btb/Telcon-Ambassador/photos/printer mechanism/IMG_4826.jpg

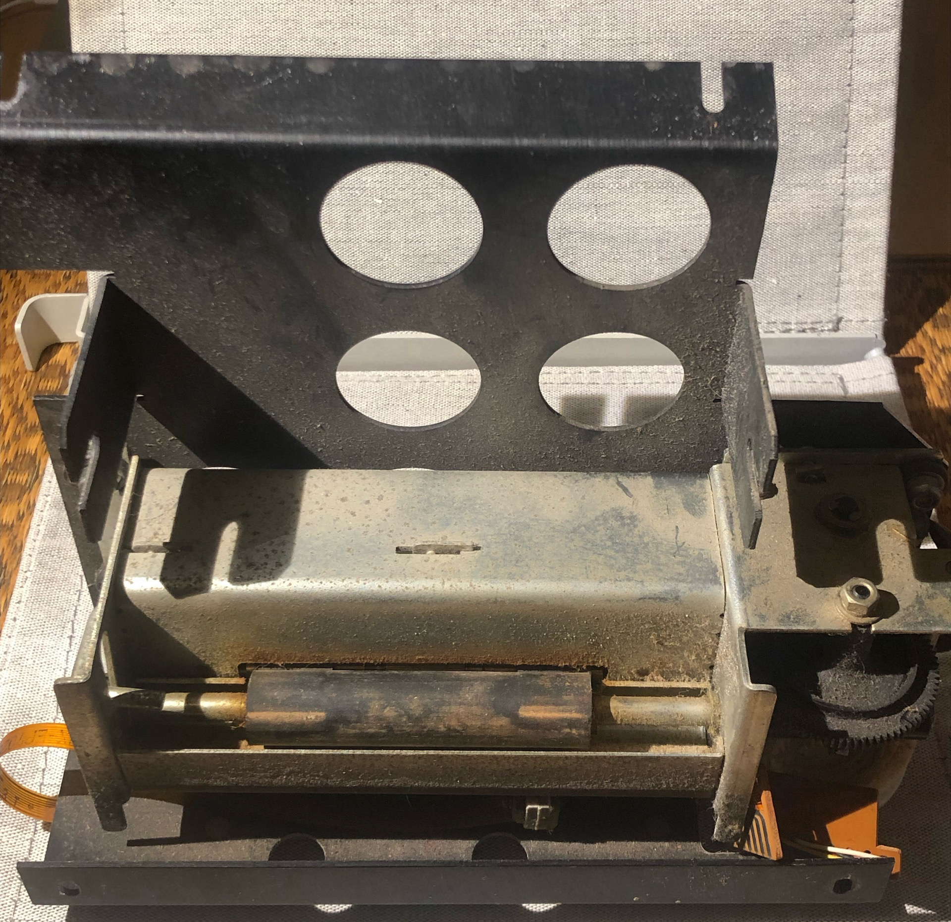
photos/printer mechanism/IMG_4826.jpg
