btb/Telcon-Ambassador/photos/printer mechanism/IMG_4764.jpg

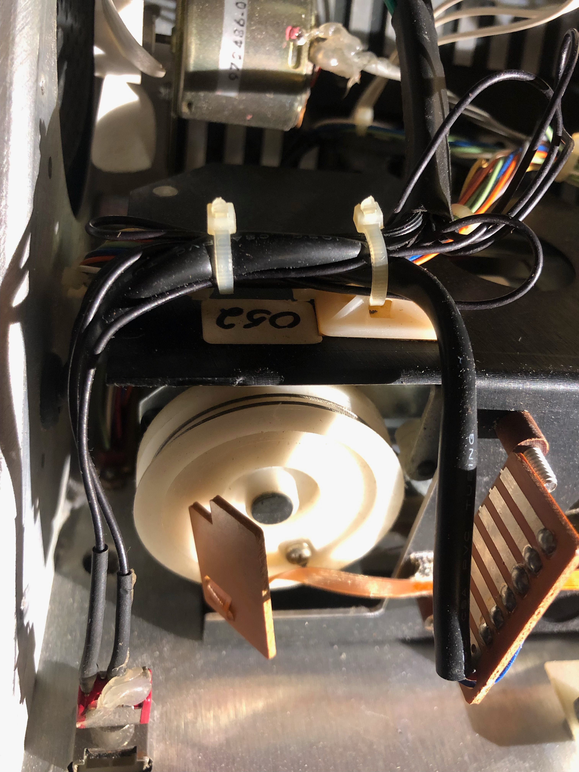
photos/printer mechanism/IMG_4764.jpg
