btb/Telcon-Ambassador/README.md

# Telcon Ambassador Portable Terminals

The Telcon Ambassador was a series of portable terminals by Telcon Industries (who later created the Zorba portable computer).

The info here is primarily derived from my reverse-engineering of a Telcon Ambassador IV which I acquired in very rough shape.
