btb/Telcon-Ambassador/photos/keyboard pcb/bottom_1.jpg

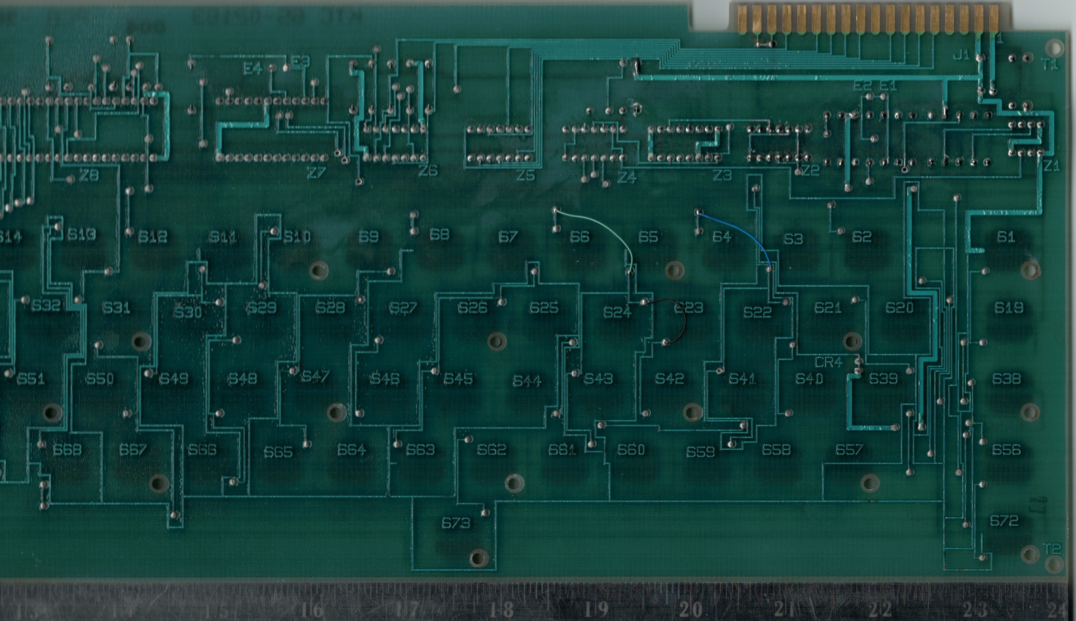
photos/keyboard pcb/bottom_1.jpg
