btb/Telcon-Ambassador/photos/keyboard pcb/bottom_2.jpg

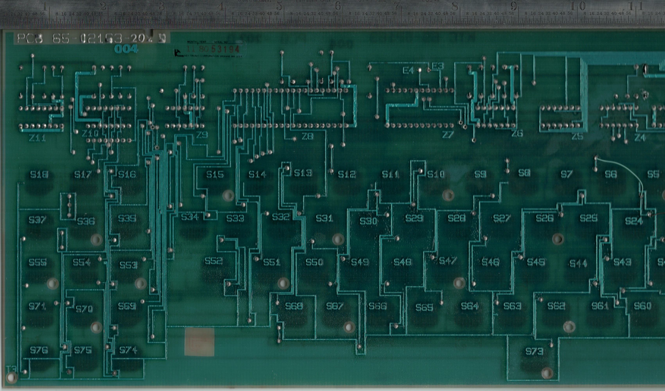
photos/keyboard pcb/bottom_2.jpg
