btb/Telcon-Ambassador/photos/ladouceur/Ladouceur_Telcon_1.jpg

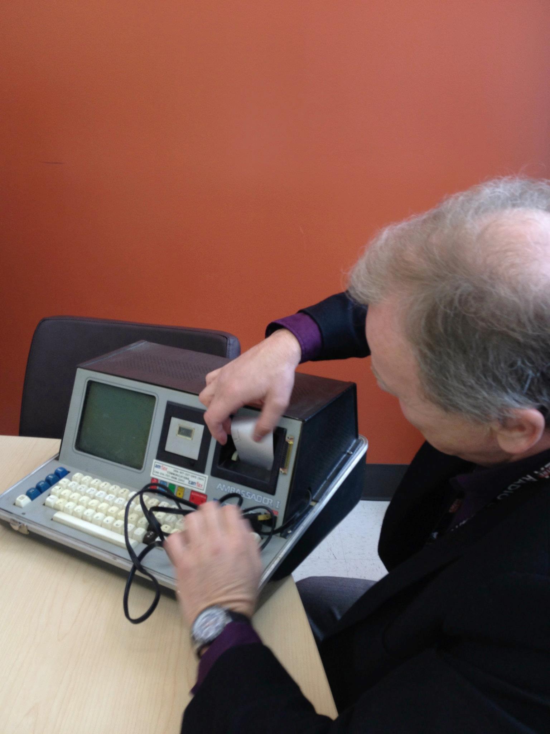
photos/ladouceur/Ladouceur_Telcon_1.jpg
