btb/Telcon-Ambassador/photos/ladouceur/Ladouceur_Telcon_2.jpg

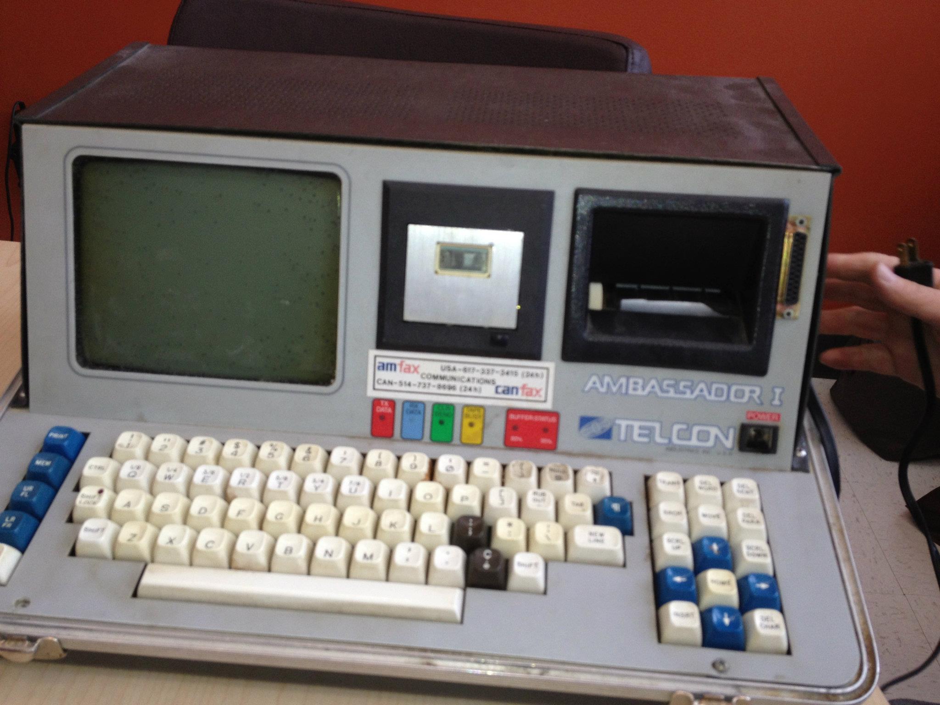
photos/ladouceur/Ladouceur_Telcon_2.jpg
