btb/Telcon-Ambassador/photos/printer mechanism/IMG_4766.jpg

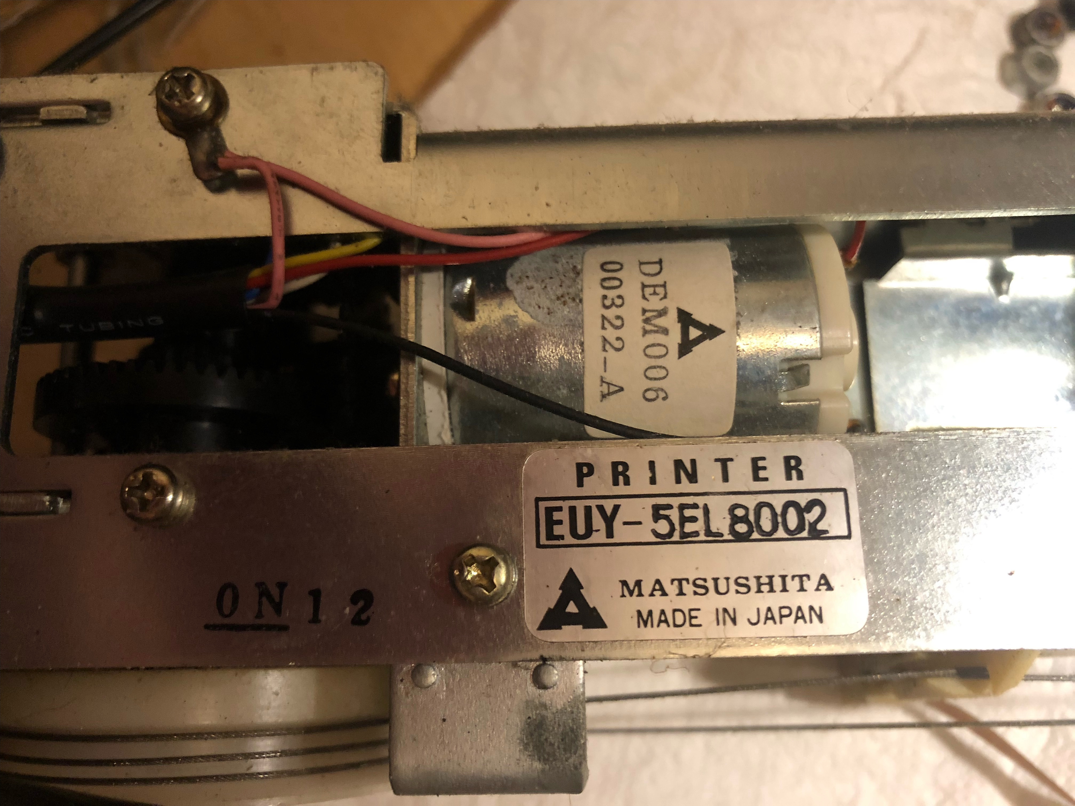
photos/printer mechanism/IMG_4766.jpg
