btb/Telcon-Ambassador/photos/printer pcb/bottom.jpg

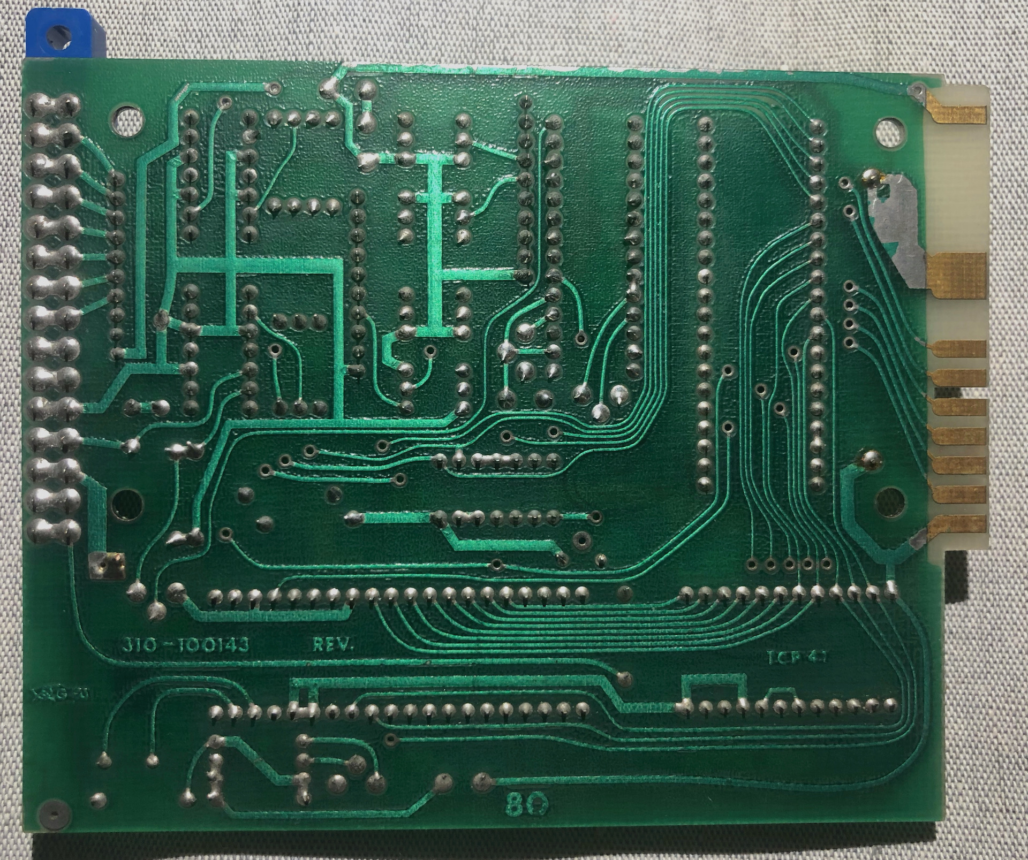
photos/printer pcb/bottom.jpg
