btb/Telcon-Ambassador/photos/printer pcb/top.jpg

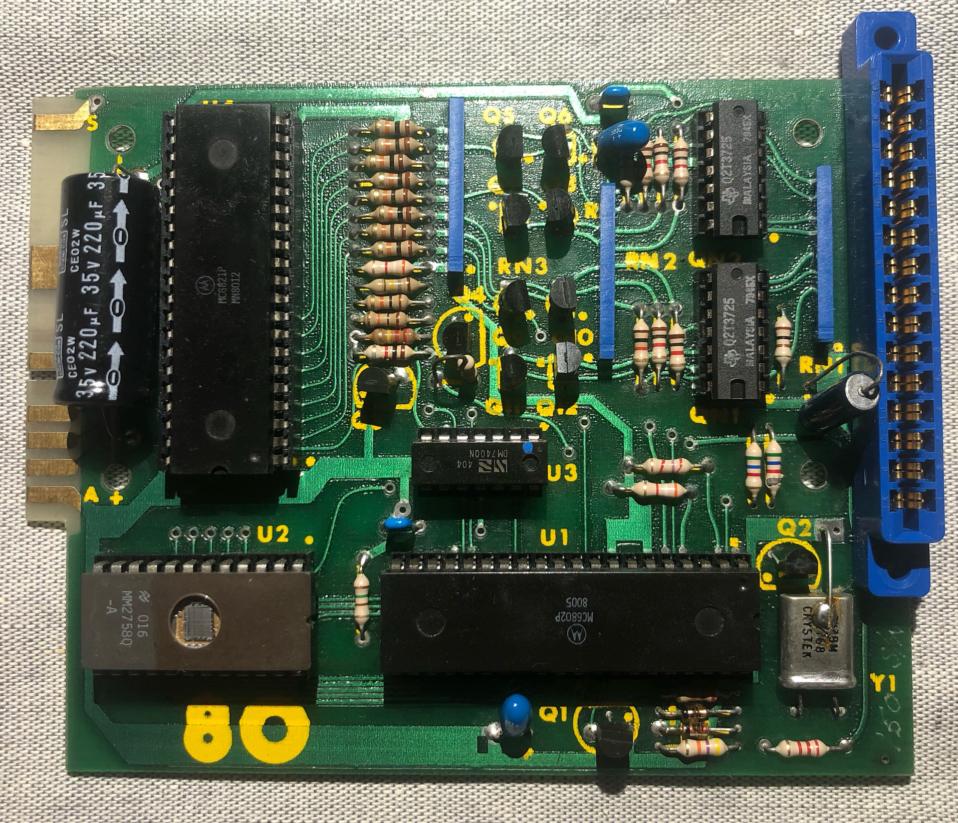
photos/printer pcb/top.jpg
