btb/Telcon-Ambassador/boards/printer/printer.pdf

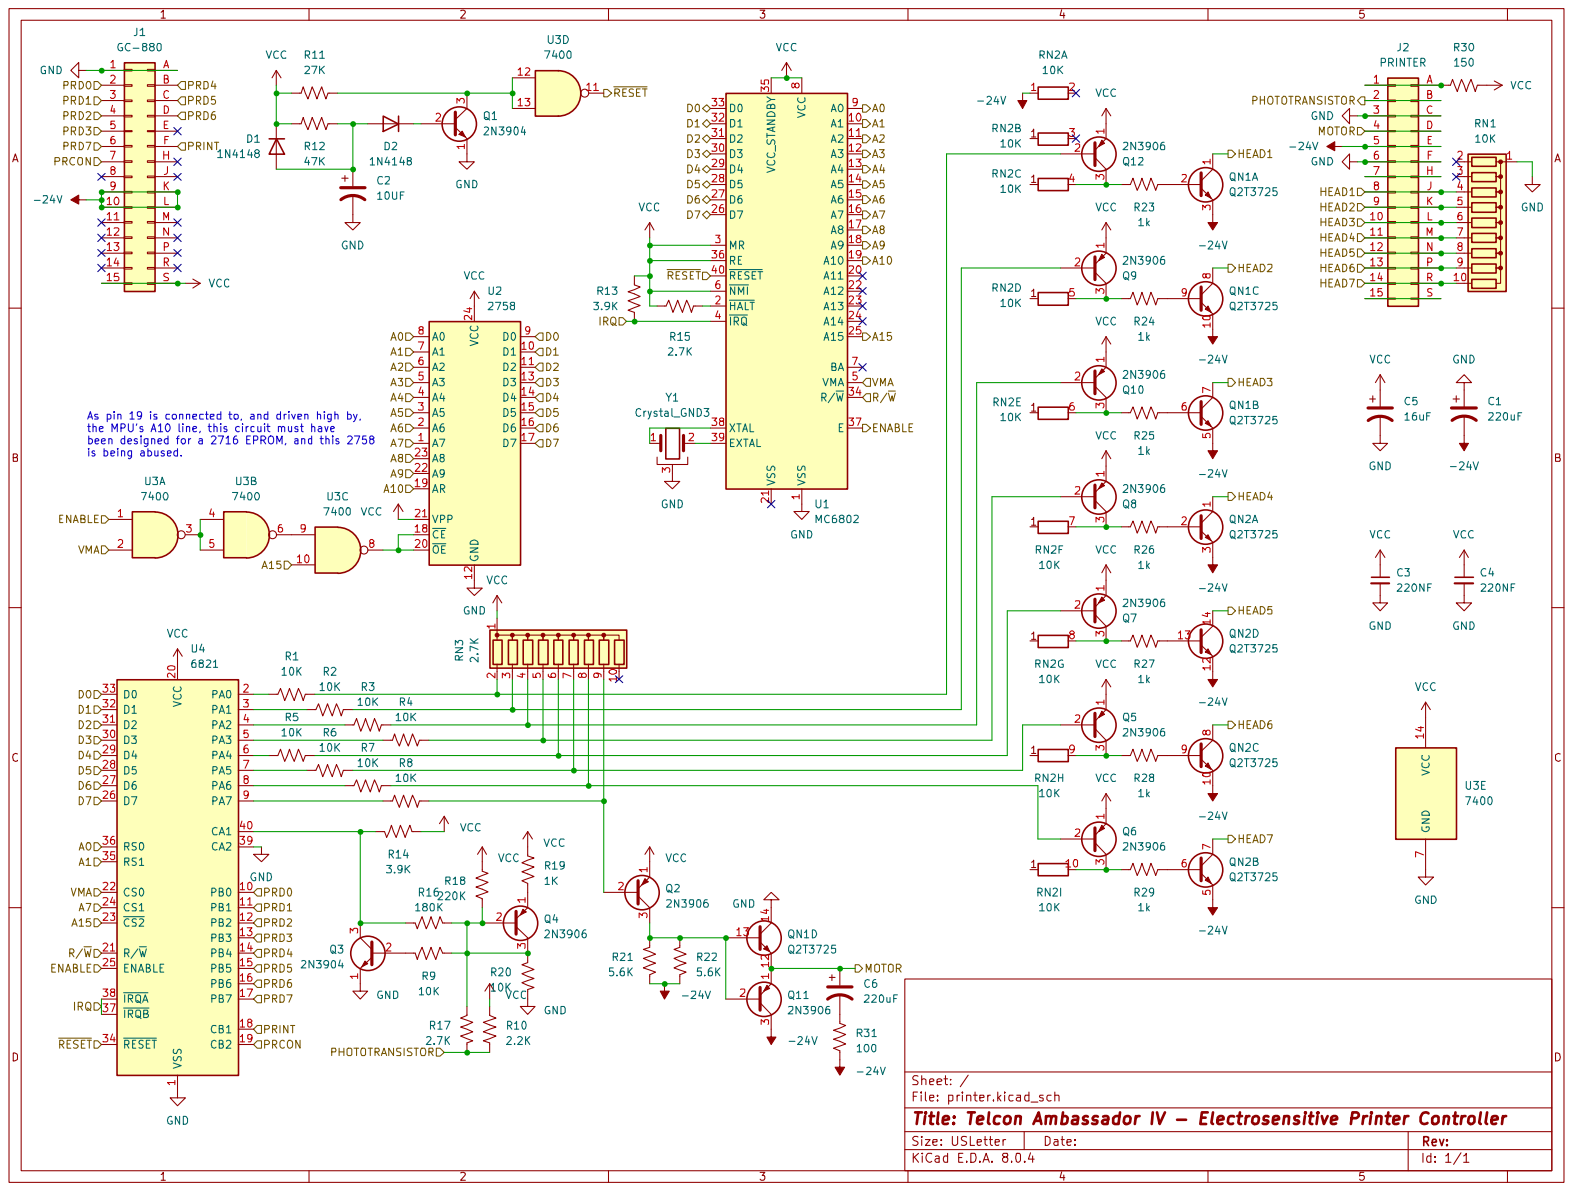
[picture p10: page 1]
