btb/Telcon-Ambassador/boards/mainboard/mainboard.pdf

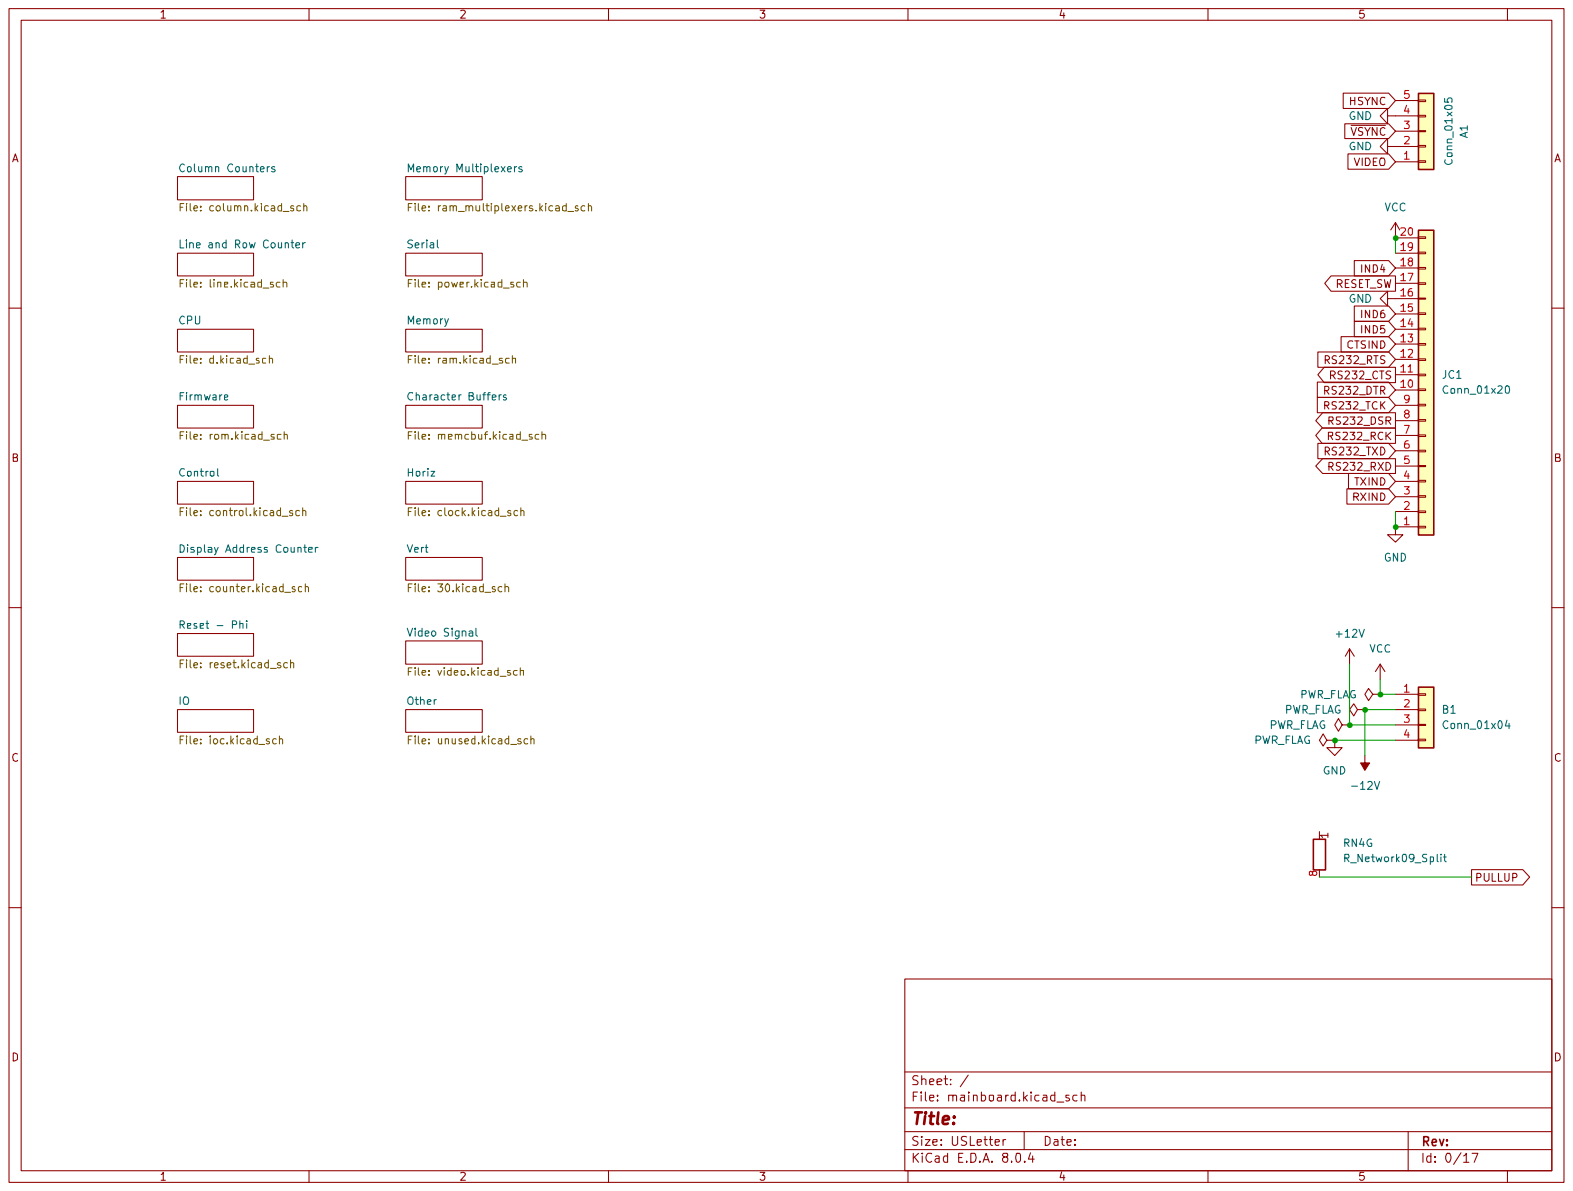
[picture p11: page 1]

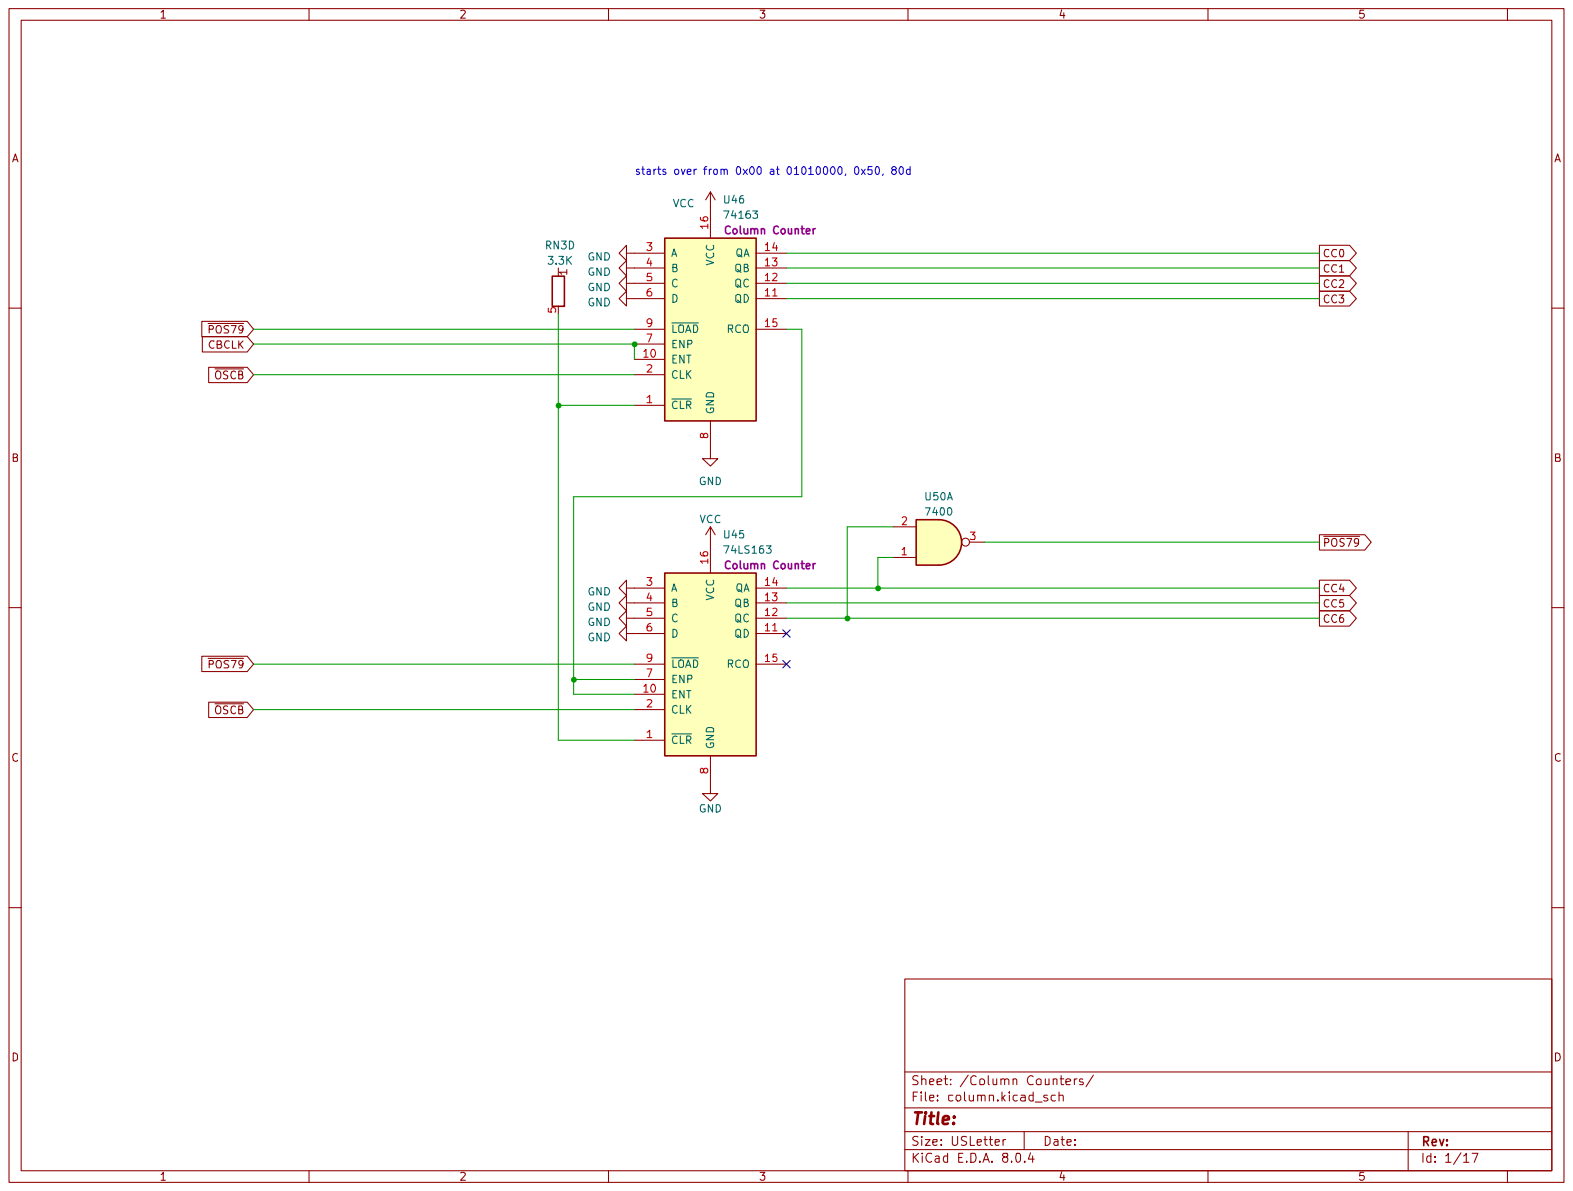
[picture p12: page 2]

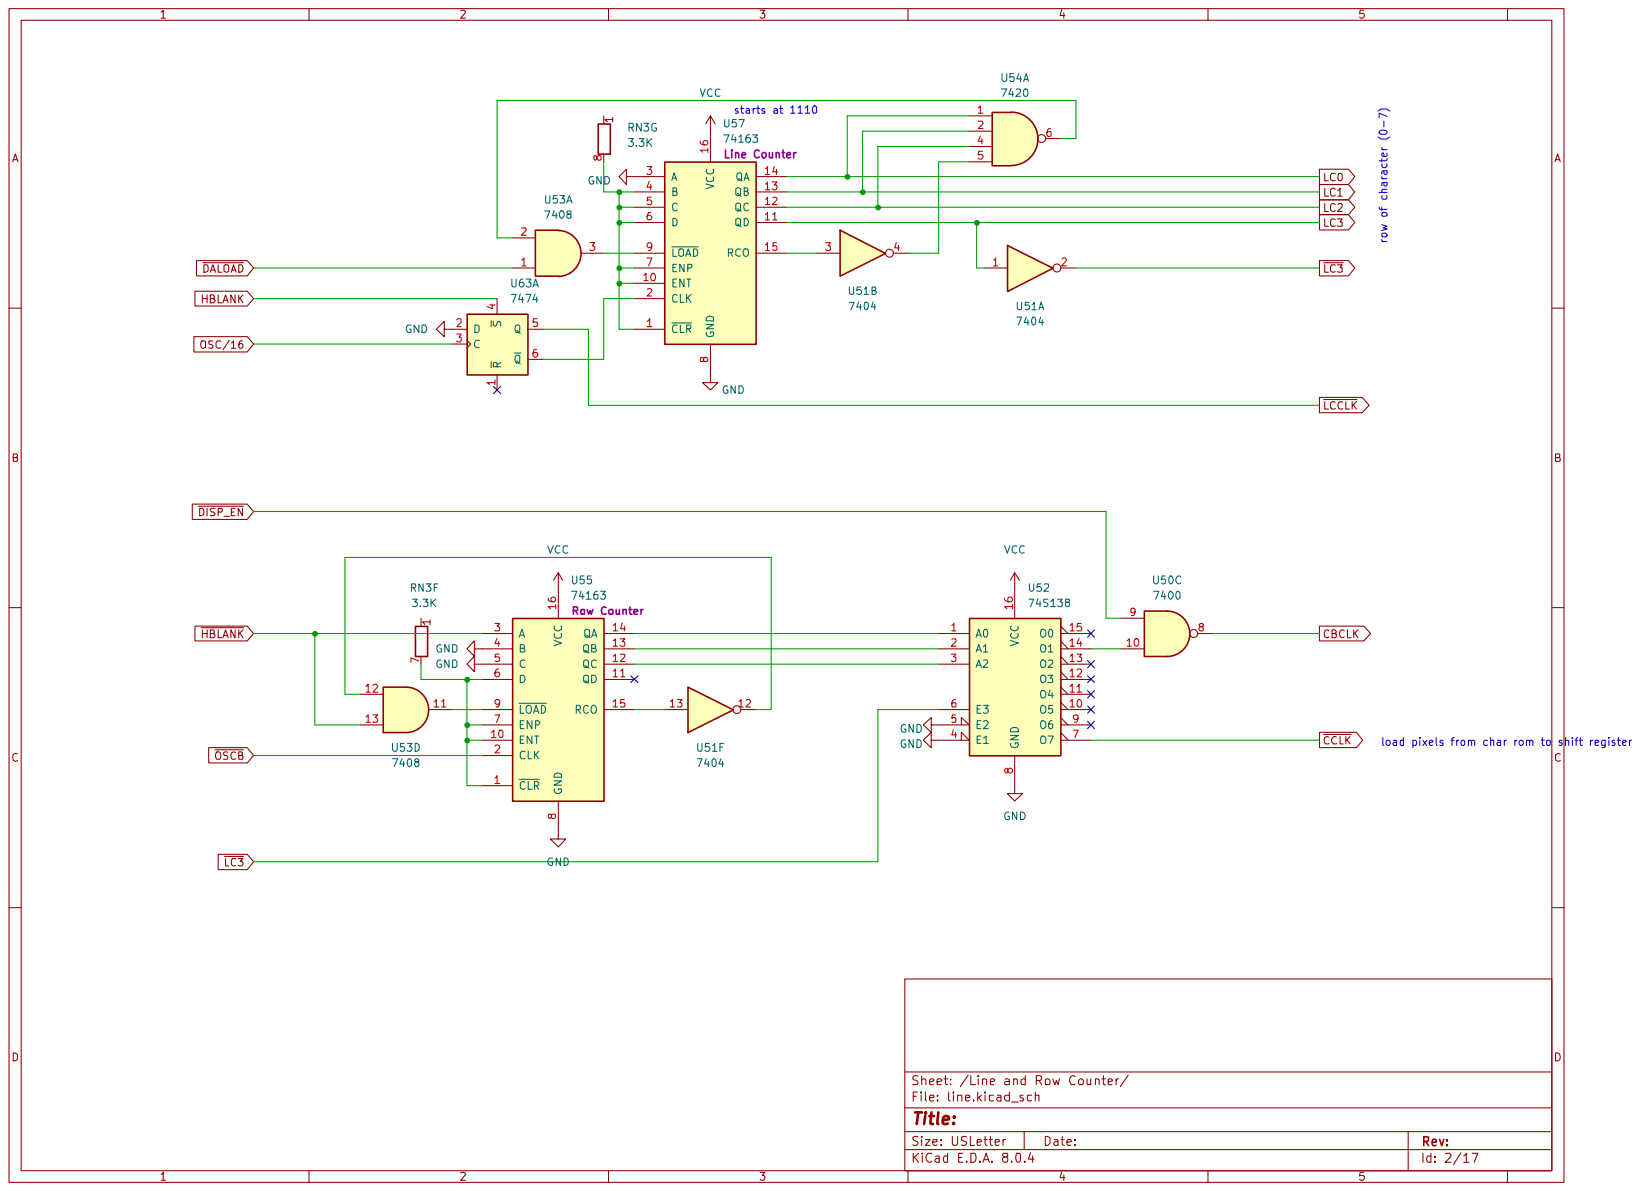
[picture p13: page 3]

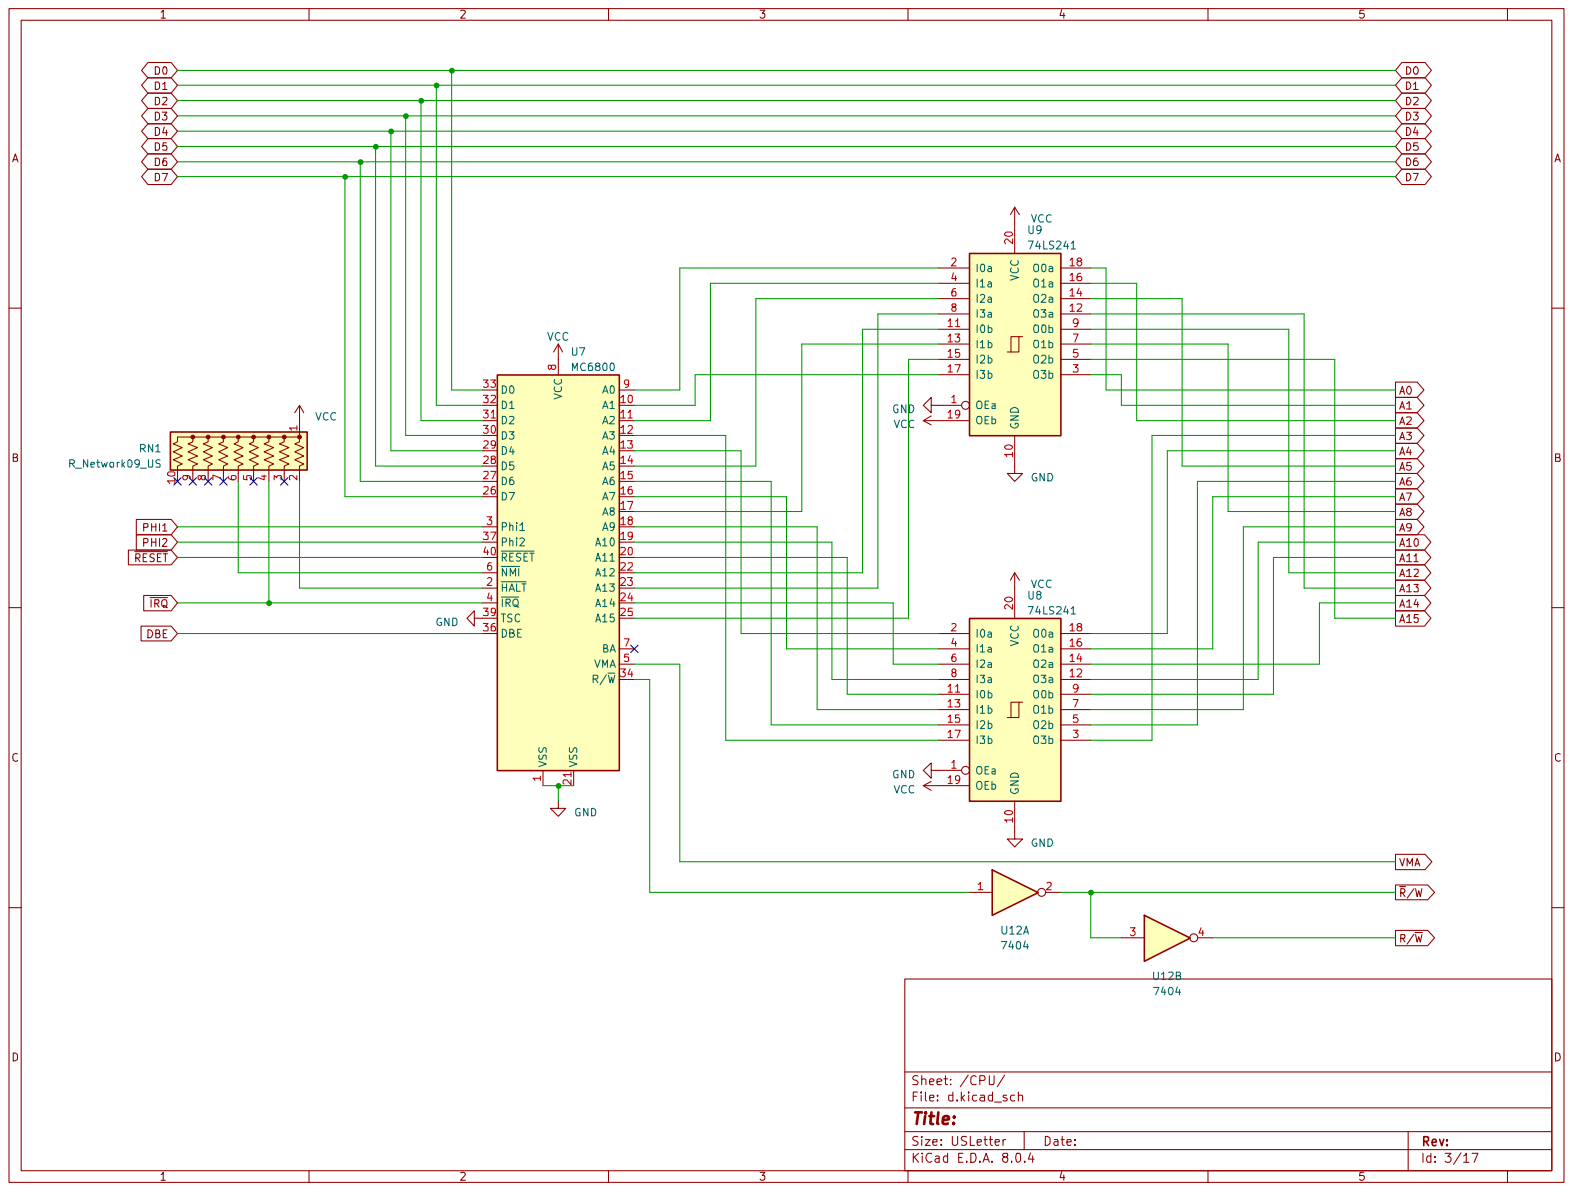
[picture p14: page 4]

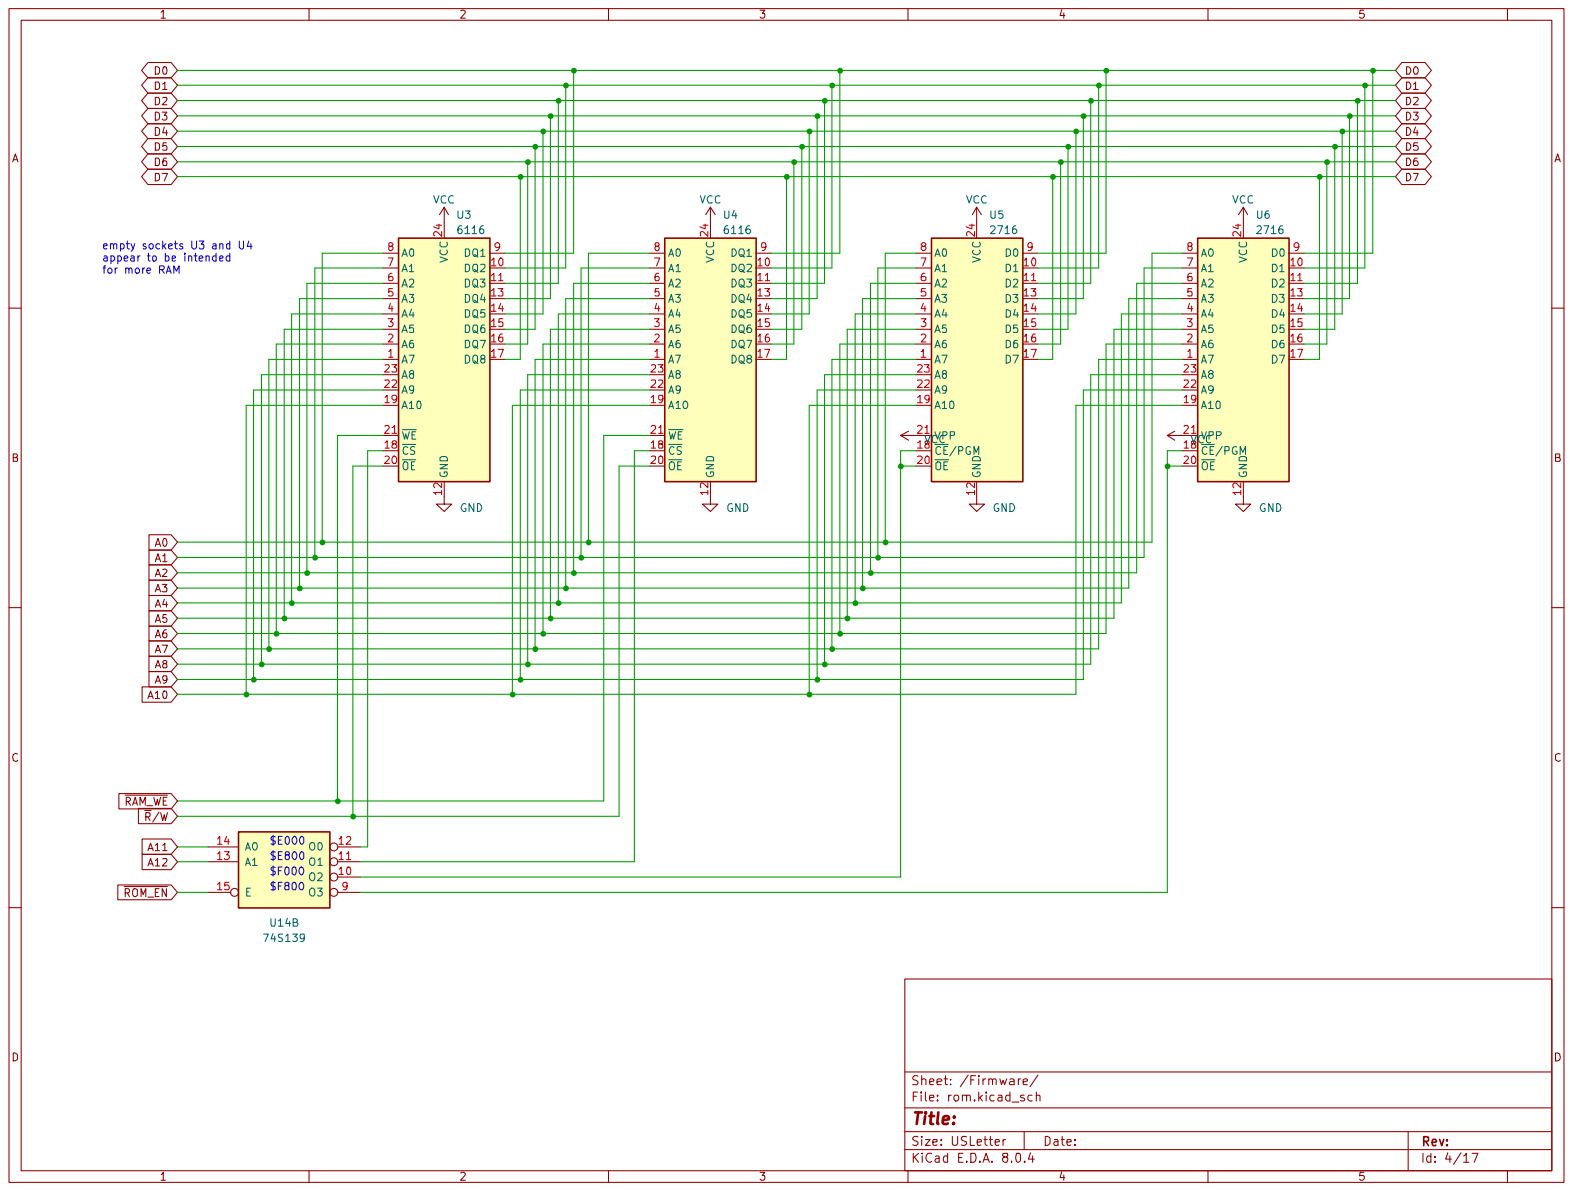
[picture p15: page 5]

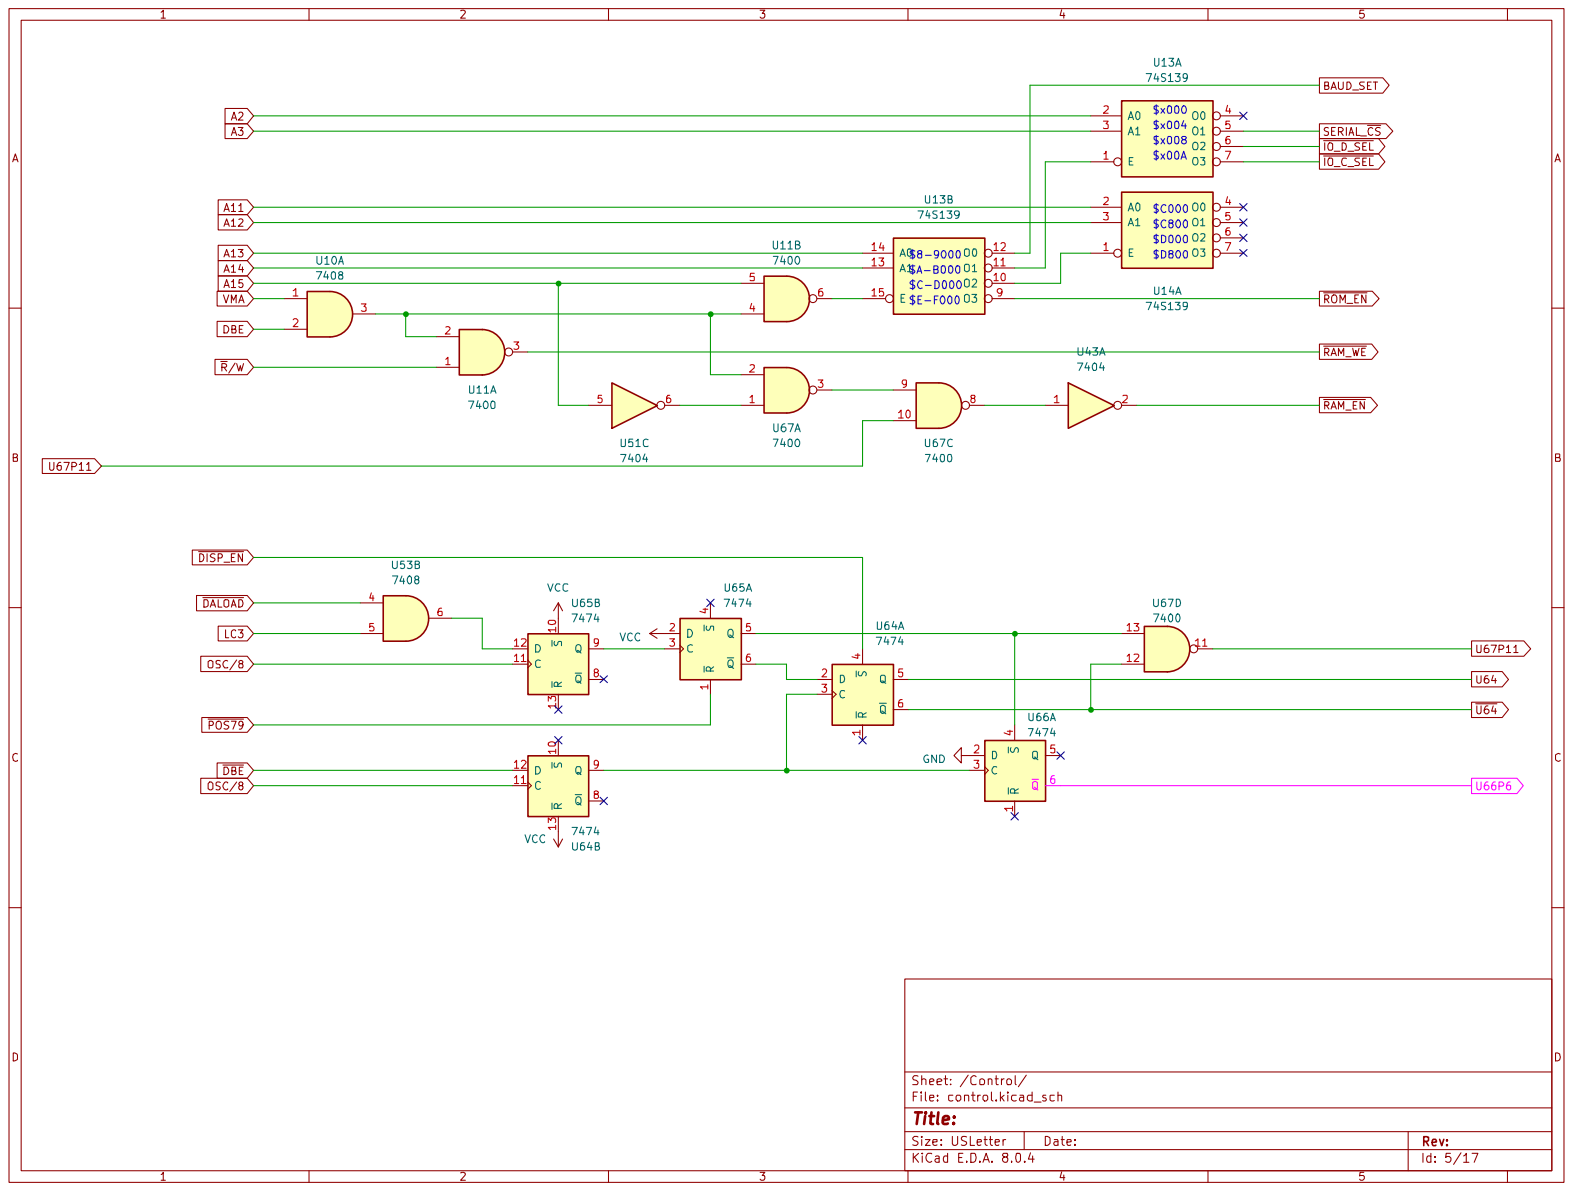
[picture p16: page 6]

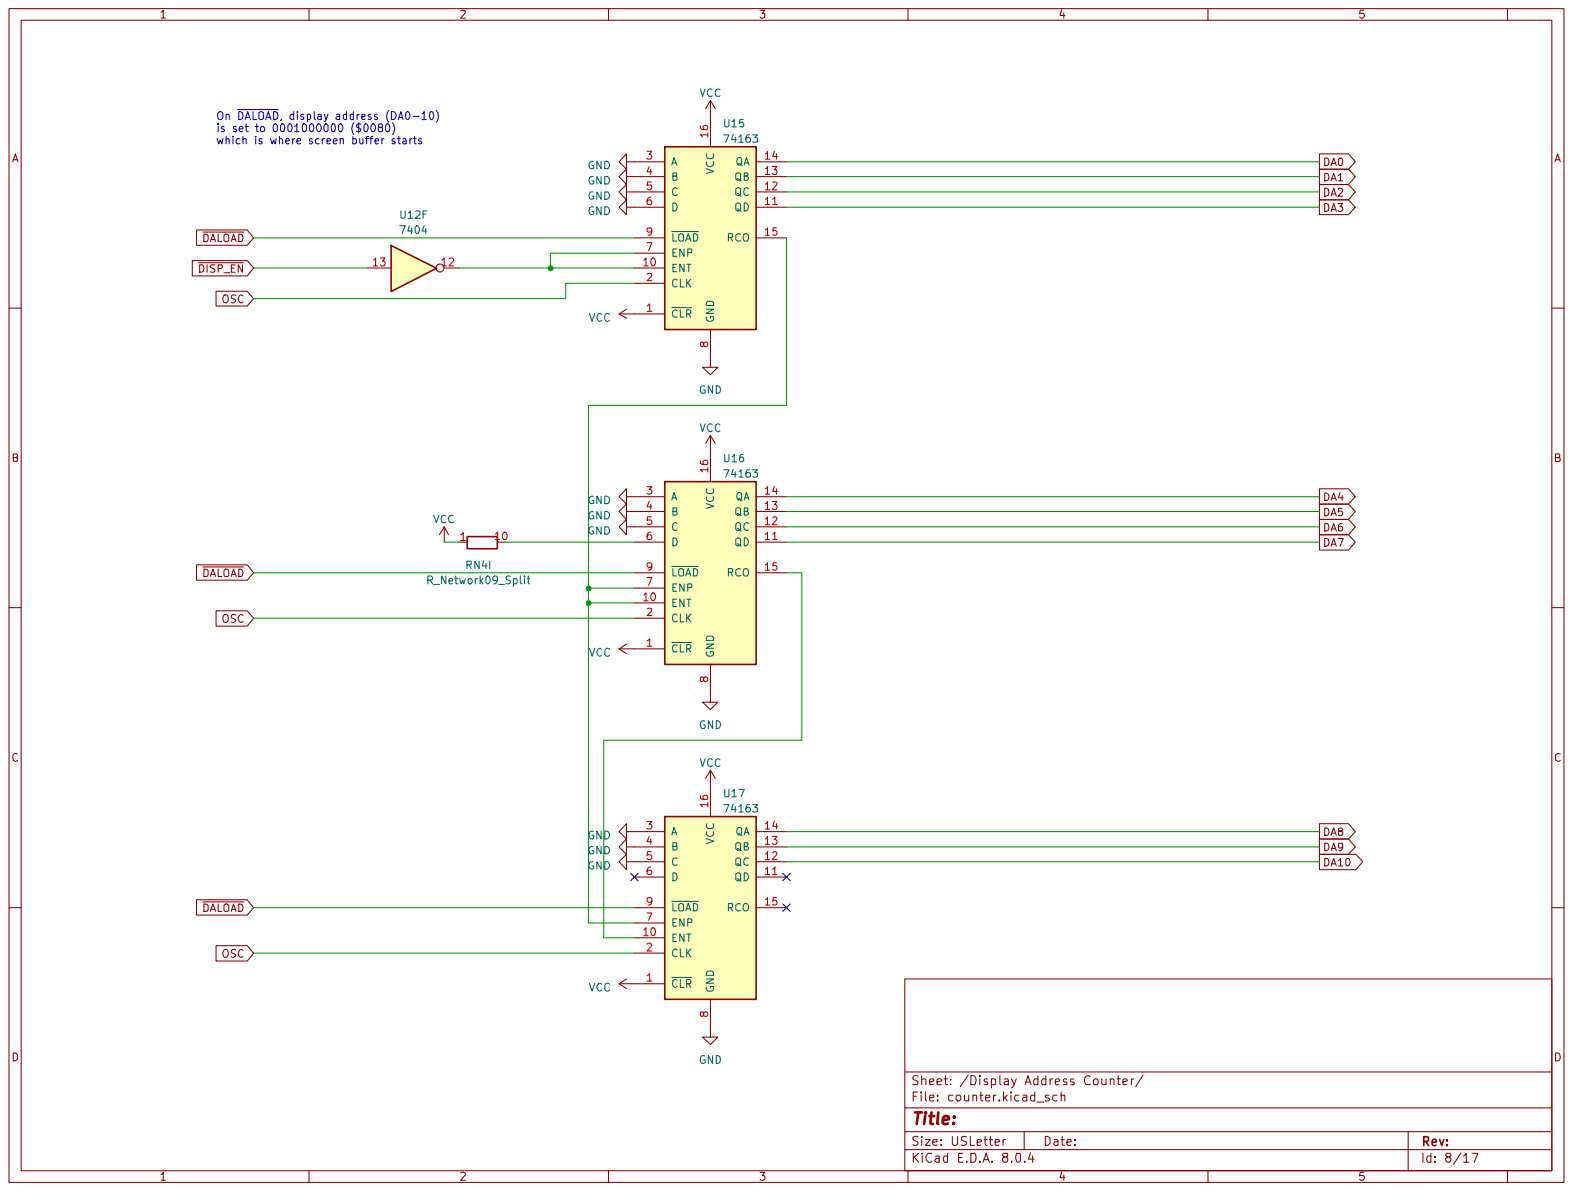
[picture p17: page 7]

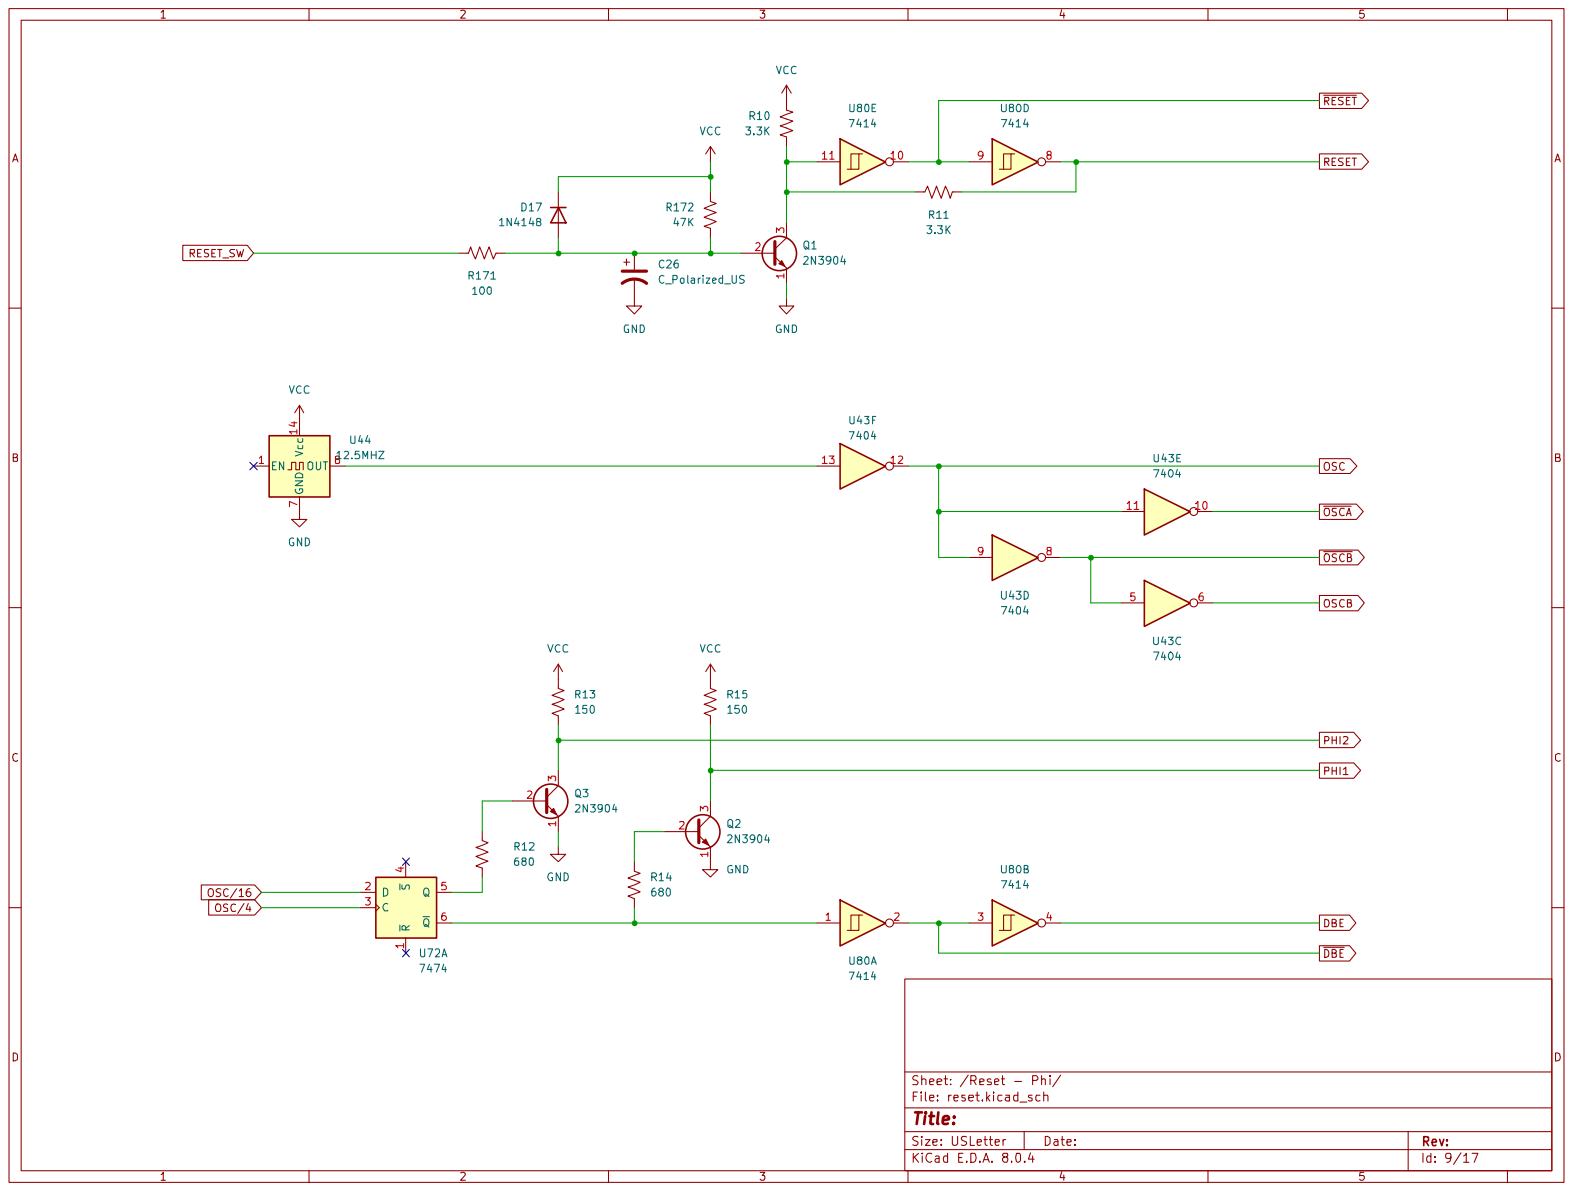
[picture p18: page 8]

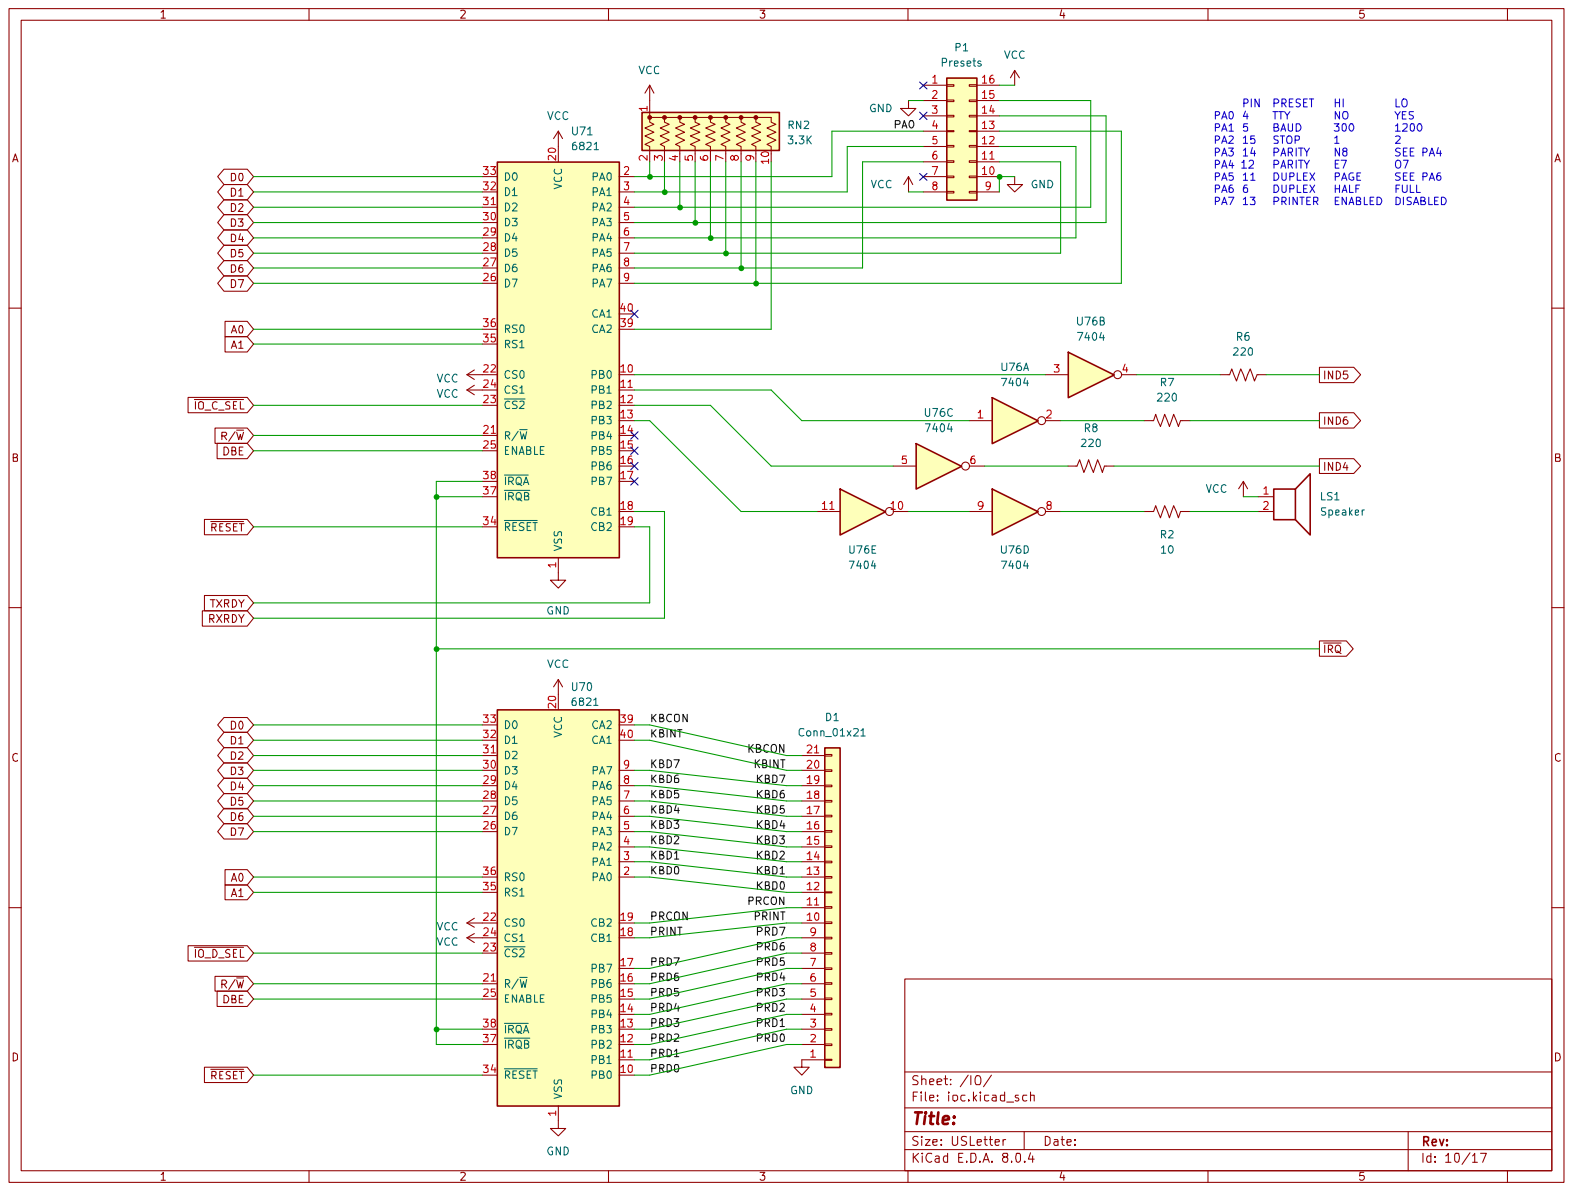
[picture p19: page 9]

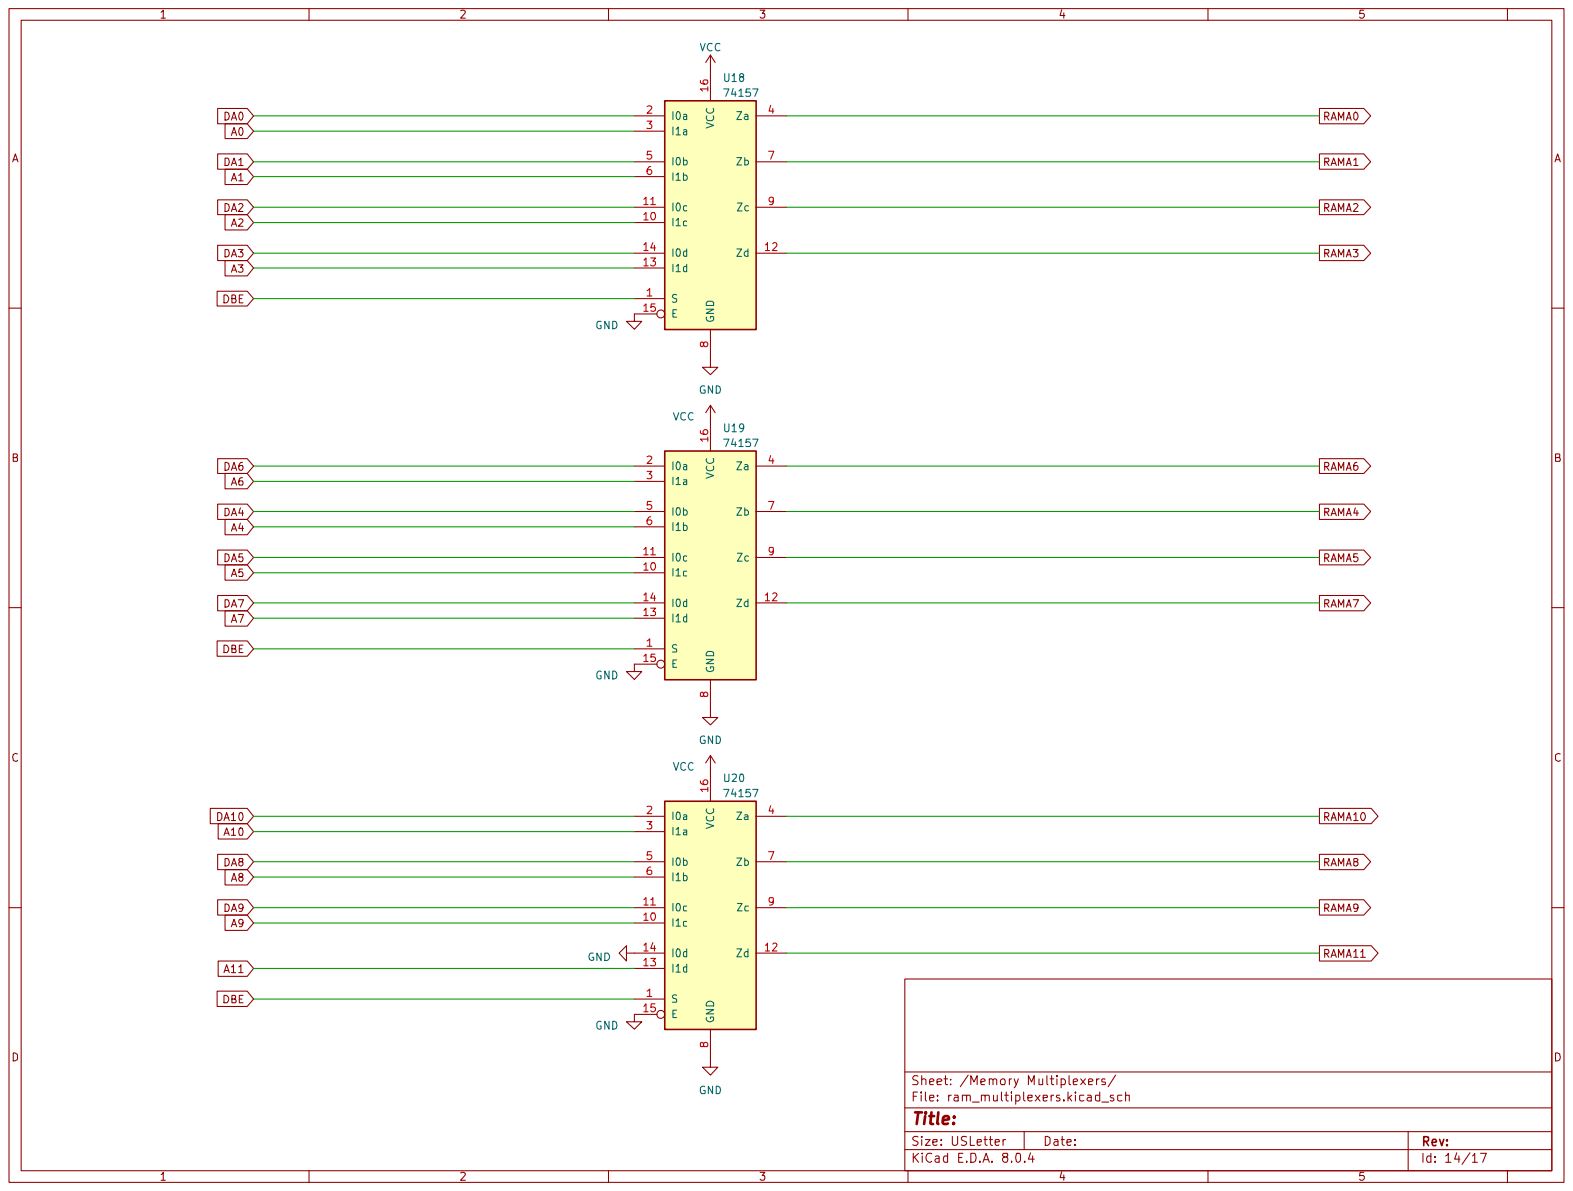
[picture p20: page 10]

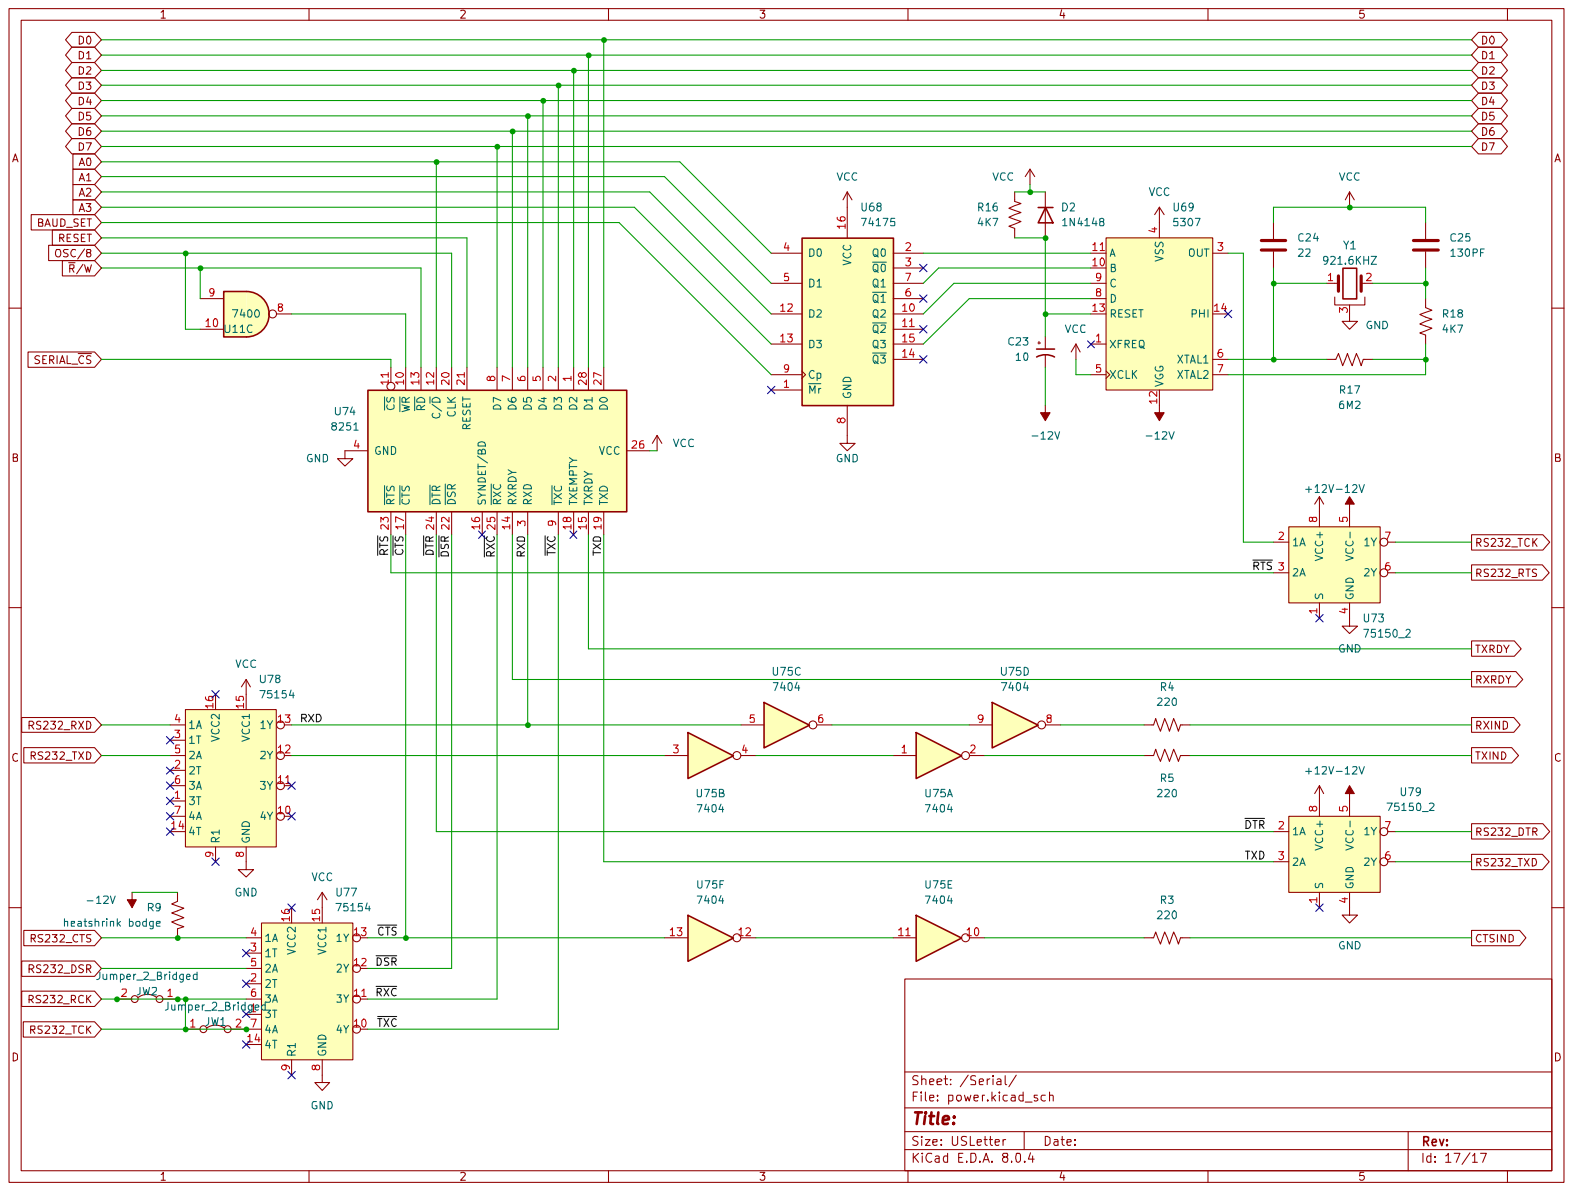
[picture p21: page 11]

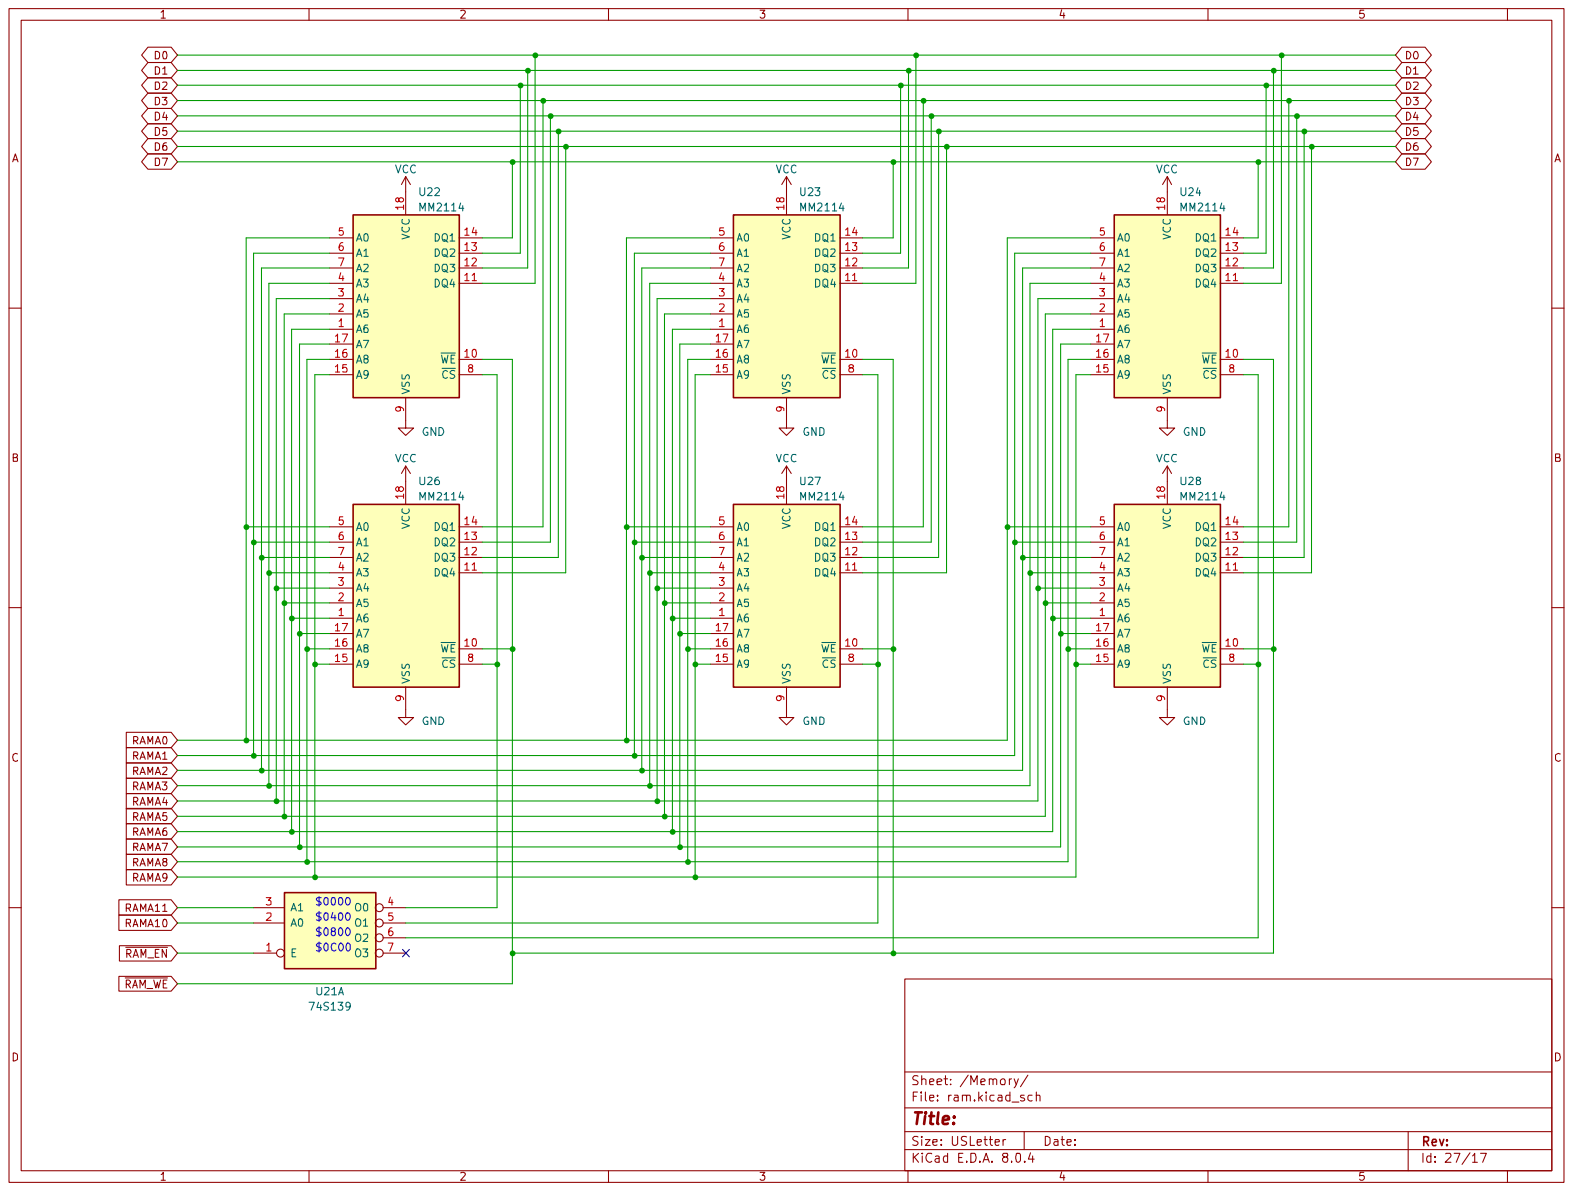
[picture p22: page 12]

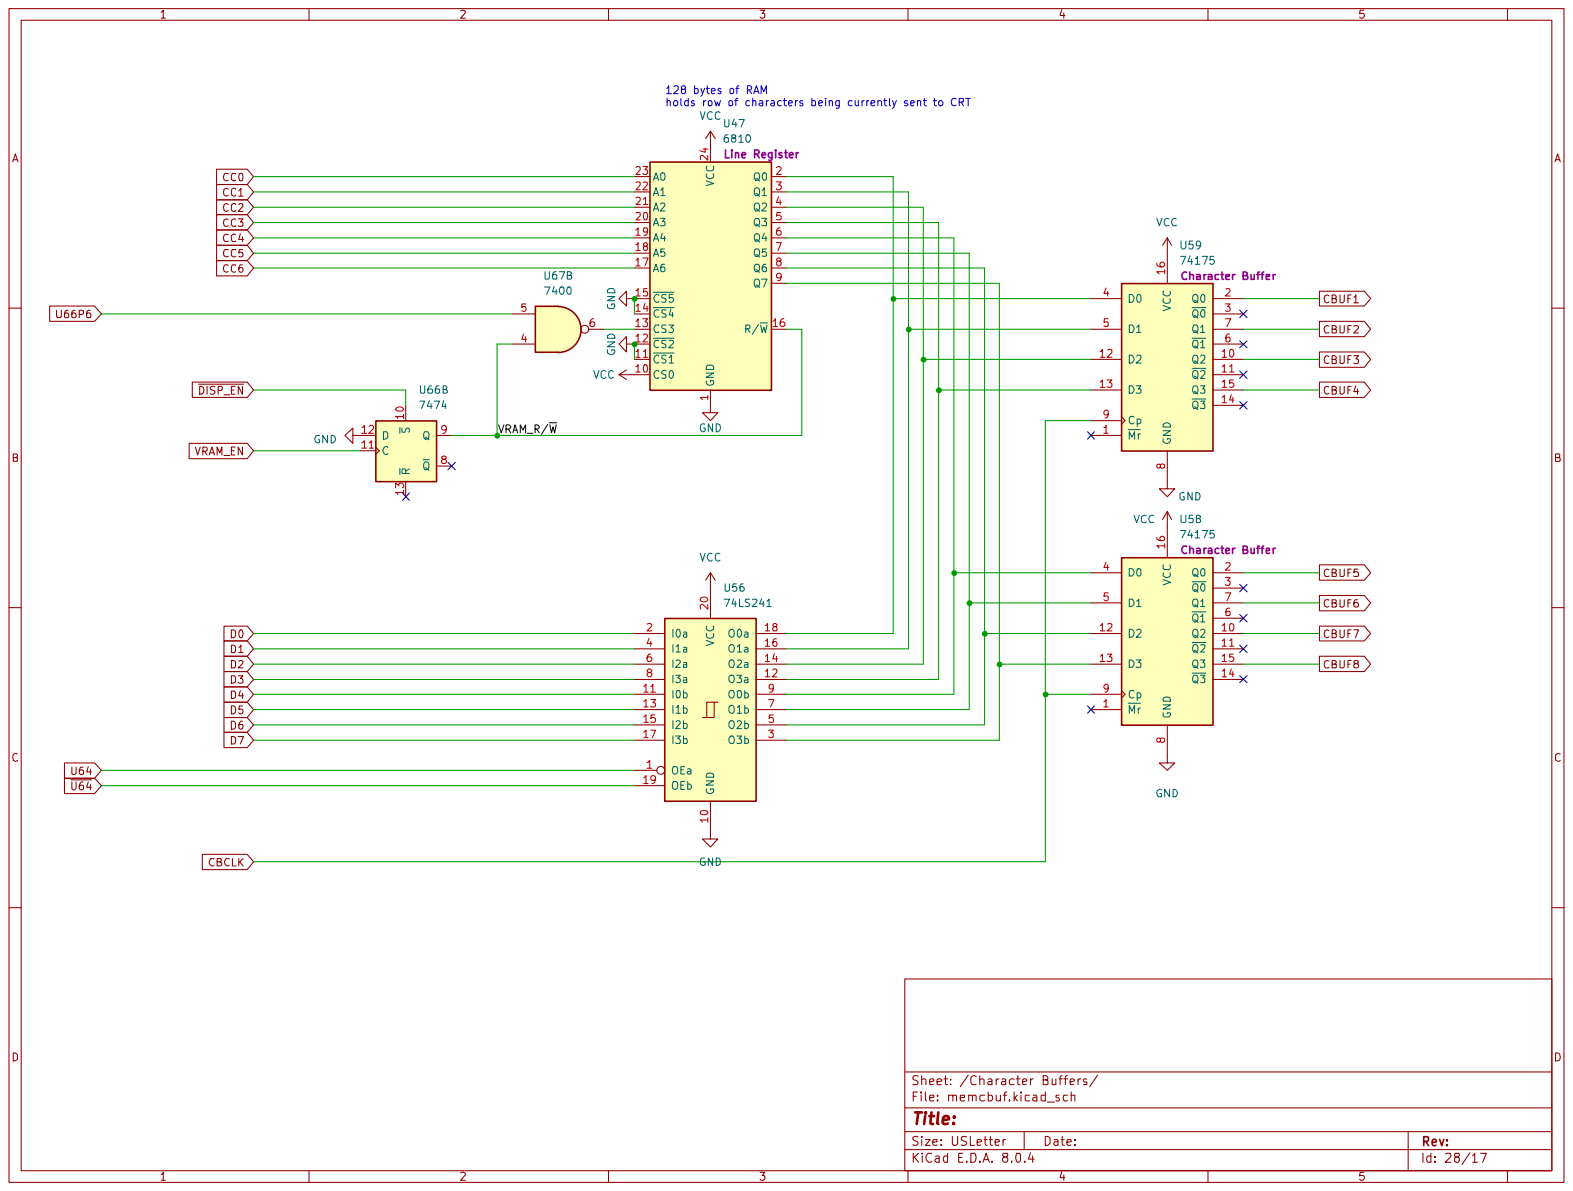
[picture p23: page 13]

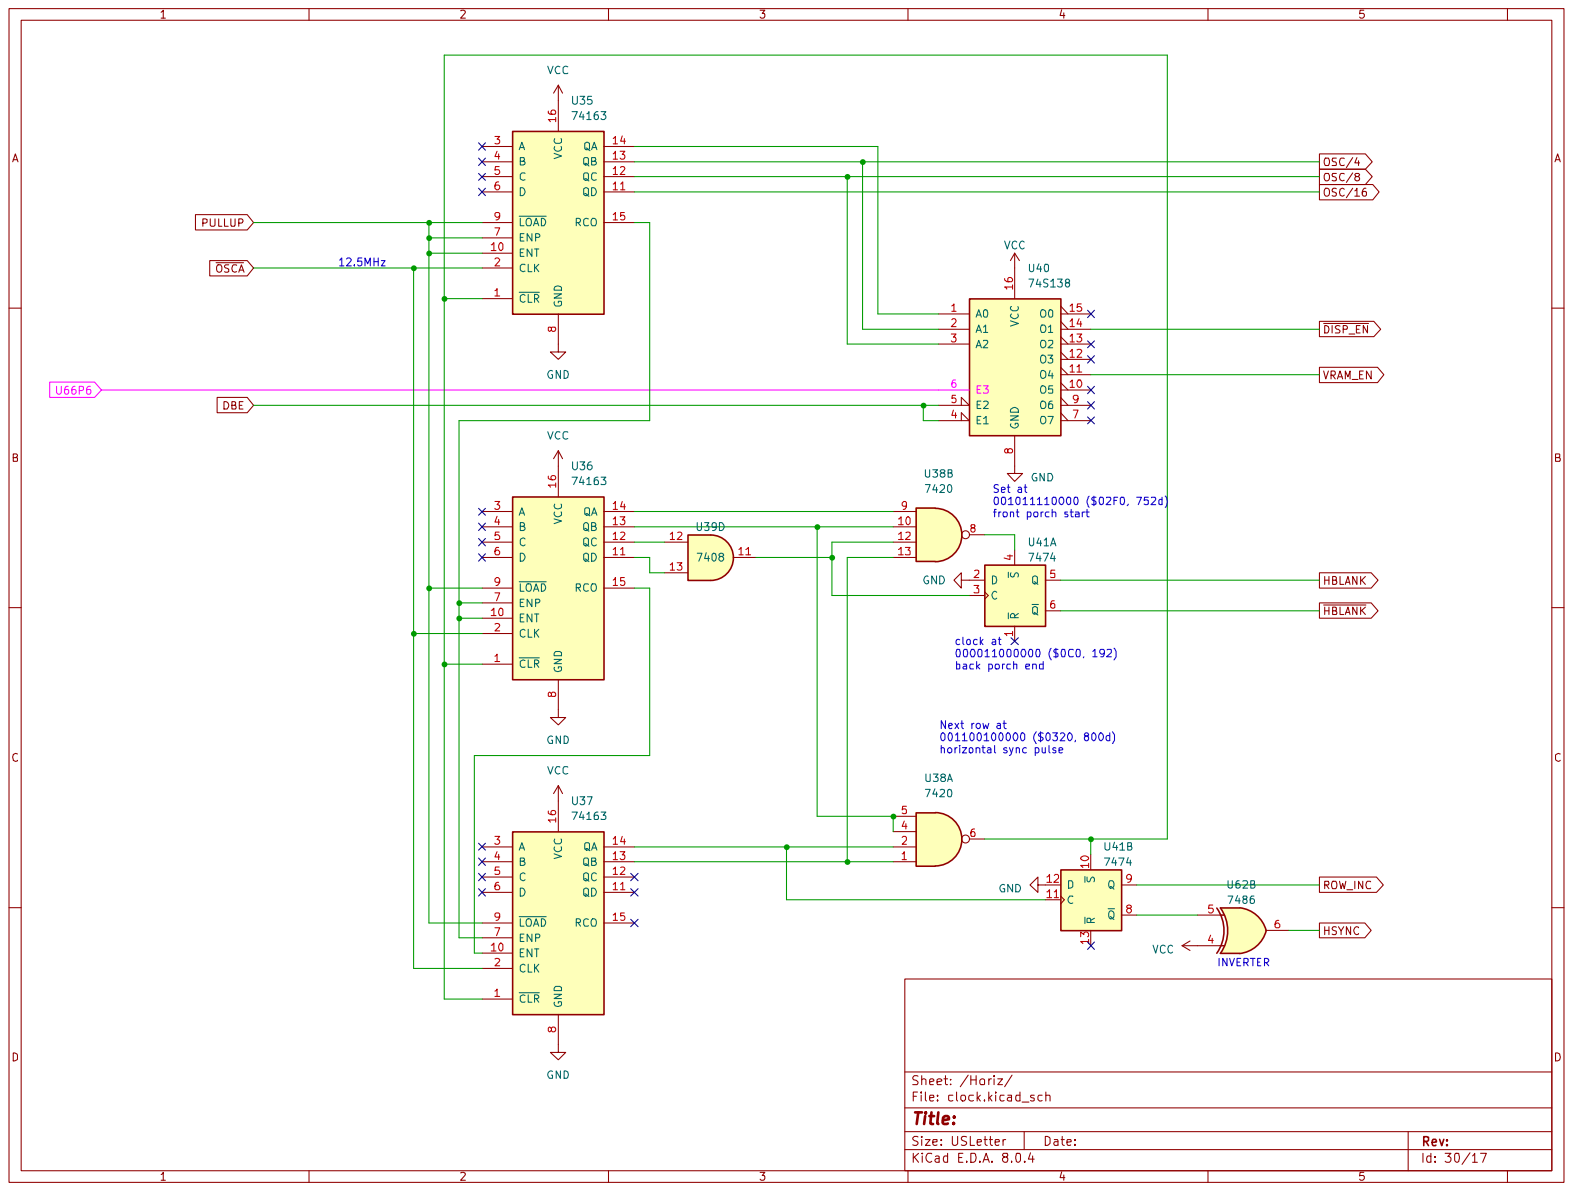
[picture p24: page 14]

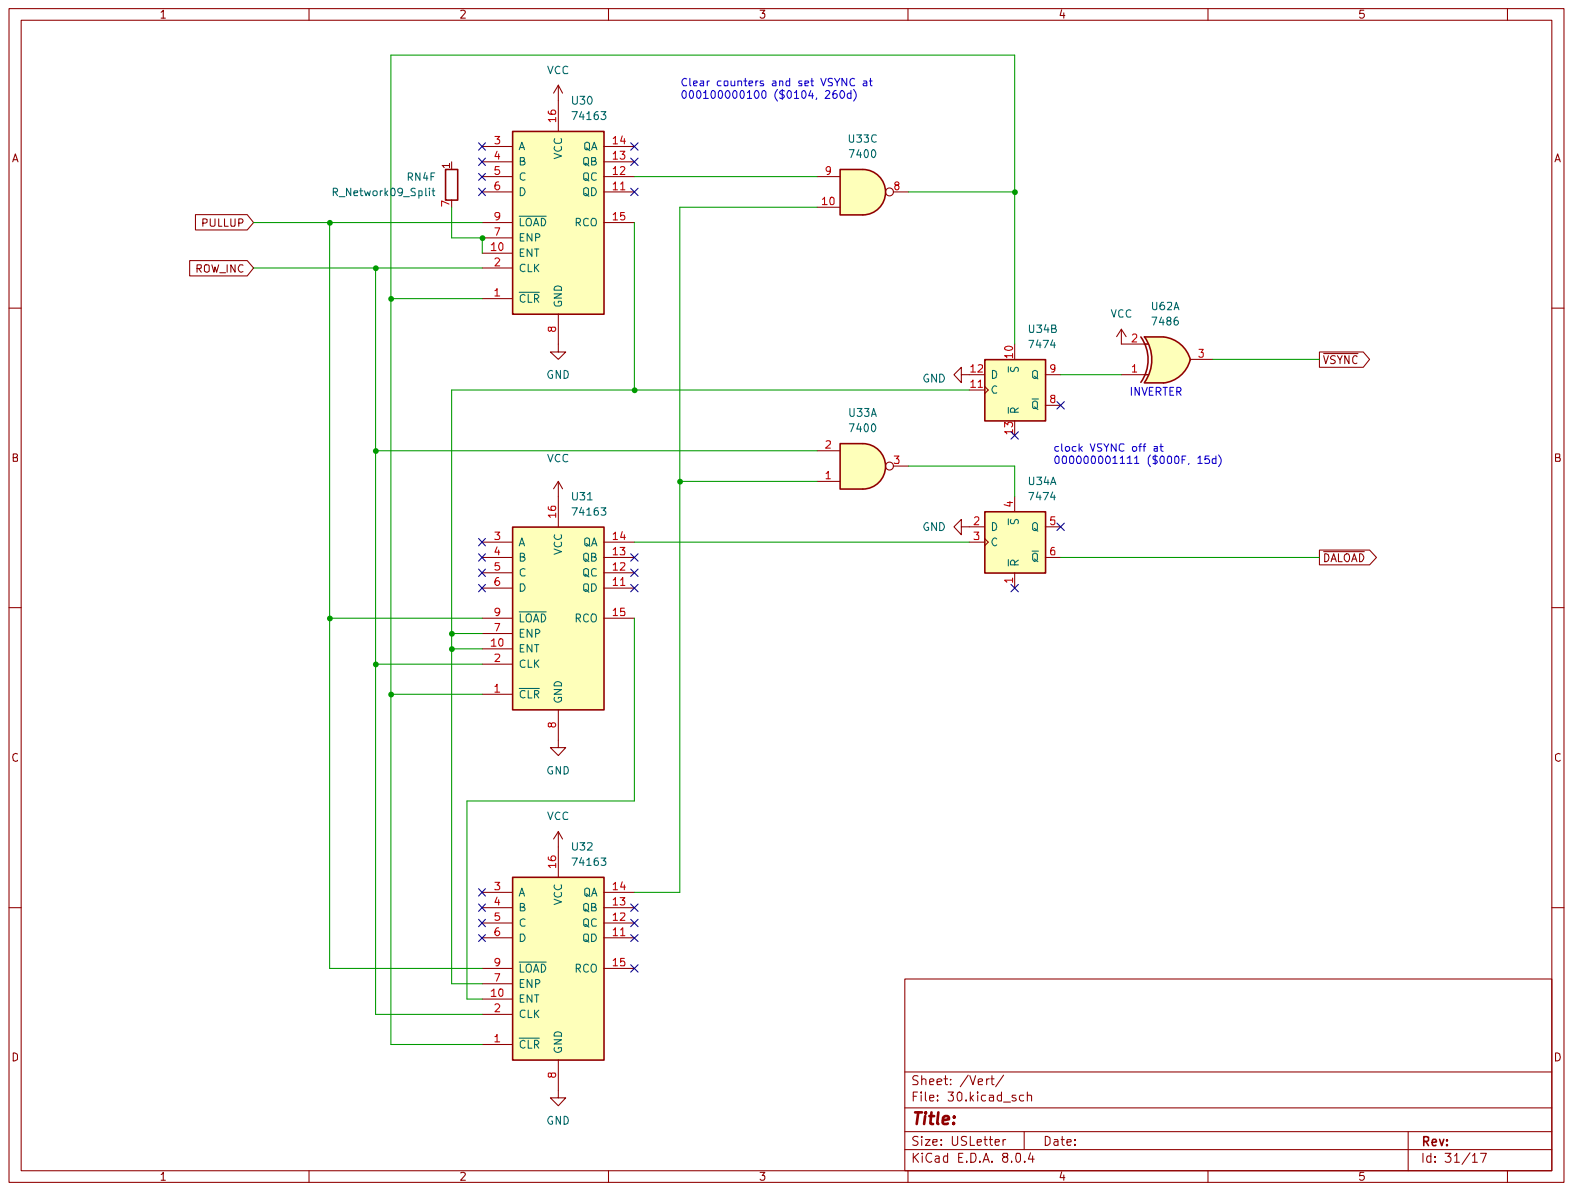
[picture p25: page 15]

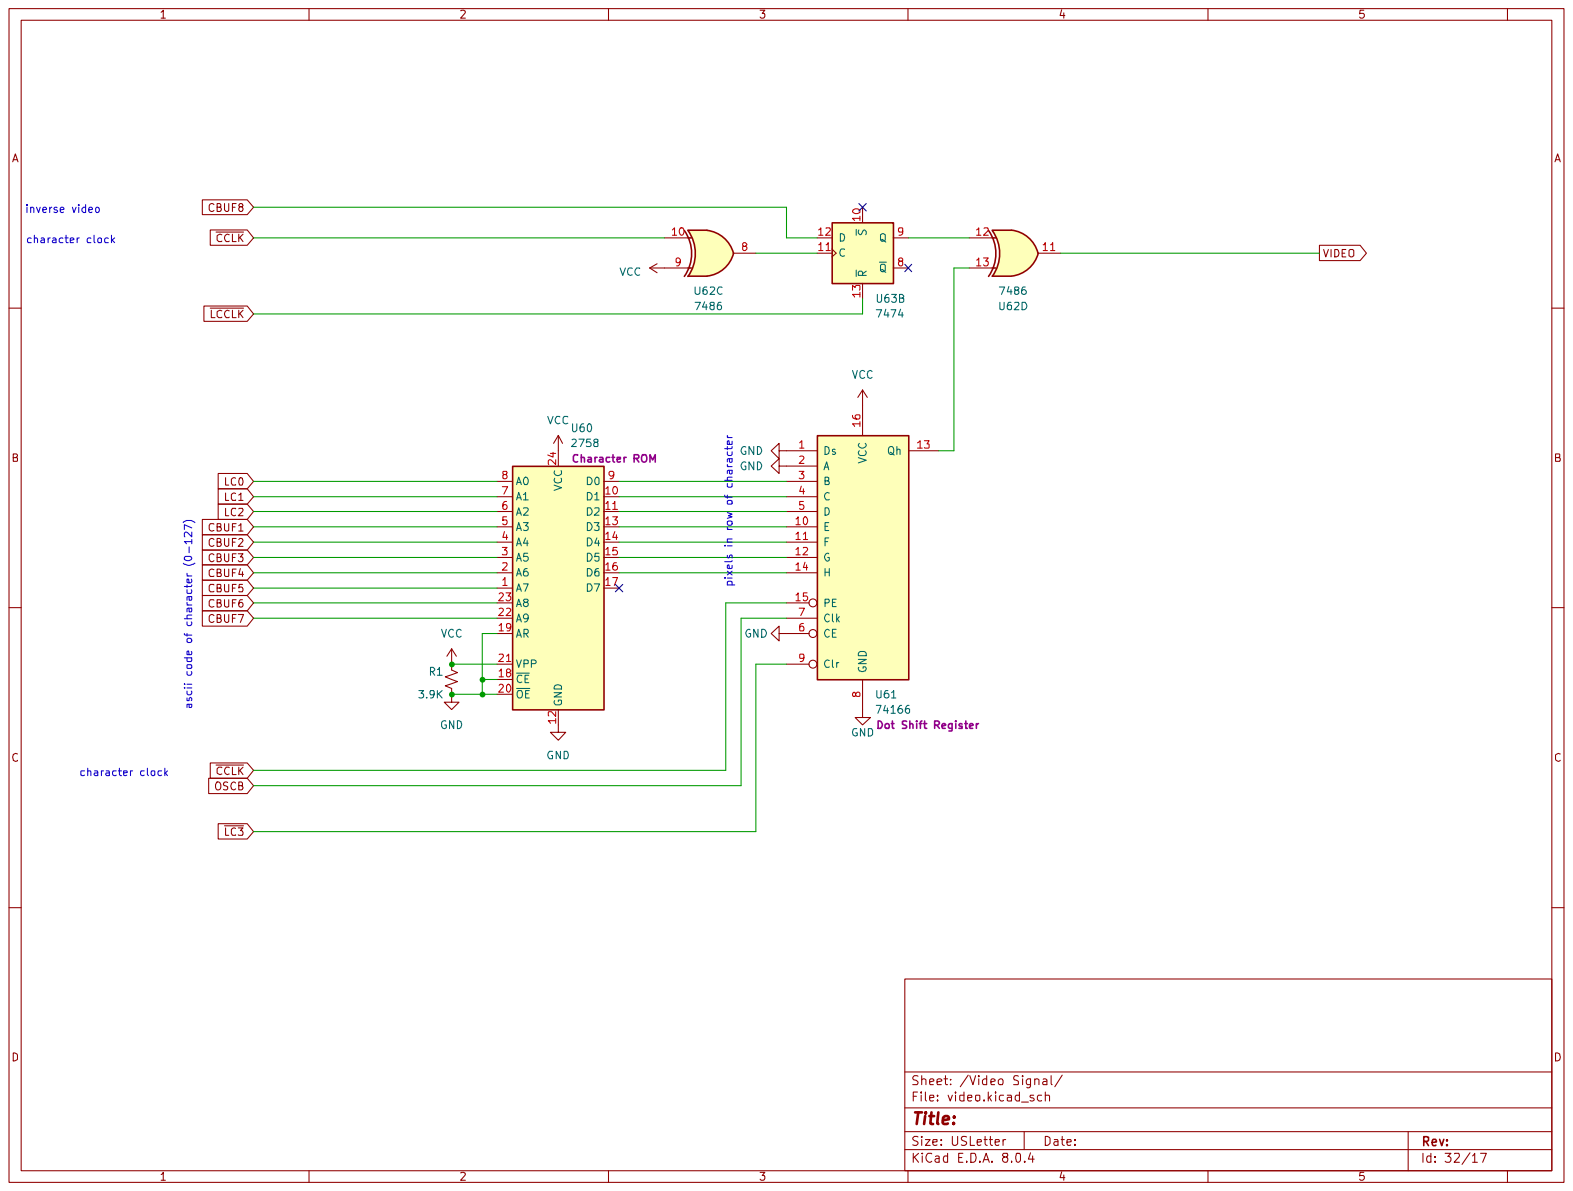
[picture p26: page 16]

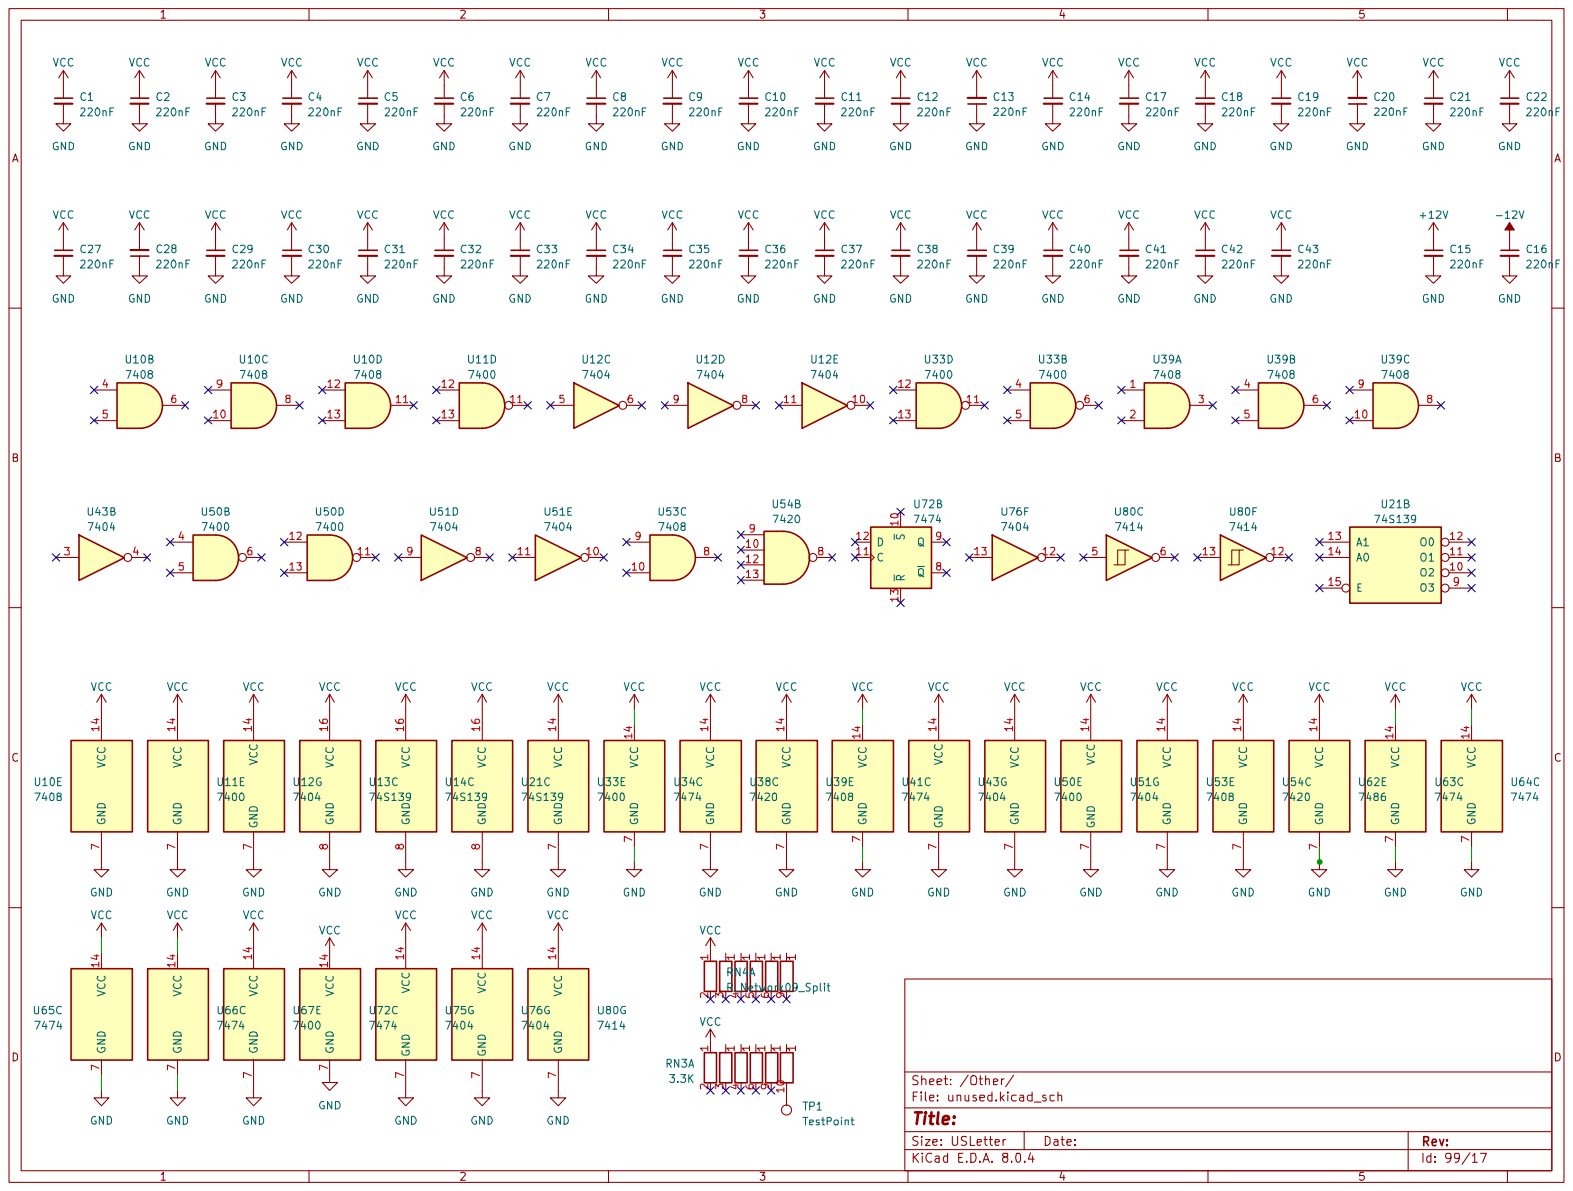
[picture p27: page 17]
