btb/Telcon-Ambassador/boards/keyboard/ktc_65-02163.pdf

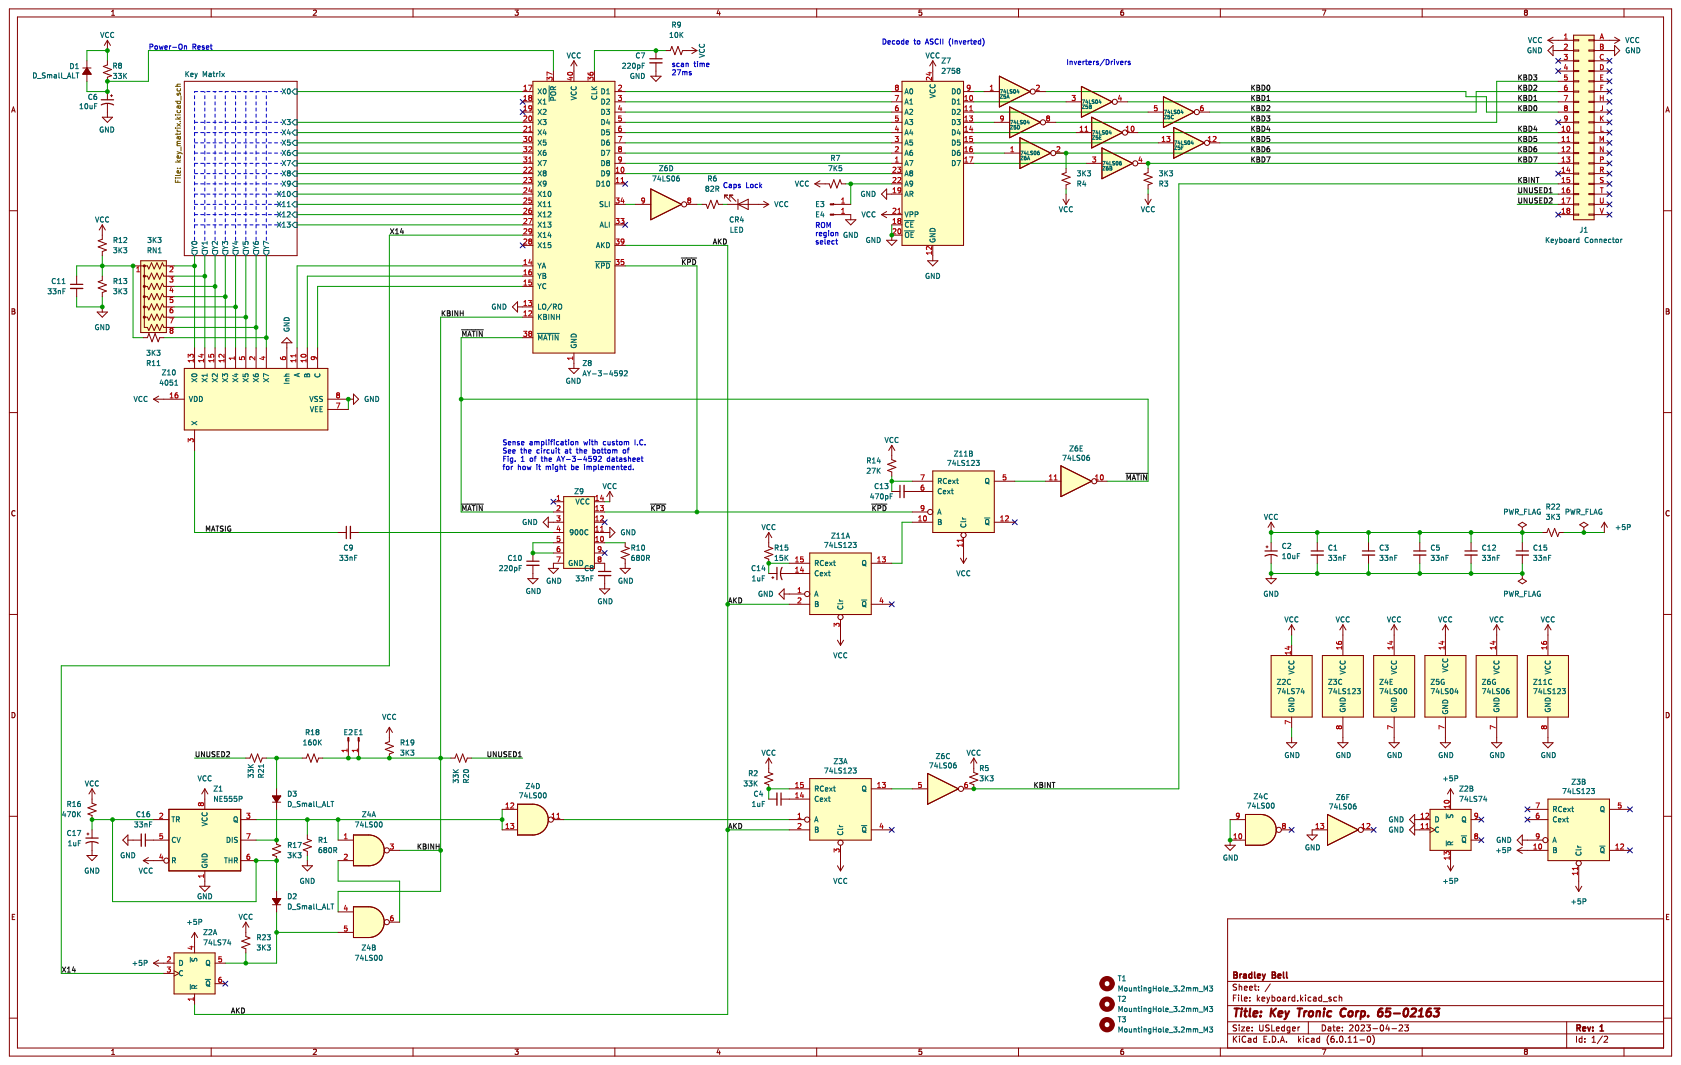
[picture p28: page 1]

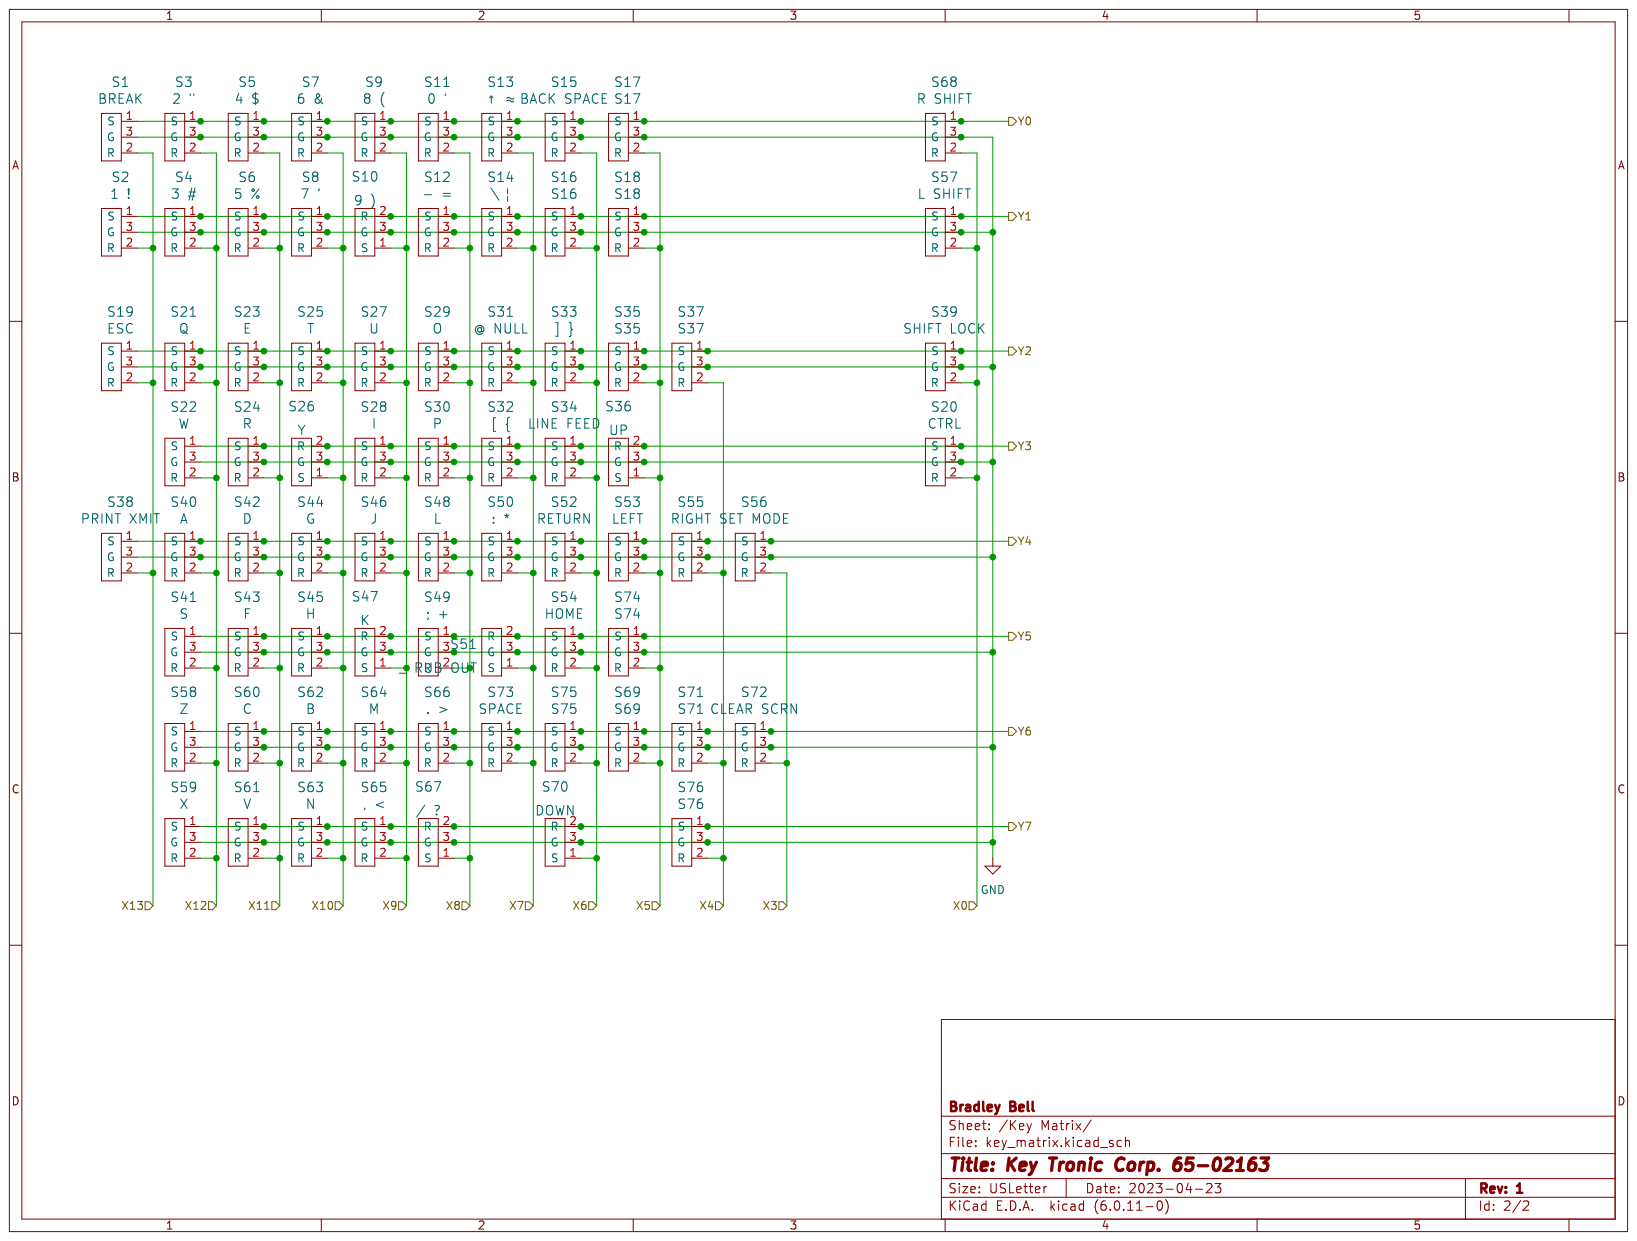
[picture p29: page 2]
