btb/Telcon-Ambassador/boards/keyboard/keyboard.kicad_pcb

## KiCad design boards/keyboard/keyboard.kicad_pcb (2024-08-22)

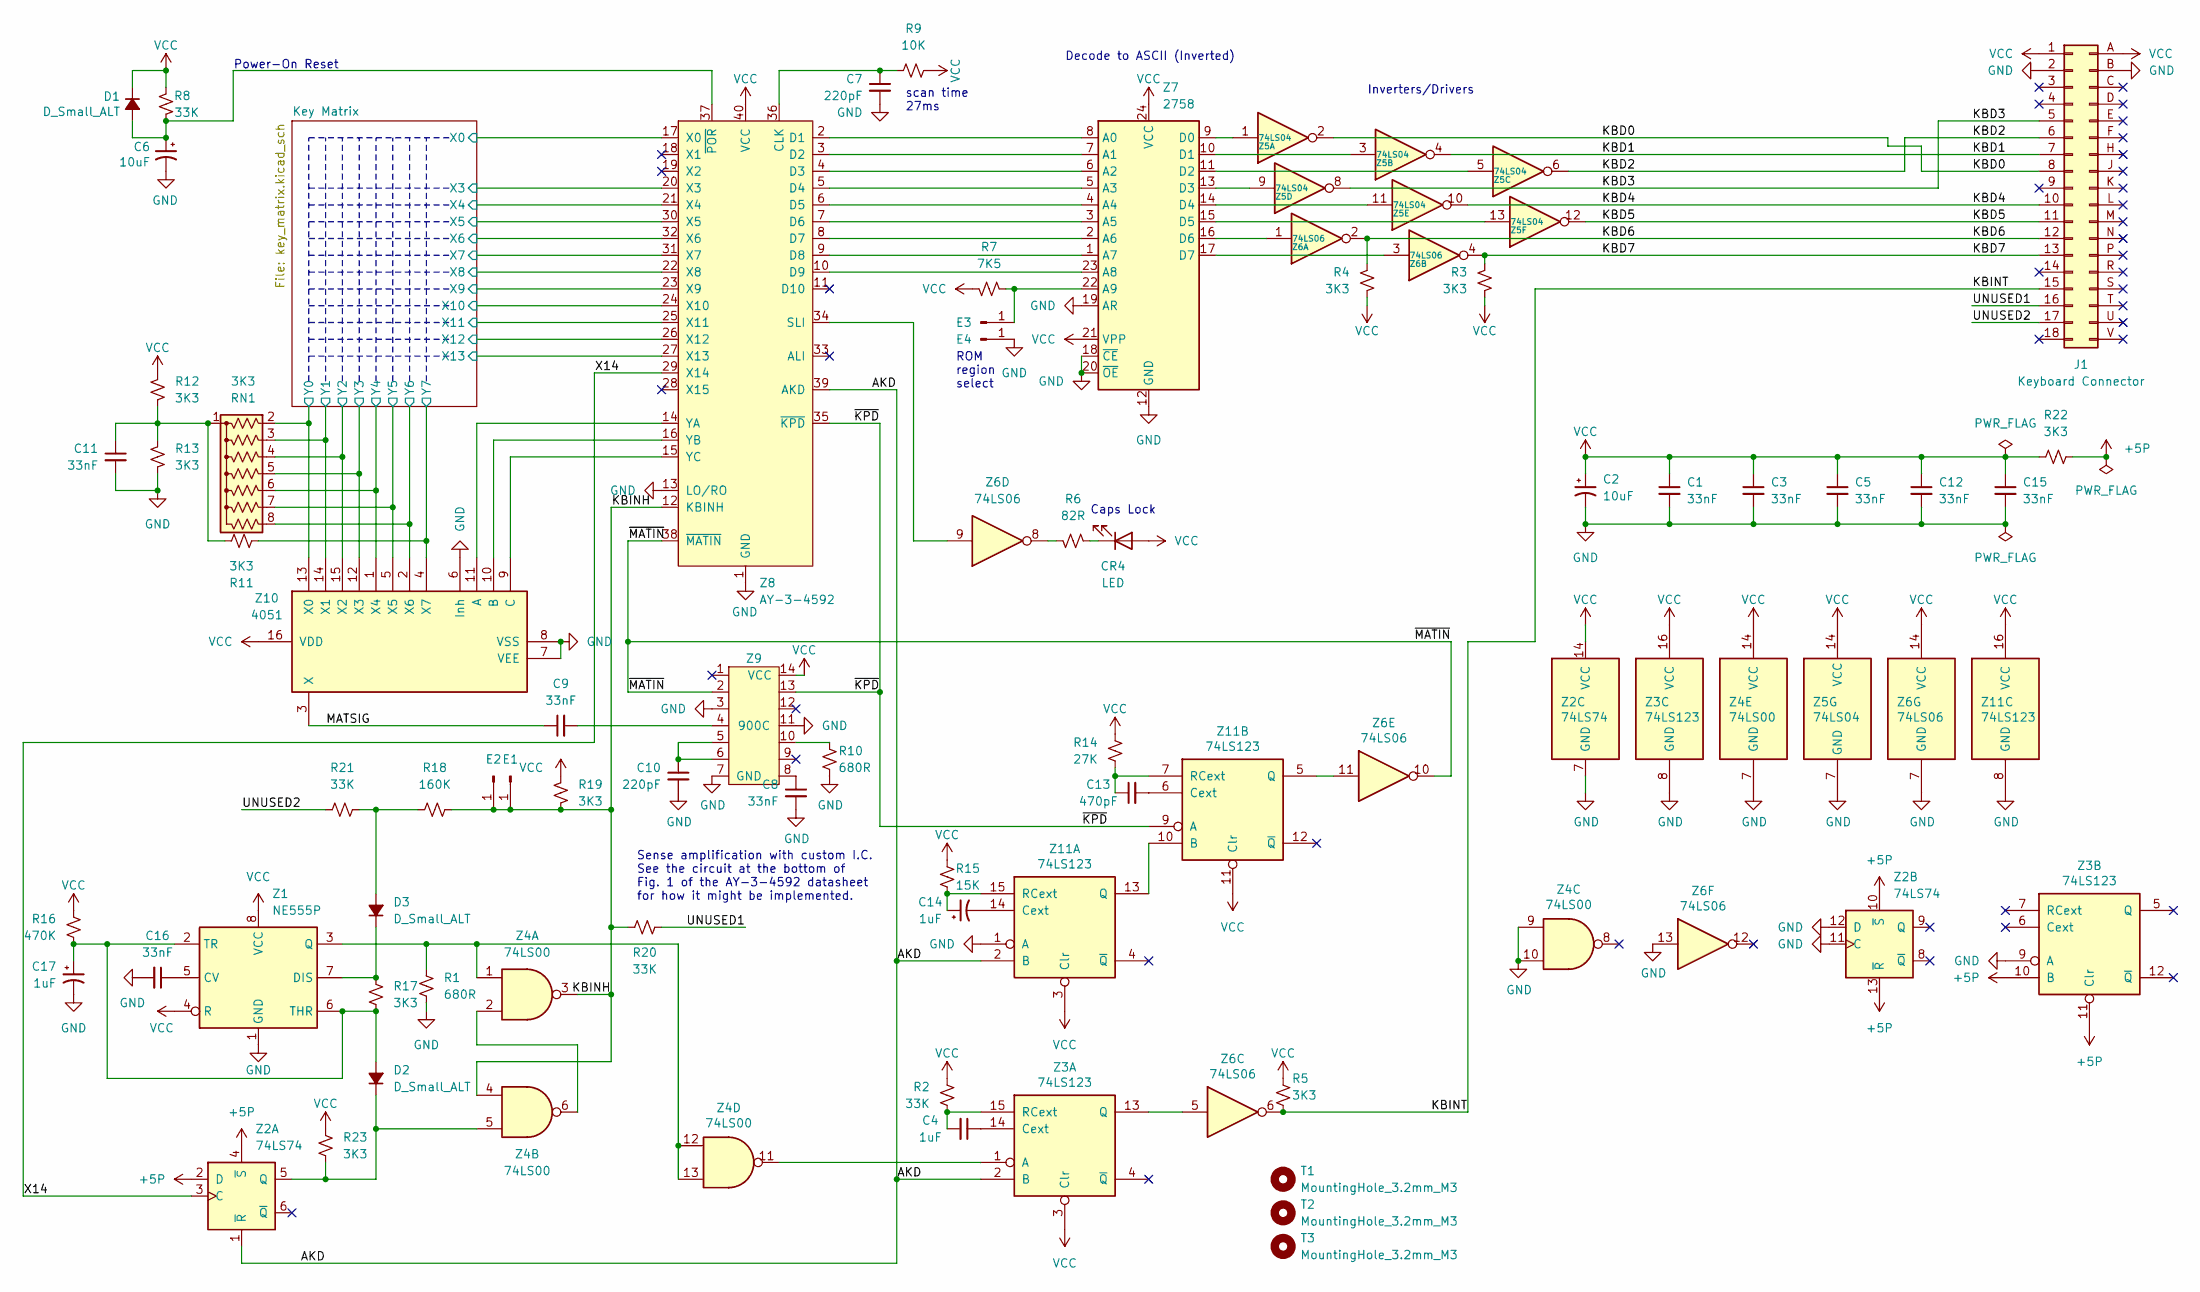
[picture p30: schematic keyboard.kicad_sch, Key Tronic Corp. 65-02163]

Parts:
C1, C3, C5, C8, C9, C11, C12, C15, C16: 33nF; C_Axial_L3.8mm_D2.6mm_P12.7mm_Horizontal
C2: 10uF; CP_Radial_D8.0mm_P3.80mm
C4: 1uF; C_Rect_L7.0mm_W2.5mm_P5.00mm
C6: 10uF; CP_Radial_D8.0mm_P3.50mm
C7, C10: 220pF; C_Disc_D6.0mm_W2.5mm_P6.35mm
C13: 470pF; C_Axial_L3.8mm_D2.6mm_P12.7mm_Horizontal
C14: 1uF; CP_Axial_L11.0mm_D5.0mm_P18.00mm_Horizontal
C17: 1uF; CP_Axial_L9.0mm_D3.5mm_P12.7mm_Horizontal
CR4: LED; LED_D5.0mm
D1, D2, D3: D_Small_ALT; D_T-1_P12.70mm_Horizontal
E1, E2: Conn_01x01_Male; PinHeader_1x01_P2.54mm_Vertical
E3: A9; PinHeader_1x01_P2.54mm_Vertical
E4: GND; PinHeader_1x01_P2.54mm_Vertical
J1: Keyboard Connector; CARDEDGE_2x18_P3.96mm
R1, R10: 680R; R_Axial_DIN0309_L9.0mm_D3.2mm_P12.70mm_Horizontal
R2, R8, R20, R21: 33K; R_Axial_DIN0309_L9.0mm_D3.2mm_P12.70mm_Horizontal
R3, R4, R5, R11, R12, R13, R17, R19, R22, R23: 3K3; R_Axial_DIN0309_L9.0mm_D3.2mm_P12.70mm_Horizontal
R6: 82R; R_Axial_DIN0309_L9.0mm_D3.2mm_P12.70mm_Horizontal
R7: 7K5; R_Axial_DIN0309_L9.0mm_D3.2mm_P12.70mm_Horizontal
R9: 10K; R_Axial_DIN0309_L9.0mm_D3.2mm_P12.70mm_Horizontal
R14: 27K; R_Axial_DIN0309_L9.0mm_D3.2mm_P12.70mm_Horizontal
R15: 15K; R_Axial_DIN0309_L9.0mm_D3.2mm_P12.70mm_Horizontal
R16: 470K; R_Axial_DIN0309_L9.0mm_D3.2mm_P12.70mm_Horizontal
R18: 160K; R_Axial_DIN0309_L9.0mm_D3.2mm_P12.70mm_Horizontal
RN1: 3K3; R_Array_SIP8
T1, T2, T3: MountingHole_3.2mm_M3
Z1: NE555P; DIP-8_W7.62mm
Z2: 74LS74; DIP-14_W7.62mm
Z3, Z11: 74LS123; DIP-16_W7.62mm
Z4: 74LS00; DIP-14_W7.62mm
Z5: 74LS04; DIP-14_W7.62mm
Z6: 74LS06; DIP-14_W7.62mm
Z7: 2758; DIP-24_W15.24mm
Z8: AY-3-4592; DIP-40_W15.24mm_Socket
Z9: 900C; DIP-14_W7.62mm
Z10: 4051; DIP-16_W7.62mm

Connections:
+5P: R22.2, Z2.2 (D), Z2.4 (~S), Z2.10 (~S), Z2.13 (~R), Z3.10 (B), Z3.11 (Clr)
/AKD: Z2.1 (~R), Z3.2 (B), Z8.39 (AKD), Z11.2 (B)
/KBD0: J1.8, Z5.2
/KBD1: J1.7, Z5.4
/KBD2: J1.6, Z5.6
/KBD3: J1.5, Z5.8
/KBD4: J1.10, Z5.10
/KBD5: J1.11, Z5.12
/KBD6: J1.12, R4.2, Z6.2
/KBD7: J1.13, R3.2, Z6.4
/KBINH: E1.1, E2.1, R18.2, R19.2, R20.1, Z4.3, Z4.4, Z8.12 (KBINH)
/KBINT: J1.15, R5.2, Z6.6
/Key Matrix/X0: Z8.17 (X0); also elsewhere on the board
/Key Matrix/X3: Z8.20 (X3); also elsewhere on the board
/Key Matrix/X4: Z8.21 (X4); also elsewhere on the board
/Key Matrix/X5: Z8.30 (X5); also elsewhere on the board
/Key Matrix/X6: Z8.32 (X6); also elsewhere on the board
/Key Matrix/X7: Z8.31 (X7); also elsewhere on the board
/Key Matrix/X8: Z8.22 (X8); also elsewhere on the board
/Key Matrix/X9: Z8.23 (X9); also elsewhere on the board
/Key Matrix/X10: Z8.24 (X10); also elsewhere on the board
/Key Matrix/X11: Z8.25 (X11); also elsewhere on the board
/Key Matrix/X12: Z8.26 (X12); also elsewhere on the board
/Key Matrix/X13: Z8.27 (X13); also elsewhere on the board
/Key Matrix/Y0: RN1.2 (R1), Z10.13 (X0); also elsewhere on the board
/Key Matrix/Y1: RN1.3 (R2), Z10.14 (X1); also elsewhere on the board
/Key Matrix/Y2: RN1.4 (R3), Z10.15 (X2); also elsewhere on the board
/Key Matrix/Y3: RN1.5 (R4), Z10.12 (X3); also elsewhere on the board
/Key Matrix/Y4: RN1.6 (R5), Z10.1 (X4); also elsewhere on the board
/Key Matrix/Y5: RN1.7 (R6), Z10.5 (X5); also elsewhere on the board
/Key Matrix/Y6: RN1.8 (R7), Z10.2 (X6); also elsewhere on the board
/Key Matrix/Y7: R11.2, Z10.4 (X7); also elsewhere on the board
/MATSIG: C9.1, Z10.3 (X)
/UNUSED1: J1.16, R20.2
/UNUSED2: J1.17, R21.2
/X14: Z2.3 (C), Z8.29 (X14)
/~KPD: Z8.35 (~KPD), Z9.13, Z11.9 (A)
/~MATIN: Z6.10, Z8.38 (~MATIN), Z9.2
GND: C1.2, C2.2, C3.2, C5.2, C6.2, C7.2, C8.2, C10.2, C11.2, C12.2, C15.2, C16.2, C17.2, E4.1, J1.2, J1.B, R1.2, R10.2, R13.2, Z1.1 (GND), Z2.7 (GND), Z2.11 (C), Z2.12 (D), Z3.8 (GND), Z3.9 (A), Z4.7 (GND), Z4.9, Z4.10, Z5.7 (GND), Z6.7 (GND), Z6.13, Z7.12 (GND), Z7.18 (~CE), Z7.19 (AR), Z7.20 (~OE), Z8.1 (GND), Z8.13 (LO/RO), Z9.3, Z9.7 (GND), Z9.11, Z10.6 (Inh), Z10.7 (VEE), Z10.8 (VSS), Z11.1 (A), Z11.8 (GND); also elsewhere on the board
unnamed: C4.1, Z3.14 (Cext)
unnamed: C4.2, R2.2, Z3.15 (RCext)
unnamed: C6.1, D1.2 (A), R8.2, Z8.37 (~POR)
unnamed: C7.1, R9.2, Z8.36 (CLK)
unnamed: C8.1, Z9.8
unnamed: C9.2, Z9.4
unnamed: C10.1, Z9.5, Z9.6
unnamed: C11.1, R11.1, R12.2, R13.1, RN1.1 (common)
unnamed: C13.1, R14.2, Z11.7 (RCext)
unnamed: C13.2, Z11.6 (Cext)
unnamed: C14.1, R15.2, Z11.15 (RCext)
unnamed: C14.2, Z11.14 (Cext)
unnamed: C16.1, Z1.5 (CV)
unnamed: C17.1, D2.2 (A), R16.2, R17.2, Z1.2 (TR), Z1.6 (THR)
unnamed: CR4.1 (K), R6.1
unnamed: D2.1 (K), R23.2, Z2.5 (Q), Z4.5
unnamed: D3.1 (K), R17.1, Z1.7 (DIS)
unnamed: D3.2 (A), R18.1, R21.1
unnamed: E3.1, R7.2, Z7.22 (A9)
unnamed: R1.1, Z1.3 (Q), Z4.1, Z4.12, Z4.13
unnamed: R6.2, Z6.8
unnamed: R10.1, Z9.10
unnamed: Z3.1 (A), Z4.11
unnamed: Z3.13 (Q), Z6.5
unnamed: Z4.2, Z4.6
unnamed: Z5.1, Z7.9 (D0)
unnamed: Z5.3, Z7.10 (D1)
unnamed: Z5.5, Z7.11 (D2)
unnamed: Z5.9, Z7.13 (D3)
unnamed: Z5.11, Z7.14 (D4)
unnamed: Z5.13, Z7.15 (D5)
unnamed: Z6.1, Z7.16 (D6)
unnamed: Z6.3, Z7.17 (D7)
unnamed: Z6.9, Z8.34 (SLI)
unnamed: Z7.1 (A7), Z8.9 (D8)
unnamed: Z7.2 (A6), Z8.8 (D7)
unnamed: Z7.3 (A5), Z8.7 (D6)
unnamed: Z7.4 (A4), Z8.6 (D5)
unnamed: Z7.5 (A3), Z8.5 (D4)
unnamed: Z7.6 (A2), Z8.4 (D3)
unnamed: Z7.7 (A1), Z8.3 (D2)
unnamed: Z7.8 (A0), Z8.2 (D1)
unnamed: Z7.23 (A8), Z8.10 (D9)
unnamed: Z8.15 (YC), Z10.9 (C)
unnamed: Z8.16 (YB), Z10.10 (B)
unnamed: Z8.14 (YA), Z10.11 (A)
unnamed: Z6.11, Z11.5 (Q)
unnamed: Z11.10 (B), Z11.13 (Q)
VCC: C1.1, C2.1, C3.1, C5.1, C12.1, C15.1, CR4.2 (A), D1.1 (K), J1.1, J1.A, R2.1, R3.1, R4.1, R5.1, R7.1, R8.1, R9.1, R12.1, R14.1, R15.1, R16.1, R19.1, R22.1, R23.1, Z1.4 (R), Z1.8 (VCC), Z2.14 (VCC), Z3.3 (Clr), Z3.16 (VCC), Z4.14 (VCC), Z5.14 (VCC), Z6.14 (VCC), Z7.21 (VPP), Z7.24 (VCC), Z8.40 (VCC), Z9.14 (VCC), Z10.16 (VDD), Z11.3 (Clr), Z11.11 (Clr), Z11.16 (VCC)

Notes on the sheet:
Sense amplification with custom I.C. See the circuit at the bottom of Fig. 1 of the AY-3-4592 datasheet for how it might be implemented.
ROM region select
Caps Lock
Power-On Reset
Inverters/Drivers
Decode to ASCII (Inverted)
scan time 27ms

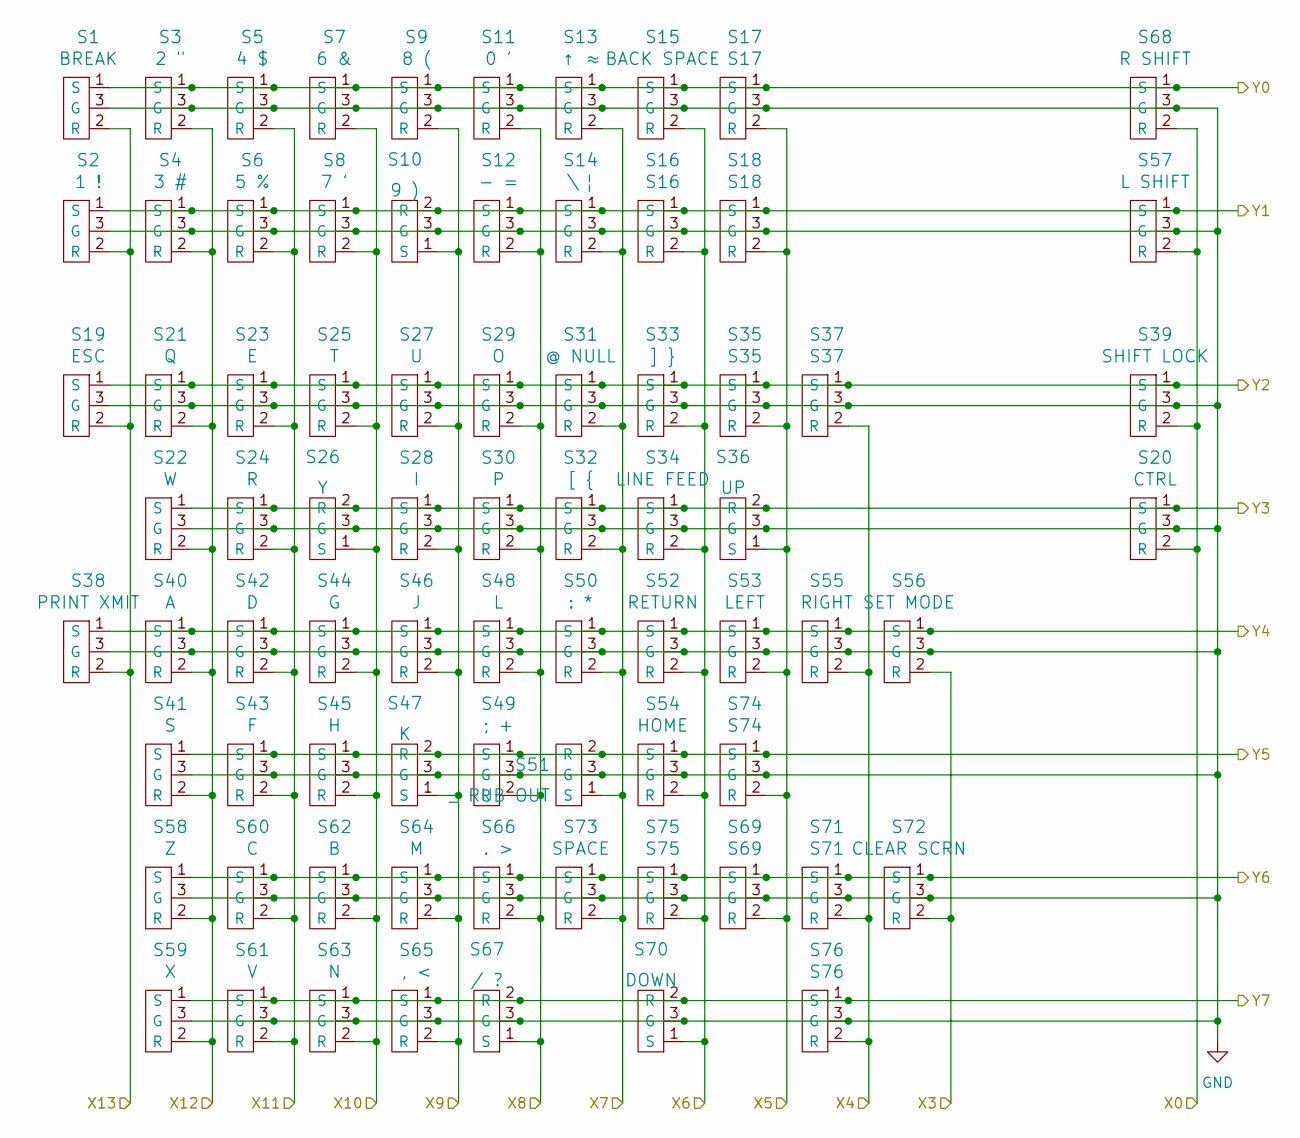
[picture p31: schematic key_matrix.kicad_sch, Key Tronic Corp. 65-02163]

Parts:
S1: BREAK; KTCPadScrew
S2: 1 !; KTCPad
S3: 2 "; KTCPad
S4: 3 #; KTCPad
S5: 4 $; KTCPadScrew
S6: 5 %; KTCPad
S7: 6 &; KTCPad
S8: 7 ’; KTCPad
S9: 8 (; KTCPad
S10: 9 ); KTCPadScrew
S11: 0 '; KTCPad
S12: - =; KTCPad
S13: ↑ ≈; KTCPad
S14: \ ¦; KTCPad
S15: BACK SPACE; KTCPadScrew
S16: S16; KTCPad
S17: S17; KTCPad
S18: S18; KTCPad
S19: ESC; KTCPad
S20: CTRL; KTCPad
S21: Q; KTCPadScrew
S22: W; KTCPad
S23: E; KTCPad
S24: R; KTCPad
S25: T; KTCPad
S26: Y; KTCPadScrew
S27: U; KTCPad
S28: I; KTCPad
S29: O; KTCPad
S30: P; KTCPad
S31: @ NULL; KTCPadScrew
S32: [ {; KTCPad
S33: ] }; KTCPad
S34: LINE FEED; KTCPad
S35: S35; KTCPad
S36: UP; KTCPadScrew
S37: S37; KTCPad
S38: PRINT XMIT; KTCPadScrew
S39: SHIFT LOCK; KTCPad
S40: A; KTCPad
S41: S; KTCPad
S42: D; KTCPadScrew
S43: F; KTCPad
S44: G; KTCPad
S45: H; KTCPad
S46: J; KTCPad
S47: K; KTCPadScrew
S48: L; KTCPad
S49: ; +; KTCPad
S50: : *; KTCPad
S51: _ RUB OUT; KTCPadScrew
S52: RETURN; KTCPad
S53: LEFT; KTCPadScrew
S54: HOME; KTCPad
S55: RIGHT; KTCPadScrew
S56: SET MODE; KTCPad
S57: L SHIFT; KTCPadScrew
S58: Z; KTCPad
S59: X; KTCPad
S60: C; KTCPad
S61: V; KTCPad
S62: B; KTCPadScrew
S63: N; KTCPad
S64: M; KTCPad
S65: , <; KTCPad
S66: . >; KTCPad
S67: / ?; KTCPadScrew
S68: R SHIFT; KTCPad
S69: S69; KTCPad
S70: DOWN; KTCPadScrew
S71: S71; KTCPad
S72: CLEAR SCRN; KTCPadScrew
S73: SPACE; KTCPadScrew
S74: S74; KTCPad
S75: S75; KTCPad
S76: S76; KTCPad

Connections:
/Key Matrix/X0: S20.2 (R), S39.2 (R), S57.2 (R), S68.2 (R); also elsewhere on the board
/Key Matrix/X3: S56.2 (R), S72.2 (R); also elsewhere on the board
/Key Matrix/X4: S37.2 (R), S55.2 (R), S71.2 (R), S76.2 (R); also elsewhere on the board
/Key Matrix/X5: S17.2 (R), S18.2 (R), S35.2 (R), S36.1 (S), S53.2 (R), S69.2 (R), S74.2 (R); also elsewhere on the board
/Key Matrix/X6: S15.2 (R), S16.2 (R), S33.2 (R), S34.2 (R), S52.2 (R), S54.2 (R), S70.1 (S), S75.2 (R); also elsewhere on the board
/Key Matrix/X7: S13.2 (R), S14.2 (R), S31.2 (R), S32.2 (R), S50.2 (R), S51.1 (S), S73.2 (R); also elsewhere on the board
/Key Matrix/X8: S11.2 (R), S12.2 (R), S29.2 (R), S30.2 (R), S48.2 (R), S49.2 (R), S66.2 (R), S67.1 (S); also elsewhere on the board
/Key Matrix/X9: S9.2 (R), S10.1 (S), S27.2 (R), S28.2 (R), S46.2 (R), S47.1 (S), S64.2 (R), S65.2 (R); also elsewhere on the board
/Key Matrix/X10: S7.2 (R), S8.2 (R), S25.2 (R), S26.1 (S), S44.2 (R), S45.2 (R), S62.2 (R), S63.2 (R); also elsewhere on the board
/Key Matrix/X11: S5.2 (R), S6.2 (R), S23.2 (R), S24.2 (R), S42.2 (R), S43.2 (R), S60.2 (R), S61.2 (R); also elsewhere on the board
/Key Matrix/X12: S3.2 (R), S4.2 (R), S21.2 (R), S22.2 (R), S40.2 (R), S41.2 (R), S58.2 (R), S59.2 (R); also elsewhere on the board
/Key Matrix/X13: S1.2 (R), S2.2 (R), S19.2 (R), S38.2 (R); also elsewhere on the board
/Key Matrix/Y0: S1.1 (S), S3.1 (S), S5.1 (S), S7.1 (S), S9.1 (S), S11.1 (S), S13.1 (S), S15.1 (S), S17.1 (S), S68.1 (S); also elsewhere on the board
/Key Matrix/Y1: S2.1 (S), S4.1 (S), S6.1 (S), S8.1 (S), S10.2 (R), S12.1 (S), S14.1 (S), S16.1 (S), S18.1 (S), S57.1 (S); also elsewhere on the board
/Key Matrix/Y2: S19.1 (S), S21.1 (S), S23.1 (S), S25.1 (S), S27.1 (S), S29.1 (S), S31.1 (S), S33.1 (S), S35.1 (S), S37.1 (S), S39.1 (S); also elsewhere on the board
/Key Matrix/Y3: S20.1 (S), S22.1 (S), S24.1 (S), S26.2 (R), S28.1 (S), S30.1 (S), S32.1 (S), S34.1 (S), S36.2 (R); also elsewhere on the board
/Key Matrix/Y4: S38.1 (S), S40.1 (S), S42.1 (S), S44.1 (S), S46.1 (S), S48.1 (S), S50.1 (S), S52.1 (S), S53.1 (S), S55.1 (S), S56.1 (S); also elsewhere on the board
/Key Matrix/Y5: S41.1 (S), S43.1 (S), S45.1 (S), S47.2 (R), S49.1 (S), S51.2 (R), S54.1 (S), S74.1 (S); also elsewhere on the board
/Key Matrix/Y6: S58.1 (S), S60.1 (S), S62.1 (S), S64.1 (S), S66.1 (S), S69.1 (S), S71.1 (S), S72.1 (S), S73.1 (S), S75.1 (S); also elsewhere on the board
/Key Matrix/Y7: S59.1 (S), S61.1 (S), S63.1 (S), S65.1 (S), S67.2 (R), S70.2 (R), S76.1 (S); also elsewhere on the board
GND: S1.3 (G), S2.3 (G), S3.3 (G), S4.3 (G), S5.3 (G), S6.3 (G), S7.3 (G), S8.3 (G), S9.3 (G), S10.3 (G), S11.3 (G), S12.3 (G), S13.3 (G), S14.3 (G), S15.3 (G), S16.3 (G), S17.3 (G), S18.3 (G), S19.3 (G), S20.3 (G), S21.3 (G), S22.3 (G), S23.3 (G), S24.3 (G), S25.3 (G), S26.3 (G), S27.3 (G), S28.3 (G), S29.3 (G), S30.3 (G), S31.3 (G), S32.3 (G), S33.3 (G), S34.3 (G), S35.3 (G), S36.3 (G), S37.3 (G), S38.3 (G), S39.3 (G), S40.3 (G), S41.3 (G), S42.3 (G), S43.3 (G), S44.3 (G), S45.3 (G), S46.3 (G), S47.3 (G), S48.3 (G), S49.3 (G), S50.3 (G), S51.3 (G), S52.3 (G), S53.3 (G), S54.3 (G), S55.3 (G), S56.3 (G), S57.3 (G), S58.3 (G), S59.3 (G), S60.3 (G), S61.3 (G), S62.3 (G), S63.3 (G), S64.3 (G), S65.3 (G), S66.3 (G), S67.3 (G), S68.3 (G), S69.3 (G), S70.3 (G), S71.3 (G), S72.3 (G), S73.3 (G), S74.3 (G), S75.3 (G), S76.3 (G); also elsewhere on the board

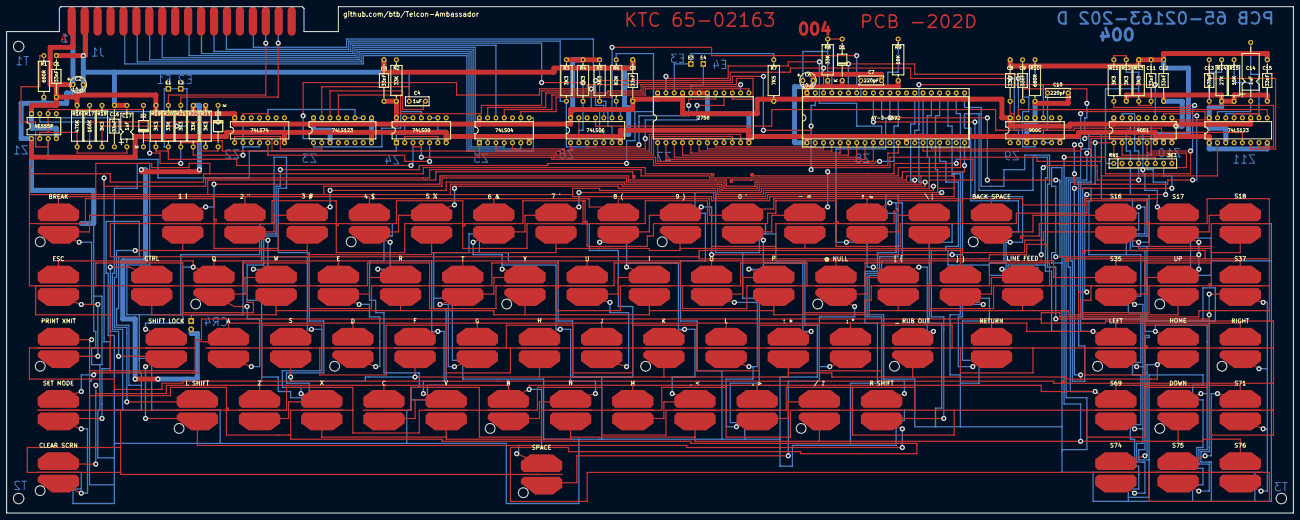
[picture p32: board keyboard.kicad_pcb from above]

Board: 2 copper layers, 394.1 x 155.1 mm, 140 parts (0 on the bottom side), 88 nets.
