btb/Telcon-Ambassador/boards/printer/printer.kicad_pcb

## KiCad design boards/printer/printer.kicad_pcb (2024-08-22)

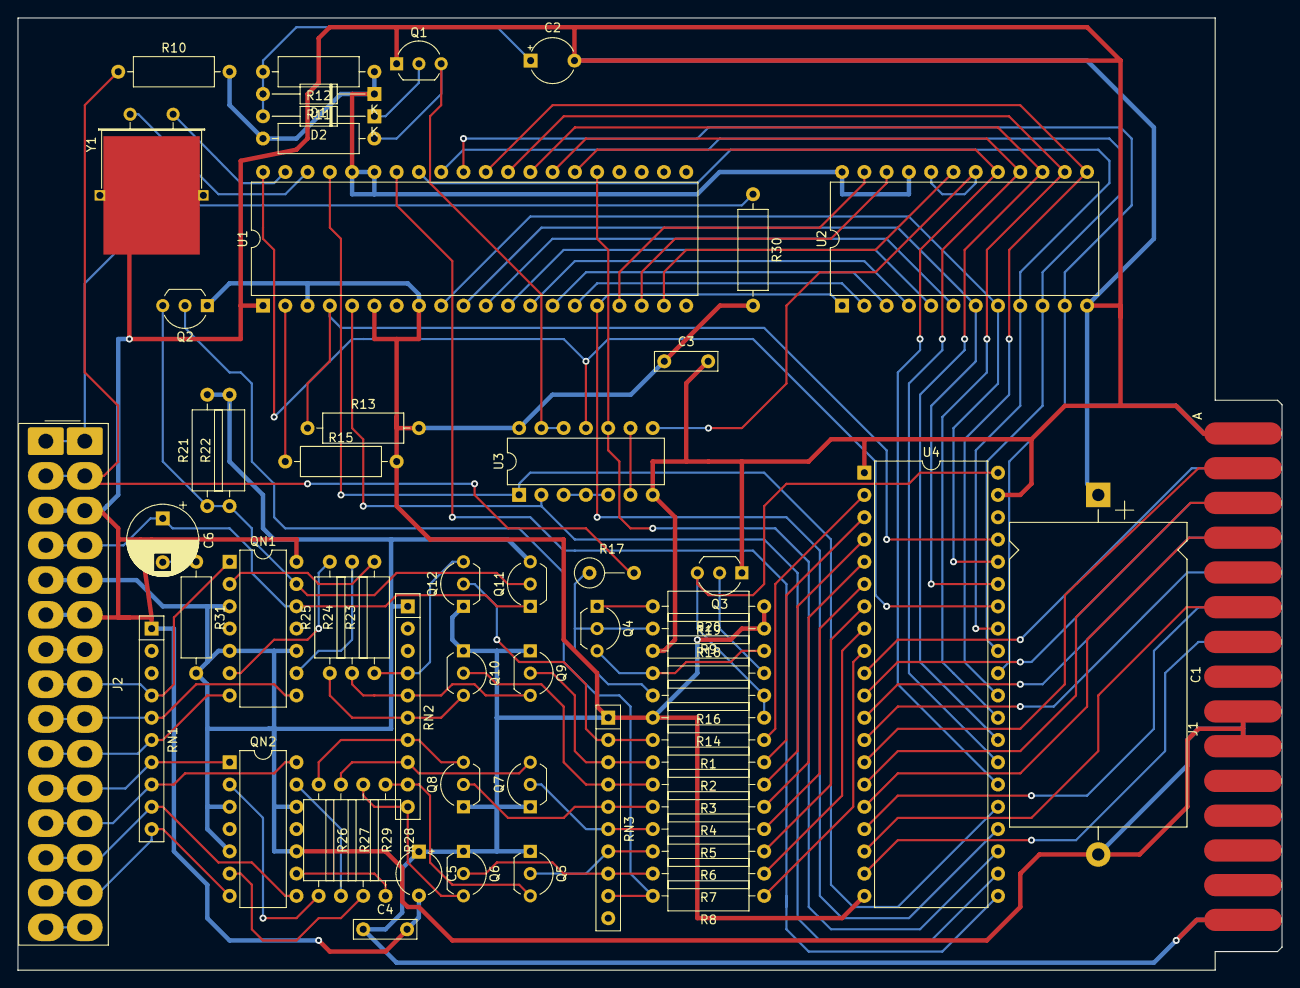
[picture p33: board printer.kicad_pcb from above]

Board: 2 copper layers, 144.1 x 108.6 mm, 63 parts (0 on the bottom side), 95 nets.

Parts:
C1: 220uF; CP_Axial_L34.5mm_D20.0mm_P41.00mm_Horizontal
C2: 10UF; CP_Radial_Tantal_D5.0mm_P5.00mm
C3, C4: 220NF; C_Rect_L7.0mm_W2.0mm_P5.00mm
C5: 16uF; CP_Radial_Tantal_D5.0mm_P5.00mm
C6: 220uF; CP_Radial_D8.0mm_P5.00mm
D1, D2: 1N4148; D_DO-35_SOD27_P12.70mm_Horizontal
J1: GC-880; CARDEDGE_2x15_P3.96mm
J2: PRINTER; CardSocket_1x15_P3.96mm_Vertical
Q1, Q3: 2N3904; TO-92_Inline_Wide
Q2, Q4, Q5, Q6, Q7, Q8, Q9, Q10, Q11, Q12: 2N3906; TO-92_Inline_Wide
QN1, QN2: Q2T3725; DIP-14_W7.62mm
R1, R2, R3, R4, R5, R6, R7, R8, R9, R20: 10K; R_Axial_DIN0309_L9.0mm_D3.2mm_P12.70mm_Horizontal
R10: 2.2K; R_Axial_DIN0309_L9.0mm_D3.2mm_P12.70mm_Horizontal
R11: 27K; R_Axial_DIN0309_L9.0mm_D3.2mm_P12.70mm_Horizontal
R12: 47K; R_Axial_DIN0309_L9.0mm_D3.2mm_P12.70mm_Horizontal
R13, R14: 3.9K; R_Axial_DIN0309_L9.0mm_D3.2mm_P12.70mm_Horizontal
R15: 2.7K; R_Axial_DIN0309_L9.0mm_D3.2mm_P12.70mm_Horizontal
R16: 180K; R_Axial_DIN0309_L9.0mm_D3.2mm_P12.70mm_Horizontal
R17: 2.7K; R_Axial_DIN0309_L9.0mm_D3.2mm_P5.08mm_Vertical
R18: 220K; R_Axial_DIN0309_L9.0mm_D3.2mm_P12.70mm_Horizontal
R19: 1K; R_Axial_DIN0309_L9.0mm_D3.2mm_P12.70mm_Horizontal
R21, R22: 5.6K; R_Axial_DIN0309_L9.0mm_D3.2mm_P12.70mm_Horizontal
R23, R24, R25, R26, R27, R28, R29: 1k; R_Axial_DIN0309_L9.0mm_D3.2mm_P12.70mm_Horizontal
R30: 150; R_Axial_DIN0309_L9.0mm_D3.2mm_P12.70mm_Horizontal
R31: 100; R_Axial_DIN0309_L9.0mm_D3.2mm_P12.70mm_Horizontal
RN1, RN2: 10K; R_Array_SIP10
RN3: 2.7K; R_Array_SIP10
U1: MC6802; DIP-40_W15.24mm
U2: 2758; DIP-24_W15.24mm
U3: 7400; DIP-14_W7.62mm
U4: 6821; DIP-40_W15.24mm
Y1: Crystal_GND3; Crystal_HC18-U_Horizontal_1EP_style2

Connections:
-24V: C1.2, J1.9, J1.10, J1.K, J1.L, J2.5, J2.E, Q11.3 (C), QN1.3 (E), QN1.5 (E), QN1.10 (E), QN2.3 (E), QN2.5 (E), QN2.10 (E), QN2.12 (E), R21.2, R22.2, R31.2, RN2.1 (R1.1)
/A0: U1.9 (A0), U2.8 (A0), U4.36 (RS0)
/A1: U1.10 (A1), U2.7 (A1), U4.35 (RS1)
/A2: U1.11 (A2), U2.6 (A2)
/A3: U1.12 (A3), U2.5 (A3)
/A4: U1.13 (A4), U2.4 (A4)
/A5: U1.14 (A5), U2.3 (A5)
/A6: U1.15 (A6), U2.2 (A6)
/A7: U1.16 (A7), U2.1 (A7), U4.24 (CS1)
/A8: U1.17 (A8), U2.23 (A8)
/A9: U1.18 (A9), U2.22 (A9)
/A10: U1.19 (A10), U2.19 (AR)
/A15: U1.25 (A15), U3.10, U4.23 (~CS2)
/D0: U1.33 (D0), U2.9 (D0), U4.33 (D0)
/D1: U1.32 (D1), U2.10 (D1), U4.32 (D1)
/D2: U1.31 (D2), U2.11 (D2), U4.31 (D2)
/D3: U1.30 (D3), U2.13 (D3), U4.30 (D3)
/D4: U1.29 (D4), U2.14 (D4), U4.29 (D4)
/D5: U1.28 (D5), U2.15 (D5), U4.28 (D5)
/D6: U1.27 (D6), U2.16 (D6), U4.27 (D6)
/D7: U1.26 (D7), U2.17 (D7), U4.26 (D7)
/ENABLE: U1.37 (E), U3.1, U4.25 (ENABLE)
/HEAD1: J2.8, J2.J, QN1.1 (C), RN1.4 (R3)
/HEAD2: J2.9, J2.K, QN1.8 (C), RN1.5 (R4)
/HEAD3: J2.10, J2.L, QN1.7 (C), RN1.6 (R5)
/HEAD4: J2.11, J2.M, QN2.1 (C), RN1.7 (R6)
/HEAD5: J2.12, J2.N, QN2.14 (C), RN1.8 (R7)
/HEAD6: J2.13, J2.P, QN2.8 (C), RN1.9 (R8)
/HEAD7: J2.14, J2.R, QN2.7 (C), RN1.10 (R9)
/IRQ: R13.1, U1.4 (~IRQ), U4.37 (~IRQB), U4.38 (~IRQA)
/MOTOR: C6.1, J2.4, J2.D, Q11.1 (E), QN1.12 (E)
/PHOTOTRANSISTOR: J2.2, J2.B, R10.1, R17.2
/PRCON: J1.7, U4.19 (CB2)
/PRD0: J1.2, U4.10 (PB0)
/PRD1: J1.3, U4.11 (PB1)
/PRD2: J1.4, U4.12 (PB2)
/PRD3: J1.5, U4.13 (PB3)
/PRD4: J1.B, U4.14 (PB4)
/PRD5: J1.C, U4.15 (PB5)
/PRD6: J1.D, U4.16 (PB6)
/PRD7: J1.6, U4.17 (PB7)
/PRINT: J1.F, U4.18 (CB1)
/R/~W: U1.34 (R/~W), U4.21 (R/~W)
/VMA: U1.5 (VMA), U3.2, U4.22 (CS0)
/~RESET: U1.40 (~RESET), U3.11, U4.34 (~RESET)
GND: C1.1, C2.2, C3.2, C4.2, C5.2, J1.1, J1.A, J2.3, J2.6, J2.C, J2.F, Q1.1 (E), Q3.1 (E), QN1.14 (C), R20.1, RN1.1 (common), U1.1 (VSS), U2.12 (GND), U3.7 (GND), U4.1 (VSS), U4.39 (CA2), Y1.3
unnamed: C6.2, R31.1
unnamed: C2.1, D1.2 (A), D2.2 (A), R12.2
unnamed: D2.1 (K), Q1.2 (B)
unnamed: J2.1, J2.A, R30.1
unnamed: J2.7, J2.H
unnamed: J2.15, J2.S
unnamed: Q1.3 (C), R11.2, U3.12, U3.13
unnamed: Q2.2 (B), R8.2, RN3.9 (R8)
unnamed: Q3.2 (B), R9.2
unnamed: Q3.3 (C), R14.1, R16.1, U4.40 (CA1)
unnamed: Q4.2 (B), Q4.3 (C), R9.1, R16.2, R17.1, R18.2, R20.2
unnamed: Q4.1 (E), R19.2
unnamed: Q5.2 (B), R6.2, RN3.7 (R6)
unnamed: Q5.3 (C), R28.1, RN2.9 (R8.2)
unnamed: Q6.2 (B), R7.2, RN3.8 (R7)
unnamed: Q6.3 (C), R29.1, RN2.10 (R9.2)
unnamed: Q7.2 (B), R5.2, RN3.6 (R5)
unnamed: Q7.3 (C), R27.1, RN2.8 (R7.2)
unnamed: Q8.2 (B), R4.2, RN3.5 (R4)
unnamed: Q8.3 (C), R26.1, RN2.7 (R6.2)
unnamed: Q9.2 (B), R2.2, RN3.3 (R2)
unnamed: Q9.3 (C), R24.1, RN2.5 (R4.2)
unnamed: Q10.2 (B), R3.2, RN3.4 (R3)
unnamed: Q10.3 (C), R25.1, RN2.6 (R5.2)
unnamed: Q2.3 (C), Q11.2 (B), QN1.13 (B), R21.1, R22.1
unnamed: Q12.2 (B), R1.2, RN3.2 (R1)
unnamed: Q12.3 (C), R23.1, RN2.4 (R3.2)
unnamed: QN1.2 (B), R23.2
unnamed: QN1.6 (B), R25.2
unnamed: QN1.9 (B), R24.2
unnamed: QN2.2 (B), R26.2
unnamed: QN2.6 (B), R29.2
unnamed: QN2.9 (B), R28.2
unnamed: QN2.13 (B), R27.2
unnamed: U1.39 (EXTAL), Y1.2
unnamed: U1.38 (XTAL), Y1.1
unnamed: R15.1, U1.2 (~HALT)
unnamed: U2.18 (~CE), U2.20 (~OE), U3.8
unnamed: U3.3, U3.4, U3.5
unnamed: U3.6, U3.9
unnamed: R1.1, U4.2 (PA0)
unnamed: R2.1, U4.3 (PA1)
unnamed: R3.1, U4.4 (PA2)
unnamed: R4.1, U4.5 (PA3)
unnamed: R5.1, U4.6 (PA4)
unnamed: R6.1, U4.7 (PA5)
unnamed: R7.1, U4.8 (PA6)
unnamed: R8.1, U4.9 (PA7)
VCC: C3.1, C4.1, C5.1, D1.1 (K), J1.15, J1.S, Q2.1 (E), Q5.1 (E), Q6.1 (E), Q7.1 (E), Q8.1 (E), Q9.1 (E), Q10.1 (E), Q12.1 (E), R10.2, R11.1, R12.1, R13.2, R14.2, R15.2, R18.1, R19.1, R30.2, RN3.1 (common), U1.3 (MR), U1.6 (~NMI), U1.8 (VCC), U1.35 (VCC_STANDBY), U1.36 (RE), U2.21 (VPP), U2.24 (VCC), U3.14 (VCC), U4.20 (VCC)
