btb/Telcon-Ambassador/boards/mainboard/mainboard.kicad_pcb

## KiCad design boards/mainboard/mainboard.kicad_pcb (2024-08-22)

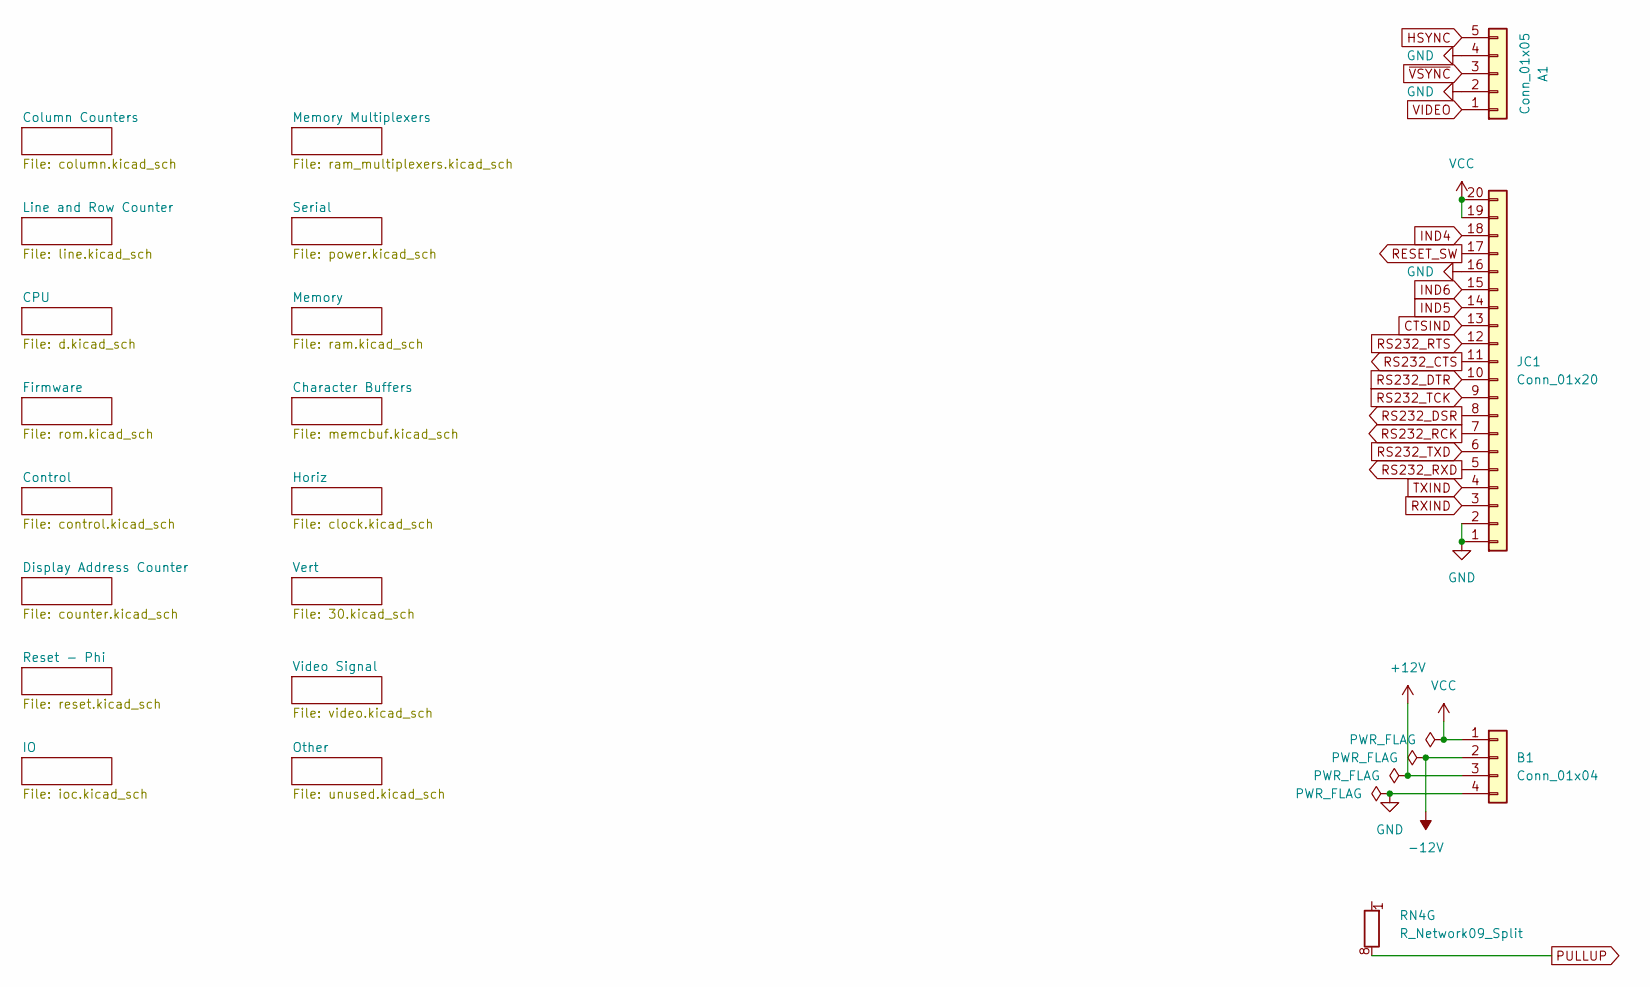
[picture p34: schematic mainboard.kicad_sch]

Parts:
A1: Conn_01x05; SolderWire-0.75sqmm_1x05_P6.35mm_D1.25mm_OD2.3mm
B1: Conn_01x04; SolderWire-2sqmm_1x04_P7.8mm_D2mm_OD3.9mm
JC1: Conn_01x20; SolderWire-0.75sqmm_1x020_P3.96mm_D1.25mm_OD2.3mm
RN4: R_Network09_Split; R_Array_SIP10

Connections:
+12V: B1.3; also elsewhere on the board
-12V: B1.2; also elsewhere on the board
CTSIND: JC1.13; also elsewhere on the board
GND: A1.2, A1.4, B1.4, JC1.1, JC1.2, JC1.16; also elsewhere on the board
HSYNC: A1.5; also elsewhere on the board
IND4: JC1.18; also elsewhere on the board
IND5: JC1.14; also elsewhere on the board
IND6: JC1.15; also elsewhere on the board
PULLUP: RN4.8 (R7.2); also elsewhere on the board
RESET_SW: JC1.17; also elsewhere on the board
RS232_CTS: JC1.11; also elsewhere on the board
RS232_DSR: JC1.8; also elsewhere on the board
RS232_DTR: JC1.10; also elsewhere on the board
RS232_RCK: JC1.7, JC1.9; also elsewhere on the board
RS232_RTS: JC1.12; also elsewhere on the board
RS232_RXD: JC1.5; also elsewhere on the board
RS232_TXD: JC1.6; also elsewhere on the board
RXIND: JC1.3; also elsewhere on the board
TXIND: JC1.4; also elsewhere on the board
VCC: B1.1, JC1.19, JC1.20; also elsewhere on the board
VIDEO: A1.1; also elsewhere on the board
~VSYNC: A1.3; also elsewhere on the board

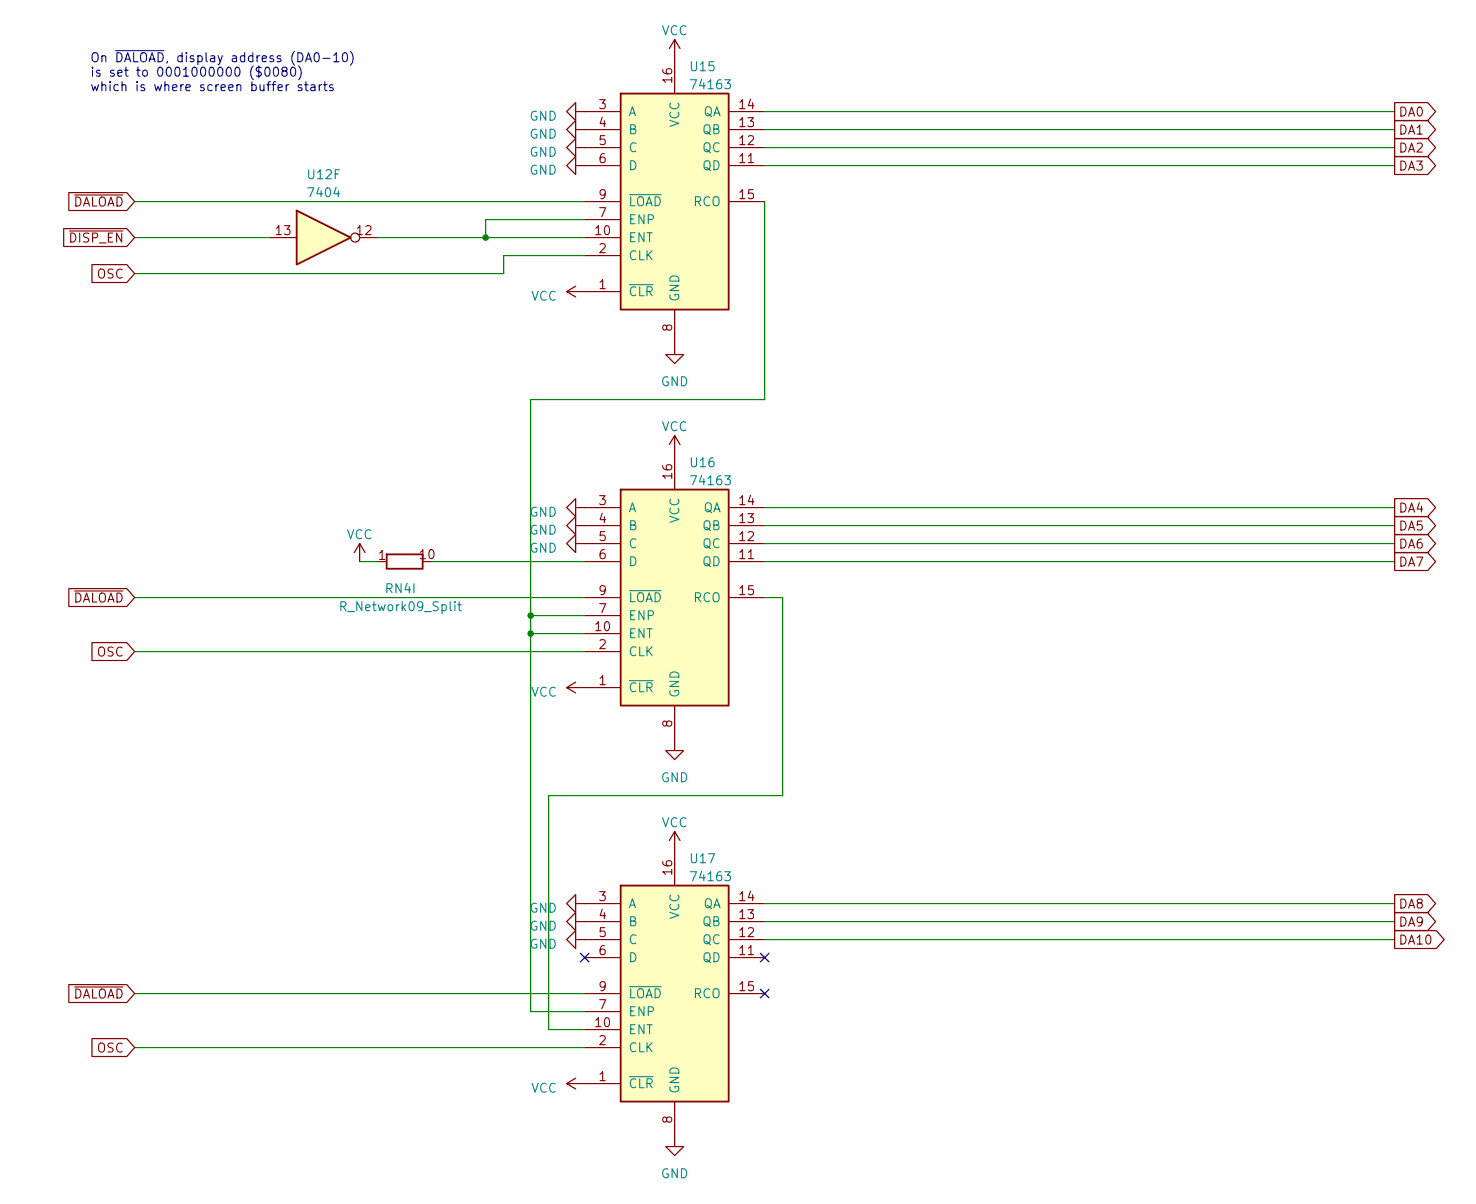
[picture p35: schematic counter.kicad_sch]

Parts:
RN4: R_Network09_Split; R_Array_SIP10
U12: 7404; DIP-14_W7.62mm
U15, U16, U17: 74163; DIP-16_W7.62mm

Connections:
DA0: U15.14 (QA); also elsewhere on the board
DA1: U15.13 (QB); also elsewhere on the board
DA2: U15.12 (QC); also elsewhere on the board
DA3: U15.11 (QD); also elsewhere on the board
DA4: U16.14 (QA); also elsewhere on the board
DA5: U16.13 (QB); also elsewhere on the board
DA6: U16.12 (QC); also elsewhere on the board
DA7: U16.11 (QD); also elsewhere on the board
DA8: U17.14 (QA); also elsewhere on the board
DA9: U17.13 (QB); also elsewhere on the board
DA10: U17.12 (QC); also elsewhere on the board
GND: U15.3 (A), U15.4 (B), U15.5 (C), U15.6 (D), U15.8 (GND), U16.3 (A), U16.4 (B), U16.5 (C), U16.8 (GND), U17.3 (A), U17.4 (B), U17.5 (C), U17.8 (GND); also elsewhere on the board
unnamed: RN4.10 (R9.2), U16.6 (D)
unnamed: U12.12, U15.7 (ENP), U15.10 (ENT)
unnamed: U15.15 (RCO), U16.7 (ENP), U16.10 (ENT), U17.7 (ENP)
unnamed: U16.15 (RCO), U17.10 (ENT)
OSC: U15.2 (CLK), U16.2 (CLK), U17.2 (CLK); also elsewhere on the board
VCC: U15.1 (~CLR), U15.16 (VCC), U16.1 (~CLR), U16.16 (VCC), U17.1 (~CLR), U17.16 (VCC); also elsewhere on the board
~DALOAD: U15.9 (~LOAD), U16.9 (~LOAD), U17.9 (~LOAD); also elsewhere on the board
~DISP_EN: U12.13; also elsewhere on the board

Notes on the sheet:
On ~{DALOAD}, display address (DA0-10) is set to 0001000000 ($0080) which is where screen buffer starts
