btb/Telcon-Ambassador/boards/mainboard/mainboard.kicad_pcb

## KiCad design boards/mainboard/mainboard.kicad_pcb (continued)

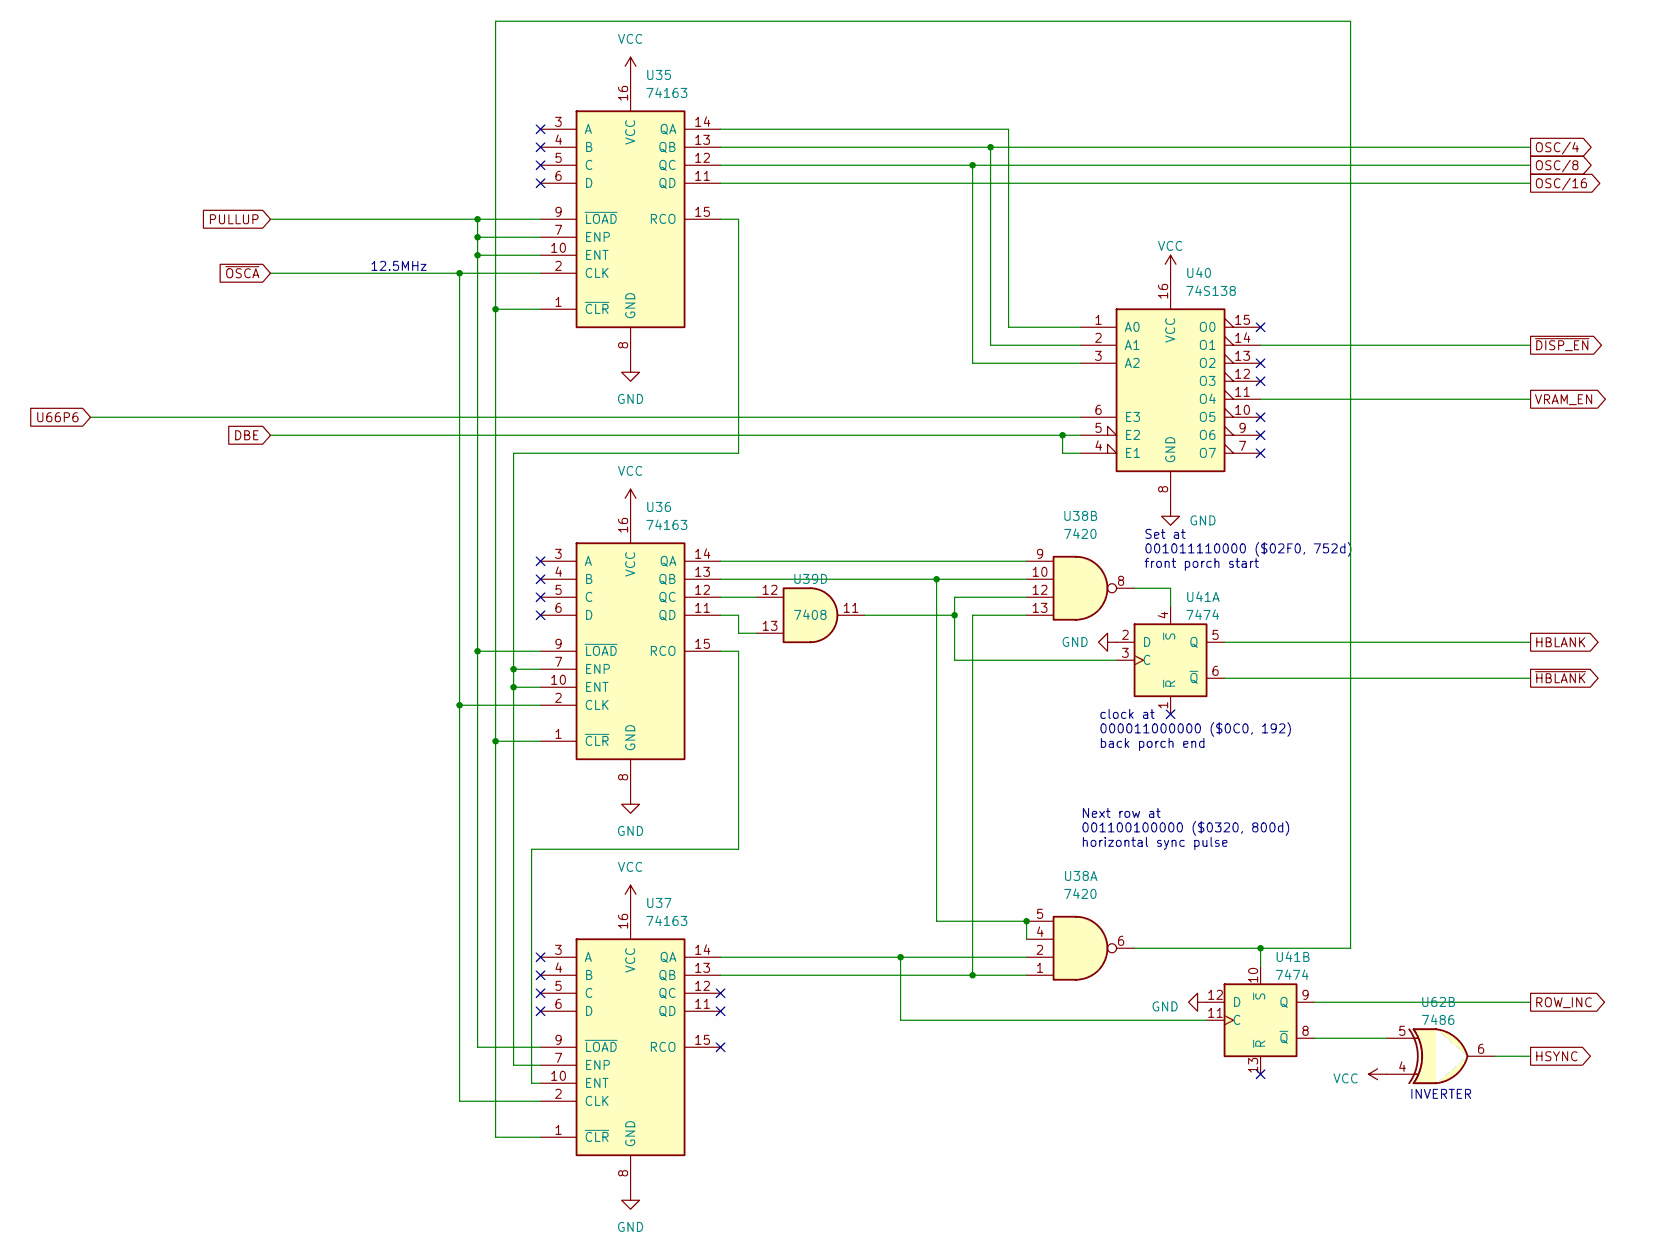
[picture p36: schematic clock.kicad_sch]

Parts:
U35, U36, U37: 74163; DIP-16_W7.62mm
U38: 7420; DIP-14_W7.62mm
U39: 7408; DIP-14_W7.62mm
U40: 74S138; DIP-16_W7.62mm
U41: 7474; DIP-14_W7.62mm
U62: 7486; DIP-14_W7.62mm

Connections:
DBE: U40.4 (E1), U40.5 (E2); also elsewhere on the board
GND: U35.8 (GND), U36.8 (GND), U37.8 (GND), U40.8 (GND), U41.2 (D), U41.12 (D); also elsewhere on the board
HBLANK: U41.5 (Q); also elsewhere on the board
HSYNC: U62.6; also elsewhere on the board
unnamed: U35.14 (QA), U40.1 (A0)
unnamed: U35.15 (RCO), U36.7 (ENP), U36.10 (ENT), U37.7 (ENP)
unnamed: U35.1 (~CLR), U36.1 (~CLR), U37.1 (~CLR), U38.6, U41.10 (~S)
unnamed: U36.14 (QA), U38.9
unnamed: U36.13 (QB), U38.4, U38.5, U38.10
unnamed: U36.12 (QC), U39.12
unnamed: U36.11 (QD), U39.13
unnamed: U36.15 (RCO), U37.10 (ENT)
unnamed: U37.14 (QA), U38.2, U41.11 (C)
unnamed: U37.13 (QB), U38.1, U38.13
unnamed: U38.12, U39.11, U41.3 (C)
unnamed: U38.8, U41.4 (~S)
unnamed: U41.8 (~Q), U62.5
OSC/4: U35.13 (QB), U40.2 (A1); also elsewhere on the board
OSC/8: U35.12 (QC), U40.3 (A2); also elsewhere on the board
OSC/16: U35.11 (QD); also elsewhere on the board
PULLUP: U35.7 (ENP), U35.9 (~LOAD), U35.10 (ENT), U36.9 (~LOAD), U37.9 (~LOAD); also elsewhere on the board
ROW_INC: U41.9 (Q); also elsewhere on the board
U66P6: U40.6 (E3); also elsewhere on the board
VCC: U35.16 (VCC), U36.16 (VCC), U37.16 (VCC), U40.16 (VCC), U62.4; also elsewhere on the board
VRAM_EN: U40.11 (O4); also elsewhere on the board
~DISP_EN: U40.14 (O1); also elsewhere on the board
~HBLANK: U41.6 (~Q); also elsewhere on the board
~OSCA: U35.2 (CLK), U36.2 (CLK), U37.2 (CLK); also elsewhere on the board

Notes on the sheet:
Next row at 001100100000 ($0320, 800d) horizontal sync pulse
INVERTER
12.5MHz
clock at 000011000000 ($0C0, 192) back porch end
Set at 001011110000 ($02F0, 752d) front porch start

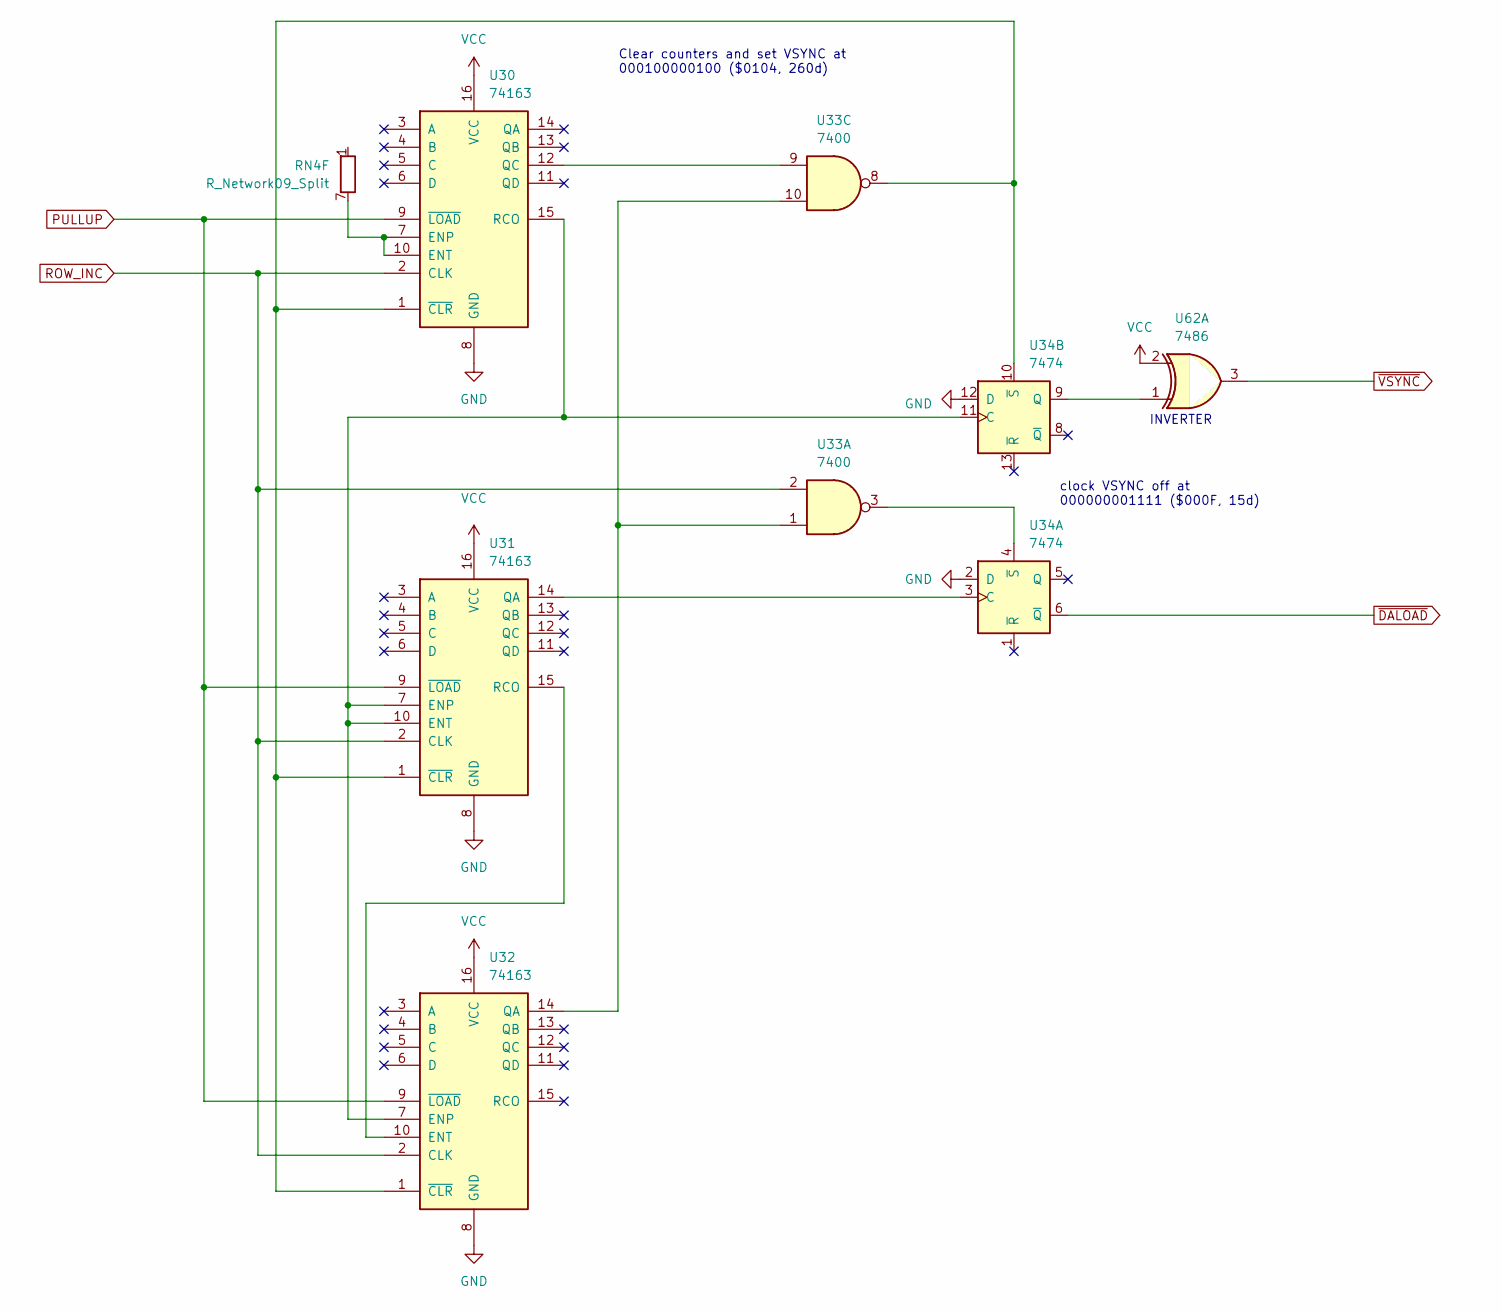
[picture p37: schematic 30.kicad_sch]

Parts:
RN4: R_Network09_Split; R_Array_SIP10
U30, U31, U32: 74163; DIP-16_W7.62mm
U33: 7400; DIP-14_W7.62mm
U34: 7474; DIP-14_W7.62mm
U62: 7486; DIP-14_W7.62mm

Connections:
GND: U30.8 (GND), U31.8 (GND), U32.8 (GND), U34.2 (D), U34.12 (D); also elsewhere on the board
unnamed: RN4.7 (R6.2), U30.7 (ENP), U30.10 (ENT)
unnamed: U30.12 (QC), U33.9
unnamed: U30.15 (RCO), U31.7 (ENP), U31.10 (ENT), U32.7 (ENP), U34.11 (C)
unnamed: U30.1 (~CLR), U31.1 (~CLR), U32.1 (~CLR), U33.8, U34.10 (~S)
unnamed: U31.14 (QA), U34.3 (C)
unnamed: U31.15 (RCO), U32.10 (ENT)
unnamed: U32.14 (QA), U33.1, U33.10
unnamed: U33.3, U34.4 (~S)
unnamed: U34.9 (Q), U62.1
PULLUP: U30.9 (~LOAD), U31.9 (~LOAD), U32.9 (~LOAD); also elsewhere on the board
ROW_INC: U30.2 (CLK), U31.2 (CLK), U32.2 (CLK), U33.2; also elsewhere on the board
VCC: U30.16 (VCC), U31.16 (VCC), U32.16 (VCC), U62.2; also elsewhere on the board
~DALOAD: U34.6 (~Q); also elsewhere on the board
~VSYNC: U62.3; also elsewhere on the board

Notes on the sheet:
INVERTER
Clear counters and set VSYNC at 000100000100 ($0104, 260d)
clock VSYNC off at 000000001111 ($000F, 15d)

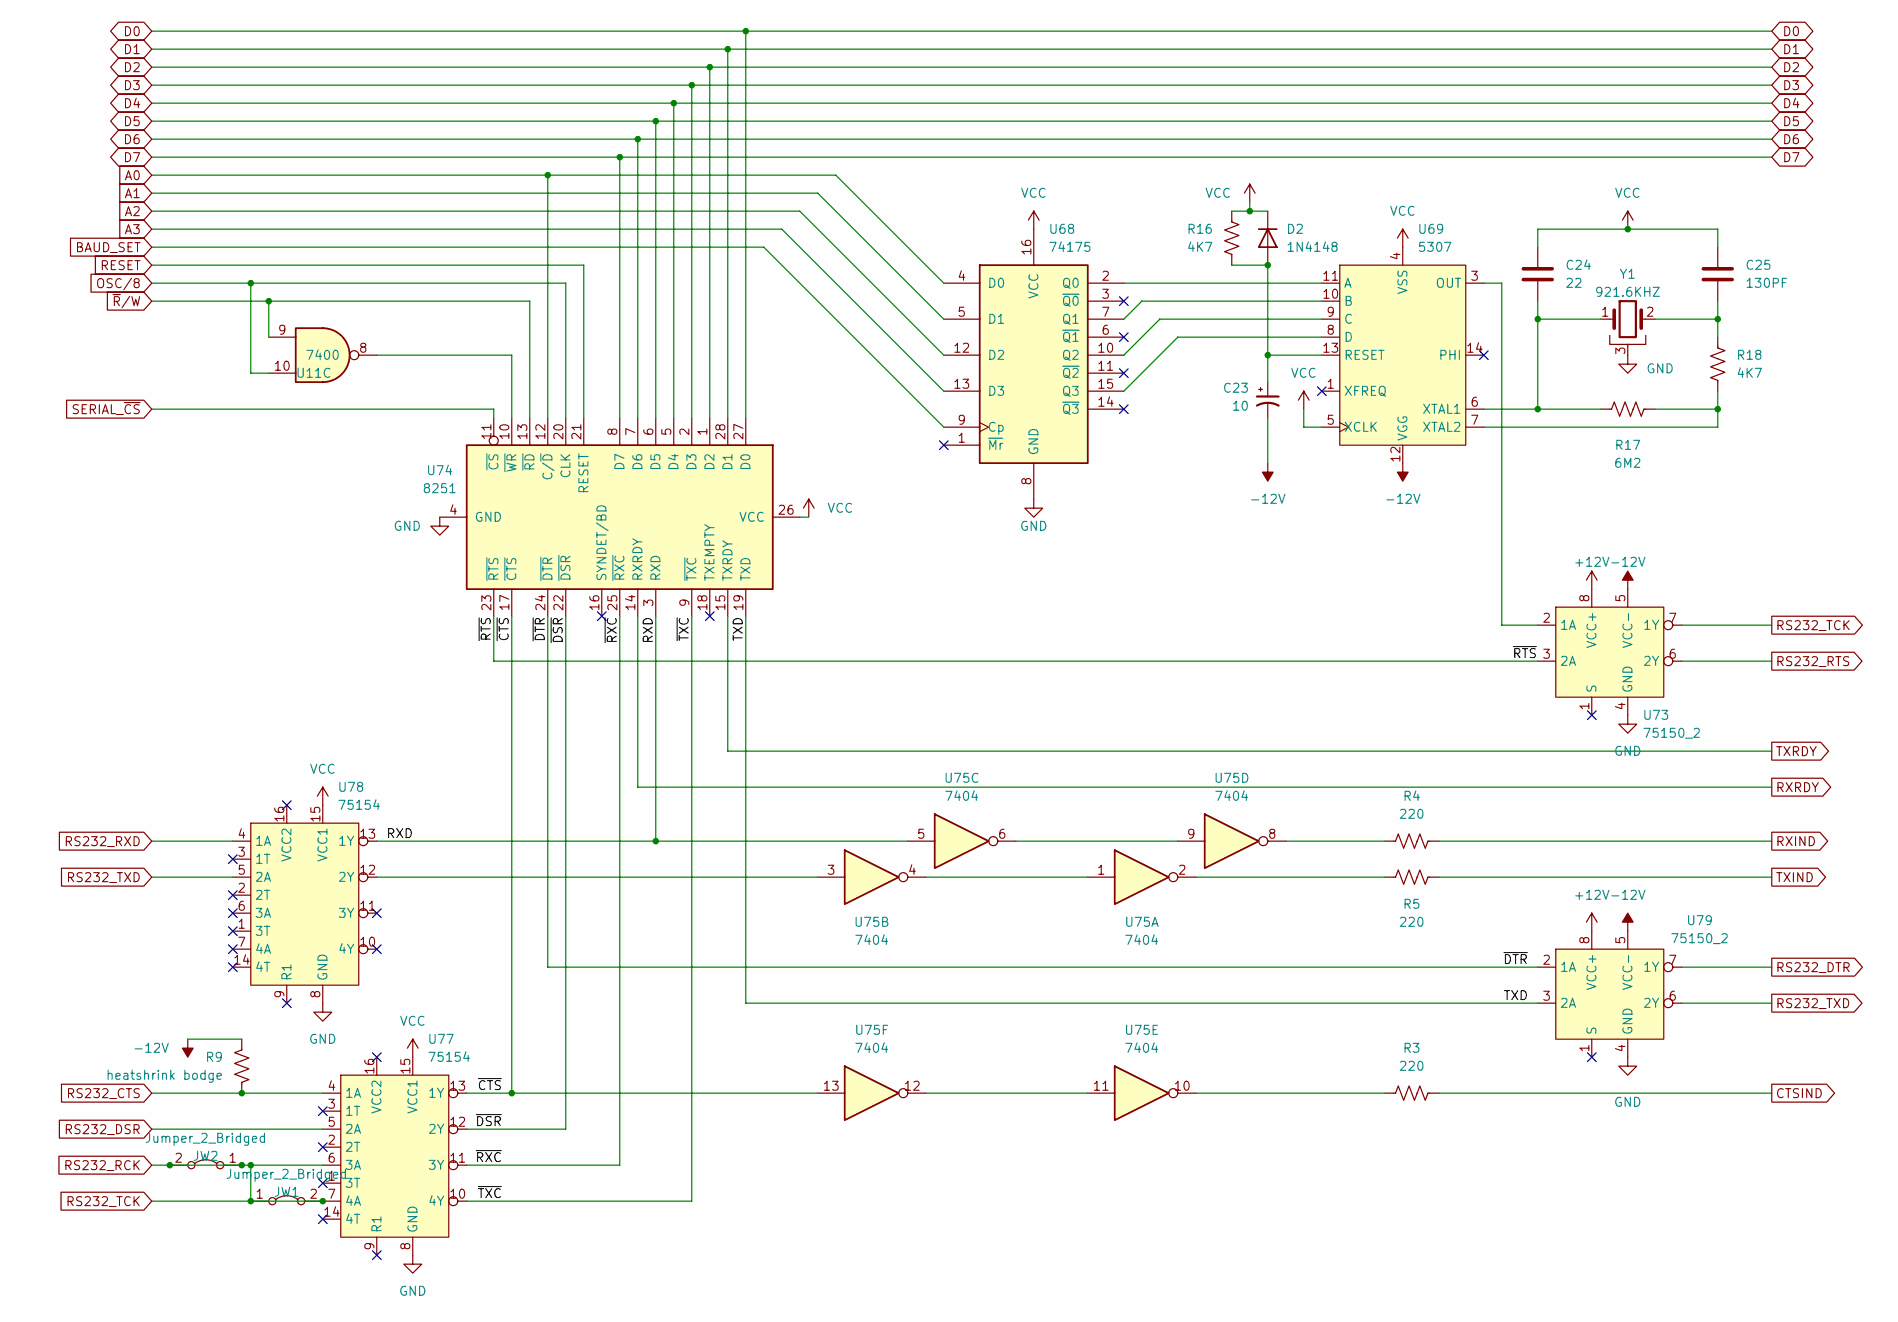
[picture p38: schematic power.kicad_sch]

Parts:
C23: 10; CP_Radial_Tantal_D4.5mm_P5.00mm
C24: 22; C_Disc_D11.0mm_W5.0mm_P7.50mm
C25: 130PF; C_Disc_D11.0mm_W5.0mm_P7.50mm
D2: 1N4148; D_DO-35_SOD27_P7.62mm_Horizontal
JW1: Jumper_2_Bridged; SolderWire-0.5sqmm_1x02_P10.16mm_D0.9mm_OD2.1mm
JW2: Jumper_2_Bridged; SolderWire-0.5sqmm_1x02_P12.7mm_D0.9mm_OD2.1mm
R3, R4, R5: 220; R_Axial_DIN0309_L9.0mm_D3.2mm_P12.70mm_Horizontal
R9: heatshrink bodge; R_Axial_DIN0309_L9.0mm_D3.2mm_P12.70mm_Horizontal
R16, R18: 4K7; R_Axial_DIN0309_L9.0mm_D3.2mm_P12.70mm_Horizontal
R17: 6M2; R_Axial_DIN0309_L9.0mm_D3.2mm_P12.70mm_Horizontal
U11: 7400; DIP-14_W7.62mm
U68: 74175; DIP-16_W7.62mm
U69: 5307; DIP-14_W7.62mm
U73, U79: 75150_2; DIP-8_W7.62mm
U74: 8251; DIP-28_W15.24mm
U75: 7404; DIP-14_W7.62mm
U77, U78: 75154; DIP-16_W7.62mm
Y1: 921.6KHZ; Crystal_HC33-U_Horizontal_1EP_style2

Connections:
+12V: U73.8 (VCC+), U79.8 (VCC+); also elsewhere on the board
-12V: C23.2, R9.2, U69.12 (VGG), U73.5 (VCC-), U79.5 (VCC-); also elsewhere on the board
/Serial/RXD: U74.3 (RXD), U75.5, U78.13 (1Y)
/Serial/TXD: U74.19 (TXD), U79.3 (2A)
/Serial/~CTS: U74.17 (~CTS), U75.13, U77.13 (1Y)
/Serial/~DSR: U74.22 (~DSR), U77.12 (2Y)
/Serial/~DTR: U74.24 (~DTR), U79.2 (1A)
/Serial/~RTS: U73.3 (2A), U74.23 (~RTS)
/Serial/~RXC: U74.25 (~RXC), U77.11 (3Y)
/Serial/~TXC: U74.9 (~TXC), U77.10 (4Y)
A0: U68.4 (D0), U74.12 (C/~D); also elsewhere on the board
A1: U68.5 (D1); also elsewhere on the board
A2: U68.12 (D2); also elsewhere on the board
A3: U68.13 (D3); also elsewhere on the board
BAUD_SET: U68.9 (Cp); also elsewhere on the board
CTSIND: R3.2; also elsewhere on the board
D0: U74.27 (D0); also elsewhere on the board
D1: U74.28 (D1); also elsewhere on the board
D2: U74.1 (D2); also elsewhere on the board
D3: U74.2 (D3); also elsewhere on the board
D4: U74.5 (D4); also elsewhere on the board
D5: U74.6 (D5); also elsewhere on the board
D6: U74.7 (D6); also elsewhere on the board
D7: U74.8 (D7); also elsewhere on the board
GND: U68.8 (GND), U73.4 (GND), U74.4 (GND), U77.8 (GND), U78.8 (GND), U79.4 (GND), Y1.3; also elsewhere on the board
unnamed: C25.1, R18.1, Y1.2
unnamed: C23.1, D2.2 (A), R16.1, U69.13 (RESET)
unnamed: R3.1, U75.10
unnamed: R4.1, U75.8
unnamed: R5.1, U75.2
unnamed: U68.2 (Q0), U69.11 (A)
unnamed: U68.7 (Q1), U69.10 (B)
unnamed: U68.10 (Q2), U69.9 (C)
unnamed: U68.15 (Q3), U69.8 (D)
unnamed: U69.3 (OUT), U73.2 (1A)
unnamed: C24.1, R17.1, U69.6 (XTAL1), Y1.1
unnamed: R17.2, R18.2, U69.7 (XTAL2)
unnamed: U11.8, U74.10 (~WR)
unnamed: U75.1, U75.4
unnamed: U75.6, U75.9
unnamed: U75.11, U75.12
unnamed: U75.3, U78.12 (2Y)
OSC/8: U11.10, U74.20 (CLK); also elsewhere on the board
RESET: U74.21 (RESET); also elsewhere on the board
RS232_CTS: R9.1, U77.4 (1A); also elsewhere on the board
RS232_DSR: U77.5 (2A); also elsewhere on the board
RS232_DTR: U79.7 (1Y); also elsewhere on the board
RS232_RCK: JW1.1 (A), JW1.2 (B), JW2.1 (A), JW2.2 (B), U73.7 (1Y), U77.6 (3A), U77.7 (4A); also elsewhere on the board
RS232_RTS: U73.6 (2Y); also elsewhere on the board
RS232_RXD: U78.4 (1A); also elsewhere on the board
RS232_TXD: U78.5 (2A), U79.6 (2Y); also elsewhere on the board
RXIND: R4.2; also elsewhere on the board
RXRDY: U74.14 (RXRDY); also elsewhere on the board
SERIAL_~CS: U74.11 (~CS); also elsewhere on the board
TXIND: R5.2; also elsewhere on the board
TXRDY: U74.15 (TXRDY); also elsewhere on the board
VCC: C24.2, C25.2, D2.1 (K), R16.2, U68.16 (VCC), U69.4 (VSS), U69.5 (XCLK), U74.26 (VCC), U77.15 (VCC1), U78.15 (VCC1); also elsewhere on the board
~R/W: U11.9, U74.13 (~RD); also elsewhere on the board

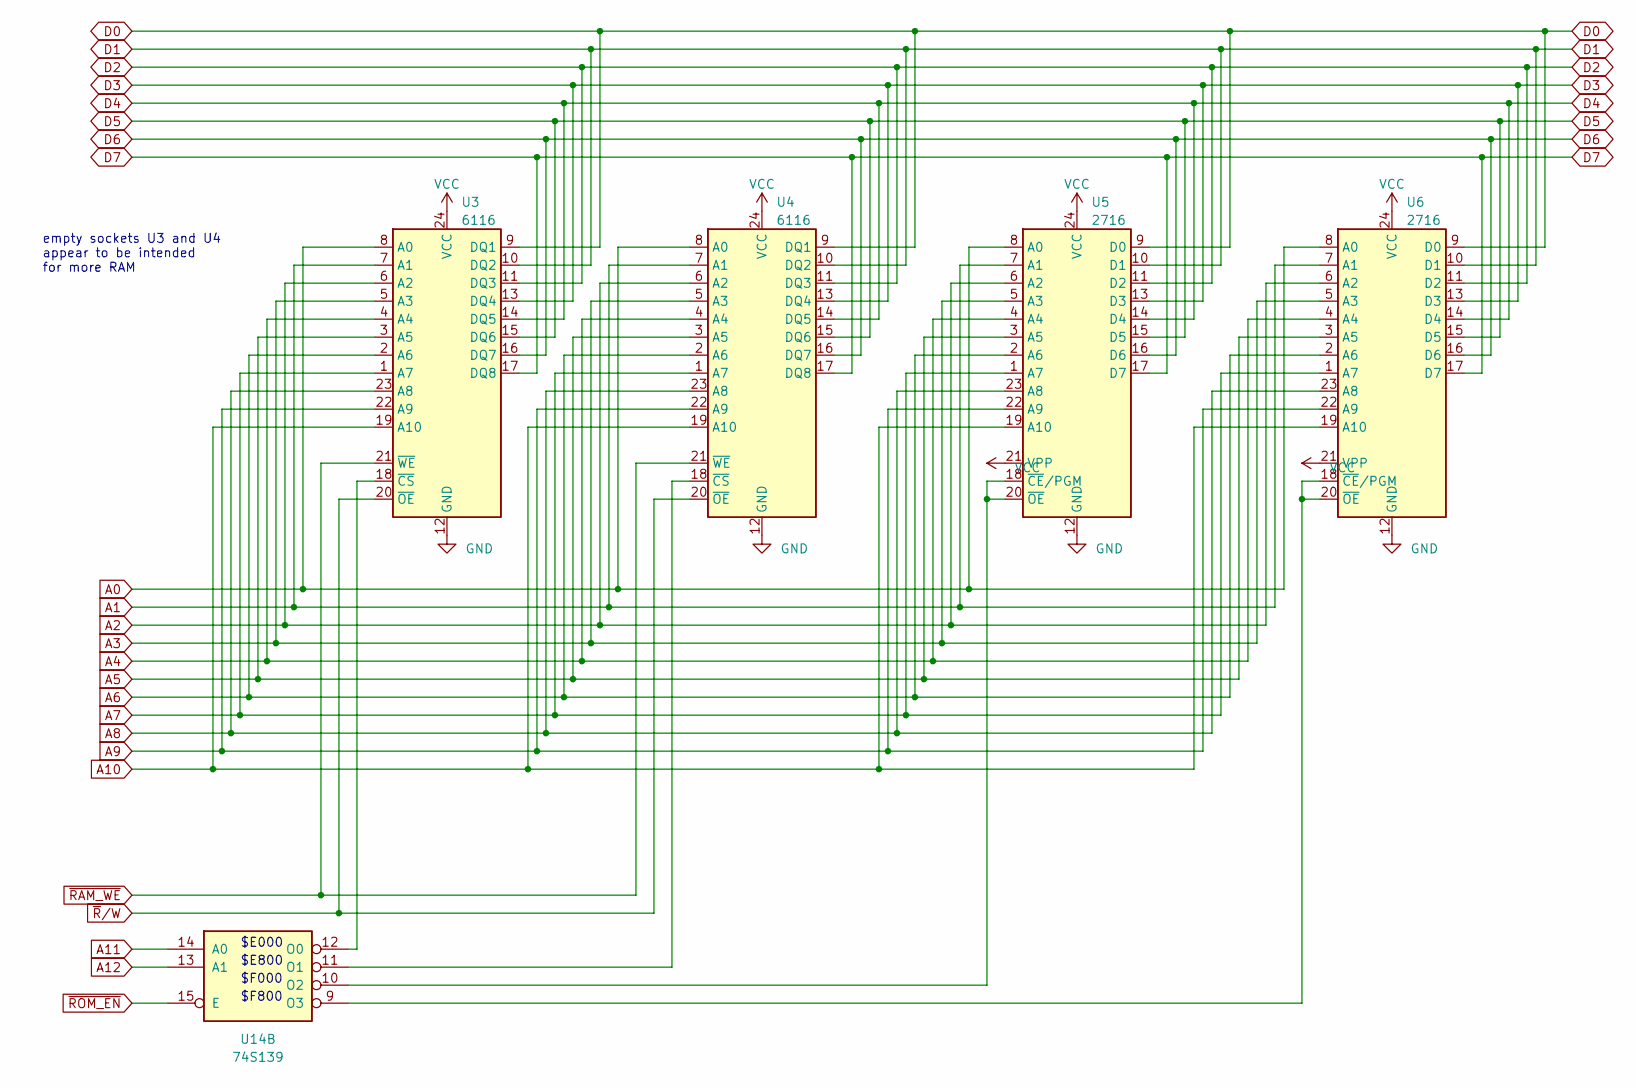
[picture p39: schematic rom.kicad_sch]

Parts:
U3, U4: 6116; DIP-24_W15.24mm
U5, U6: 2716; DIP-24_W15.24mm
U14: 74S139; DIP-16_W7.62mm

Connections:
A0: U3.8 (A0), U4.8 (A0), U5.8 (A0), U6.8 (A0); also elsewhere on the board
A1: U3.7 (A1), U4.7 (A1), U5.7 (A1), U6.7 (A1); also elsewhere on the board
A2: U3.6 (A2), U4.6 (A2), U5.6 (A2), U6.6 (A2); also elsewhere on the board
A3: U3.5 (A3), U4.5 (A3), U5.5 (A3), U6.5 (A3); also elsewhere on the board
A4: U3.4 (A4), U4.4 (A4), U5.4 (A4), U6.4 (A4); also elsewhere on the board
A5: U3.3 (A5), U4.3 (A5), U5.3 (A5), U6.3 (A5); also elsewhere on the board
A6: U3.2 (A6), U4.2 (A6), U5.2 (A6), U6.2 (A6); also elsewhere on the board
A7: U3.1 (A7), U4.1 (A7), U5.1 (A7), U6.1 (A7); also elsewhere on the board
A8: U3.23 (A8), U4.23 (A8), U5.23 (A8), U6.23 (A8); also elsewhere on the board
A9: U3.22 (A9), U4.22 (A9), U5.22 (A9), U6.22 (A9); also elsewhere on the board
A10: U3.19 (A10), U4.19 (A10), U5.19 (A10), U6.19 (A10); also elsewhere on the board
A11: U14.14 (A0); also elsewhere on the board
A12: U14.13 (A1); also elsewhere on the board
D0: U3.9 (DQ1), U4.9 (DQ1), U5.9 (D0), U6.9 (D0); also elsewhere on the board
D1: U3.10 (DQ2), U4.10 (DQ2), U5.10 (D1), U6.10 (D1); also elsewhere on the board
D2: U3.11 (DQ3), U4.11 (DQ3), U5.11 (D2), U6.11 (D2); also elsewhere on the board
D3: U3.13 (DQ4), U4.13 (DQ4), U5.13 (D3), U6.13 (D3); also elsewhere on the board
D4: U3.14 (DQ5), U4.14 (DQ5), U5.14 (D4), U6.14 (D4); also elsewhere on the board
D5: U3.15 (DQ6), U4.15 (DQ6), U5.15 (D5), U6.15 (D5); also elsewhere on the board
D6: U3.16 (DQ7), U4.16 (DQ7), U5.16 (D6), U6.16 (D6); also elsewhere on the board
D7: U3.17 (DQ8), U4.17 (DQ8), U5.17 (D7), U6.17 (D7); also elsewhere on the board
GND: U3.12 (GND), U4.12 (GND), U5.12 (GND), U6.12 (GND); also elsewhere on the board
unnamed: U3.18 (~CS), U14.12 (O0)
unnamed: U4.18 (~CS), U14.11 (O1)
unnamed: U5.18 (~CE/PGM), U5.20 (~OE), U14.10 (O2)
unnamed: U6.18 (~CE/PGM), U6.20 (~OE), U14.9 (O3)
VCC: U3.24 (VCC), U4.24 (VCC), U5.21 (VPP), U5.24 (VCC), U6.21 (VPP), U6.24 (VCC); also elsewhere on the board
~RAM_WE: U3.21 (~WE), U4.21 (~WE); also elsewhere on the board
~ROM_EN: U14.15 (E); also elsewhere on the board
~R/W: U3.20 (~OE), U4.20 (~OE); also elsewhere on the board

Notes on the sheet:
$F000
$F800
empty sockets U3 and U4 appear to be intended for more RAM
$E800
$E000

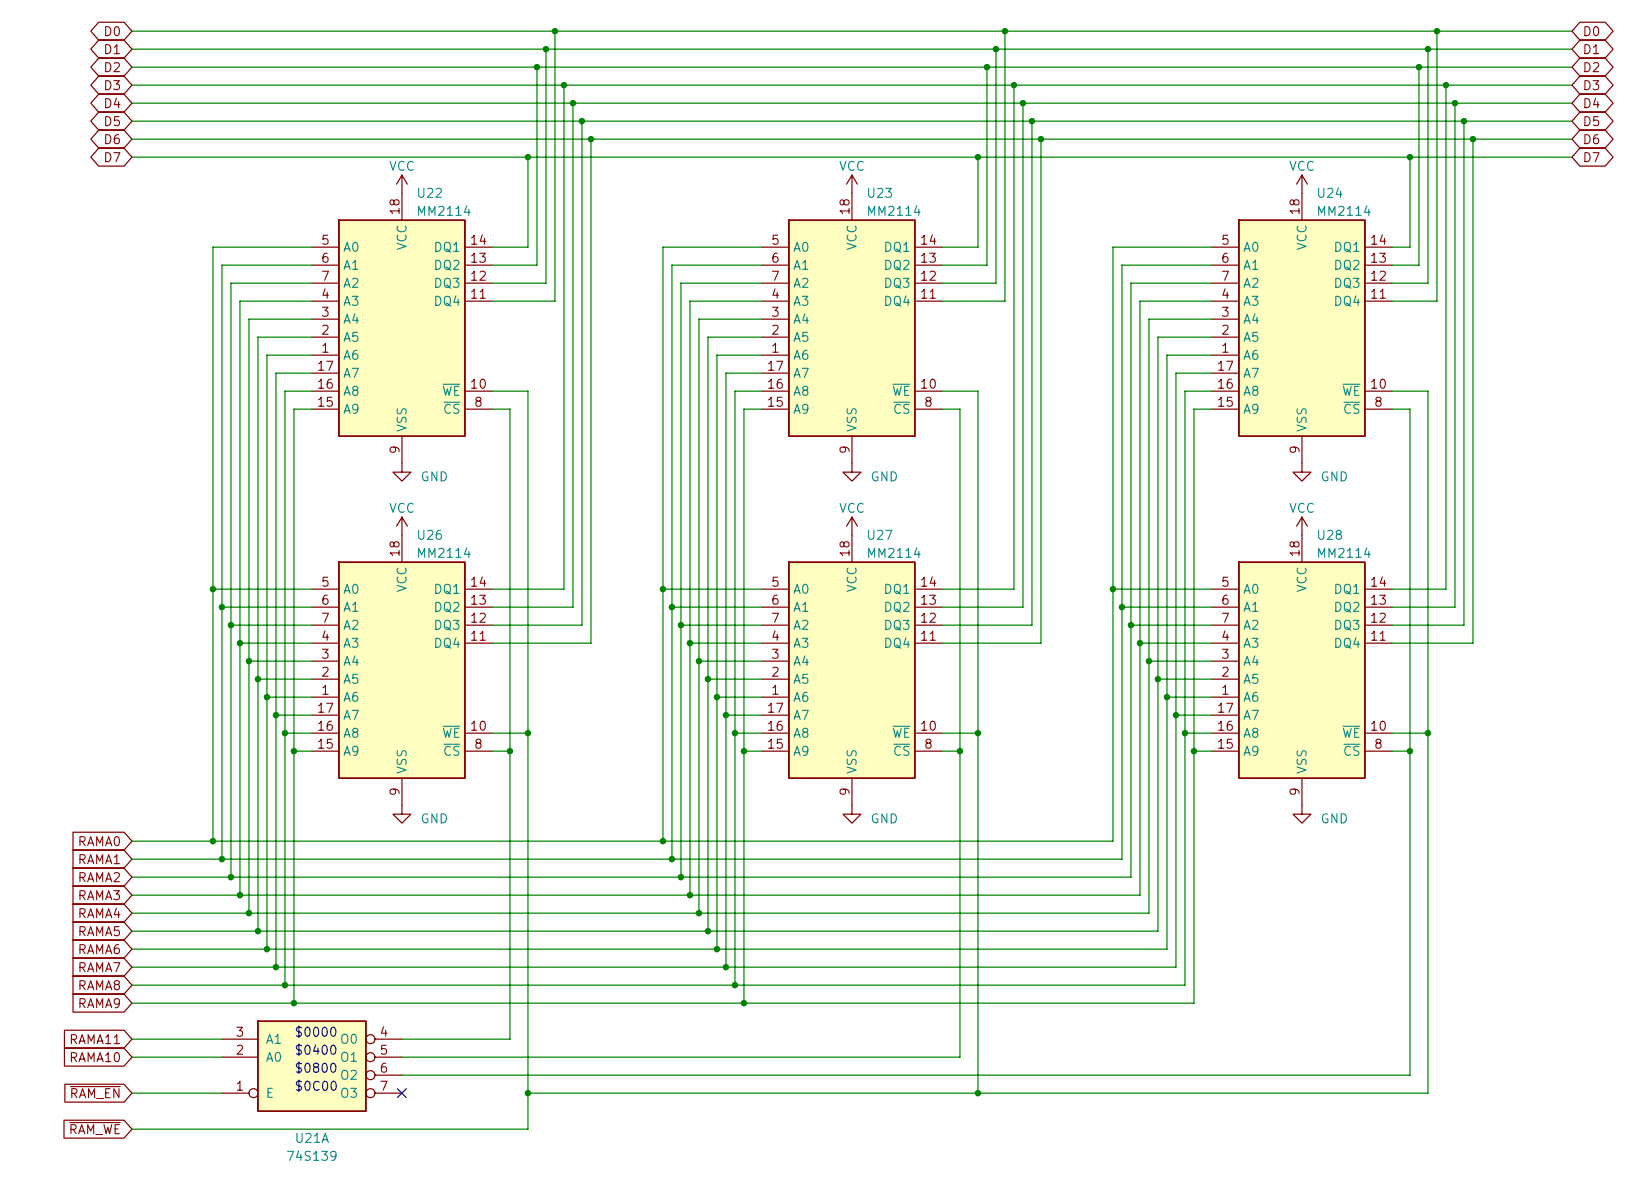
[picture p40: schematic ram.kicad_sch]

Parts:
U21: 74S139; DIP-16_W7.62mm
U22, U23, U24, U26, U27, U28: MM2114; DIP-18_W7.62mm

Connections:
D0: U22.11 (DQ4), U23.11 (DQ4), U24.11 (DQ4); also elsewhere on the board
D1: U22.12 (DQ3), U23.12 (DQ3), U24.12 (DQ3); also elsewhere on the board
D2: U22.13 (DQ2), U23.13 (DQ2), U24.13 (DQ2); also elsewhere on the board
D3: U26.14 (DQ1), U27.14 (DQ1), U28.14 (DQ1); also elsewhere on the board
D4: U26.13 (DQ2), U27.13 (DQ2), U28.13 (DQ2); also elsewhere on the board
D5: U26.12 (DQ3), U27.12 (DQ3), U28.12 (DQ3); also elsewhere on the board
D6: U26.11 (DQ4), U27.11 (DQ4), U28.11 (DQ4); also elsewhere on the board
D7: U22.14 (DQ1), U23.14 (DQ1), U24.14 (DQ1); also elsewhere on the board
GND: U22.9 (VSS), U23.9 (VSS), U24.9 (VSS), U26.9 (VSS), U27.9 (VSS), U28.9 (VSS); also elsewhere on the board
unnamed: U21.4 (O0), U22.8 (~CS), U26.8 (~CS)
unnamed: U21.5 (O1), U23.8 (~CS), U27.8 (~CS)
unnamed: U21.6 (O2), U24.8 (~CS), U28.8 (~CS)
RAMA0: U22.5 (A0), U23.5 (A0), U24.5 (A0), U26.5 (A0), U27.5 (A0), U28.5 (A0); also elsewhere on the board
RAMA1: U22.6 (A1), U23.6 (A1), U24.6 (A1), U26.6 (A1), U27.6 (A1), U28.6 (A1); also elsewhere on the board
RAMA2: U22.7 (A2), U23.7 (A2), U24.7 (A2), U26.7 (A2), U27.7 (A2), U28.7 (A2); also elsewhere on the board
RAMA3: U22.4 (A3), U23.4 (A3), U24.4 (A3), U26.4 (A3), U27.4 (A3), U28.4 (A3); also elsewhere on the board
RAMA4: U22.3 (A4), U23.3 (A4), U24.3 (A4), U26.3 (A4), U27.3 (A4), U28.3 (A4); also elsewhere on the board
RAMA5: U22.2 (A5), U23.2 (A5), U24.2 (A5), U26.2 (A5), U27.2 (A5), U28.2 (A5); also elsewhere on the board
RAMA6: U22.1 (A6), U23.1 (A6), U24.1 (A6), U26.1 (A6), U27.1 (A6), U28.1 (A6); also elsewhere on the board
RAMA7: U22.17 (A7), U23.17 (A7), U24.17 (A7), U26.17 (A7), U27.17 (A7), U28.17 (A7); also elsewhere on the board
RAMA8: U22.16 (A8), U23.16 (A8), U24.16 (A8), U26.16 (A8), U27.16 (A8), U28.16 (A8); also elsewhere on the board
RAMA9: U22.15 (A9), U23.15 (A9), U24.15 (A9), U26.15 (A9), U27.15 (A9), U28.15 (A9); also elsewhere on the board
RAMA10: U21.2 (A0); also elsewhere on the board
RAMA11: U21.3 (A1); also elsewhere on the board
VCC: U22.18 (VCC), U23.18 (VCC), U24.18 (VCC), U26.18 (VCC), U27.18 (VCC), U28.18 (VCC); also elsewhere on the board
~RAM_EN: U21.1 (E); also elsewhere on the board
~RAM_WE: U22.10 (~WE), U23.10 (~WE), U24.10 (~WE), U26.10 (~WE), U27.10 (~WE), U28.10 (~WE); also elsewhere on the board

Notes on the sheet:
$0000
$0400
$0800
$0C00

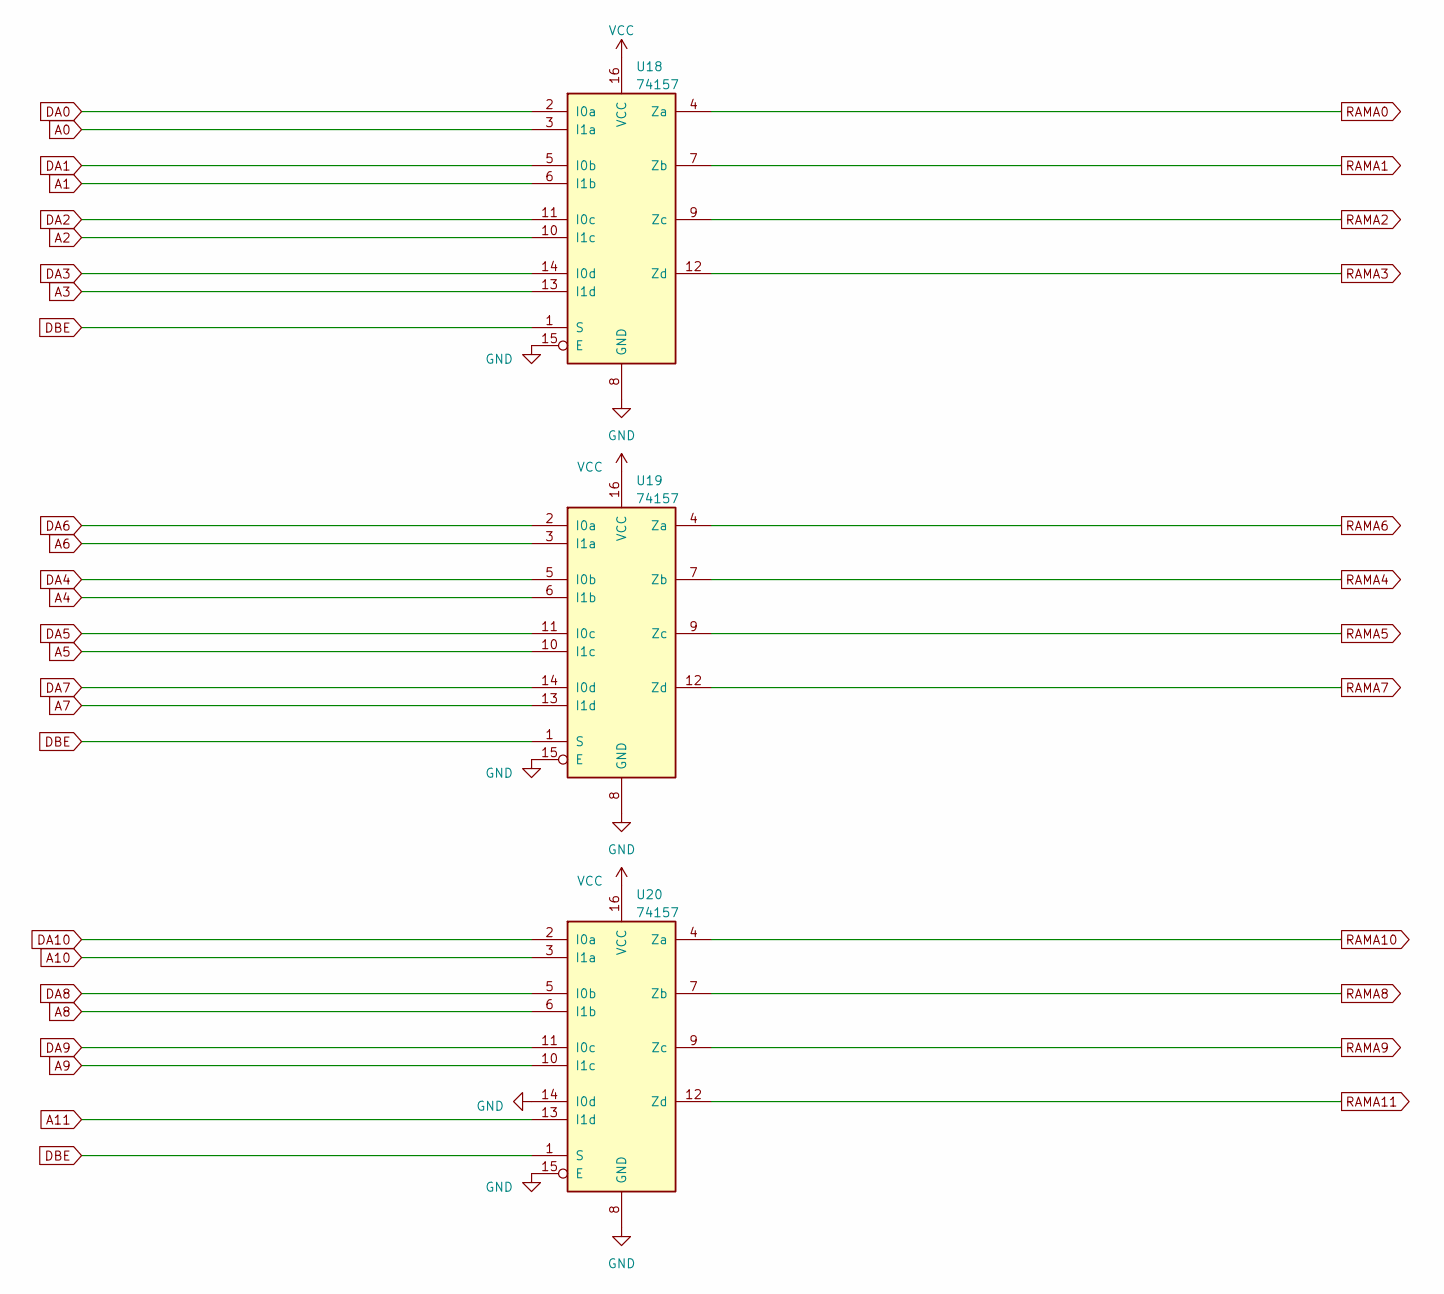
[picture p41: schematic ram_multiplexers.kicad_sch]

Parts:
U18, U19, U20: 74157; DIP-16_W7.62mm

Connections:
A0: U18.3 (I1a); also elsewhere on the board
A1: U18.6 (I1b); also elsewhere on the board
A2: U18.10 (I1c); also elsewhere on the board
A3: U18.13 (I1d); also elsewhere on the board
A4: U19.6 (I1b); also elsewhere on the board
A5: U19.10 (I1c); also elsewhere on the board
A6: U19.3 (I1a); also elsewhere on the board
A7: U19.13 (I1d); also elsewhere on the board
A8: U20.6 (I1b); also elsewhere on the board
A9: U20.10 (I1c); also elsewhere on the board
A10: U20.3 (I1a); also elsewhere on the board
A11: U20.13 (I1d); also elsewhere on the board
DA0: U18.2 (I0a); also elsewhere on the board
DA1: U18.5 (I0b); also elsewhere on the board
DA2: U18.11 (I0c); also elsewhere on the board
DA3: U18.14 (I0d); also elsewhere on the board
DA4: U19.5 (I0b); also elsewhere on the board
DA5: U19.11 (I0c); also elsewhere on the board
DA6: U19.2 (I0a); also elsewhere on the board
DA7: U19.14 (I0d); also elsewhere on the board
DA8: U20.5 (I0b); also elsewhere on the board
DA9: U20.11 (I0c); also elsewhere on the board
DA10: U20.2 (I0a); also elsewhere on the board
DBE: U18.1 (S), U19.1 (S), U20.1 (S); also elsewhere on the board
GND: U18.8 (GND), U18.15 (E), U19.8 (GND), U19.15 (E), U20.8 (GND), U20.14 (I0d), U20.15 (E); also elsewhere on the board
RAMA0: U18.4 (Za); also elsewhere on the board
RAMA1: U18.7 (Zb); also elsewhere on the board
RAMA2: U18.9 (Zc); also elsewhere on the board
RAMA3: U18.12 (Zd); also elsewhere on the board
RAMA4: U19.7 (Zb); also elsewhere on the board
RAMA5: U19.9 (Zc); also elsewhere on the board
RAMA6: U19.4 (Za); also elsewhere on the board
RAMA7: U19.12 (Zd); also elsewhere on the board
RAMA8: U20.7 (Zb); also elsewhere on the board
RAMA9: U20.9 (Zc); also elsewhere on the board
RAMA10: U20.4 (Za); also elsewhere on the board
RAMA11: U20.12 (Zd); also elsewhere on the board
VCC: U18.16 (VCC), U19.16 (VCC), U20.16 (VCC); also elsewhere on the board

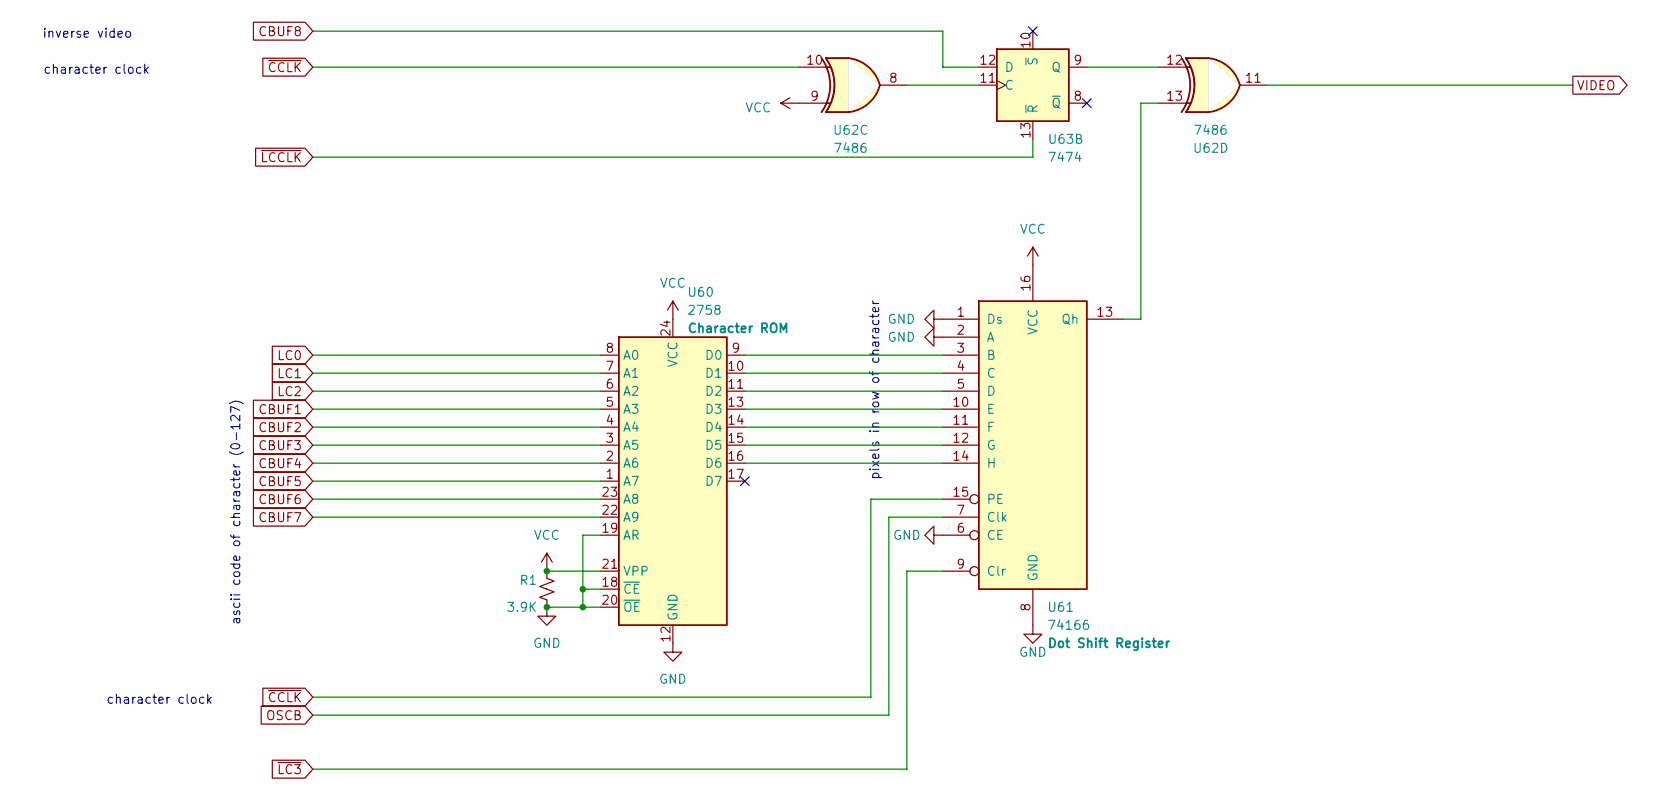
[picture p42: schematic video.kicad_sch]

Parts:
R1: 3.9K; R_Axial_DIN0309_L9.0mm_D3.2mm_P12.70mm_Horizontal
U60: 2758; DIP-24_W15.24mm
U61: 74166; DIP-16_W7.62mm
U62: 7486; DIP-14_W7.62mm
U63: 7474; DIP-14_W7.62mm

Connections:
CBUF1: U60.5 (A3); also elsewhere on the board
CBUF2: U60.4 (A4); also elsewhere on the board
CBUF3: U60.3 (A5); also elsewhere on the board
CBUF4: U60.2 (A6); also elsewhere on the board
CBUF5: U60.1 (A7); also elsewhere on the board
CBUF6: U60.23 (A8); also elsewhere on the board
CBUF7: U60.22 (A9); also elsewhere on the board
CBUF8: U63.12 (D); also elsewhere on the board
GND: R1.1, U60.12 (GND), U60.18 (~CE), U60.19 (AR), U60.20 (~OE), U61.1 (Ds), U61.2 (A), U61.6 (CE), U61.8 (GND); also elsewhere on the board
LC0: U60.8 (A0); also elsewhere on the board
LC1: U60.7 (A1); also elsewhere on the board
LC2: U60.6 (A2); also elsewhere on the board
unnamed: U60.9 (D0), U61.3 (B)
unnamed: U60.10 (D1), U61.4 (C)
unnamed: U60.11 (D2), U61.5 (D)
unnamed: U60.13 (D3), U61.10 (E)
unnamed: U60.14 (D4), U61.11 (F)
unnamed: U60.15 (D5), U61.12 (G)
unnamed: U60.16 (D6), U61.14 (H)
unnamed: U61.13 (Qh), U62.13
unnamed: U62.8, U63.11 (C)
unnamed: U62.12, U63.9 (Q)
OSCB: U61.7 (Clk); also elsewhere on the board
VCC: R1.2, U60.21 (VPP), U60.24 (VCC), U61.16 (VCC), U62.9; also elsewhere on the board
VIDEO: U62.11; also elsewhere on the board
~CCLK: U61.15 (PE), U62.10; also elsewhere on the board
~LC3: U61.9 (Clr); also elsewhere on the board
~LCCLK: U63.13 (~R); also elsewhere on the board

Notes on the sheet:
ascii code of character (0-127)
inverse video
character clock
pixels in row of character
