btb/Telcon-Ambassador/boards/mainboard/mainboard.kicad_pcb

## KiCad design boards/mainboard/mainboard.kicad_pcb (continued)

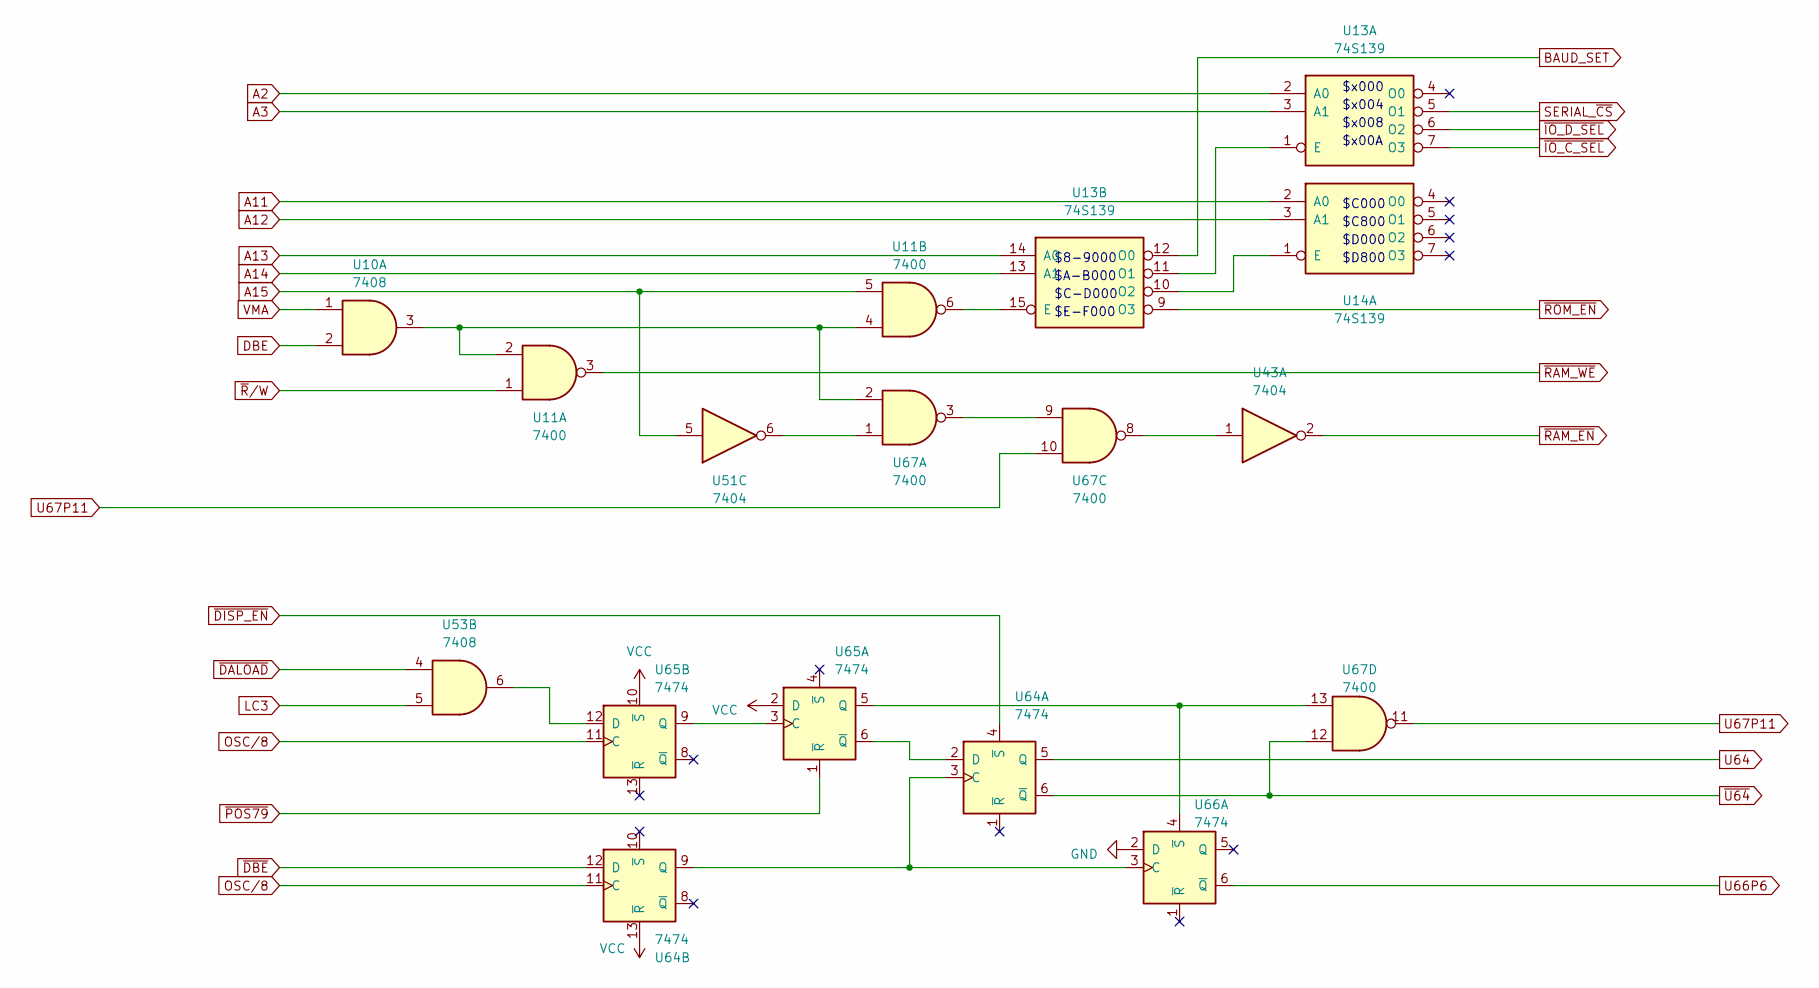
[picture p43: schematic control.kicad_sch]

Parts:
U10, U53: 7408; DIP-14_W7.62mm
U11, U67: 7400; DIP-14_W7.62mm
U13, U14: 74S139; DIP-16_W7.62mm
U43, U51: 7404; DIP-14_W7.62mm
U64, U65, U66: 7474; DIP-14_W7.62mm

Connections:
A2: U13.2 (A0); also elsewhere on the board
A3: U13.3 (A1); also elsewhere on the board
A11: U14.2 (A0); also elsewhere on the board
A12: U14.3 (A1); also elsewhere on the board
A13: U13.14 (A0); also elsewhere on the board
A14: U13.13 (A1); also elsewhere on the board
A15: U11.5, U51.5; also elsewhere on the board
BAUD_SET: U13.12 (O0); also elsewhere on the board
DBE: U10.2; also elsewhere on the board
GND: U66.2 (D); also elsewhere on the board
LC3: U53.5; also elsewhere on the board
unnamed: U10.3, U11.2, U11.4, U67.2
unnamed: U13.1 (E), U13.11 (O1)
unnamed: U11.6, U13.15 (E)
unnamed: U13.10 (O2), U14.1 (E)
unnamed: U43.1, U67.8
unnamed: U51.6, U67.1
unnamed: U64.3 (C), U64.9 (Q), U66.3 (C)
unnamed: U64.2 (D), U65.6 (~Q)
unnamed: U65.3 (C), U65.9 (Q)
unnamed: U65.5 (Q), U66.4 (~S), U67.13
unnamed: U53.6, U65.12 (D)
unnamed: U67.3, U67.9
OSC/8: U64.11 (C), U65.11 (C); also elsewhere on the board
SERIAL_~CS: U13.5 (O1); also elsewhere on the board
U64: U64.5 (Q); also elsewhere on the board
U66P6: U66.6 (~Q); also elsewhere on the board
U67P11: U67.10, U67.11
VCC: U64.13 (~R), U65.2 (D), U65.10 (~S); also elsewhere on the board
VMA: U10.1; also elsewhere on the board
~DALOAD: U53.4; also elsewhere on the board
~DBE: U64.12 (D); also elsewhere on the board
~DISP_EN: U64.4 (~S); also elsewhere on the board
~IO_C_SEL: U13.7 (O3); also elsewhere on the board
~IO_D_SEL: U13.6 (O2); also elsewhere on the board
~POS79: U65.1 (~R); also elsewhere on the board
~RAM_EN: U43.2; also elsewhere on the board
~RAM_WE: U11.3; also elsewhere on the board
~ROM_EN: U13.9 (O3); also elsewhere on the board
~R/W: U11.1; also elsewhere on the board
~U64: U64.6 (~Q), U67.12; also elsewhere on the board

Notes on the sheet:
$E-F000
$C800
$x000
$D800
$A-B000
$x00A
$C000
$x004
$x008
$D000
$8-9000
$C-D000

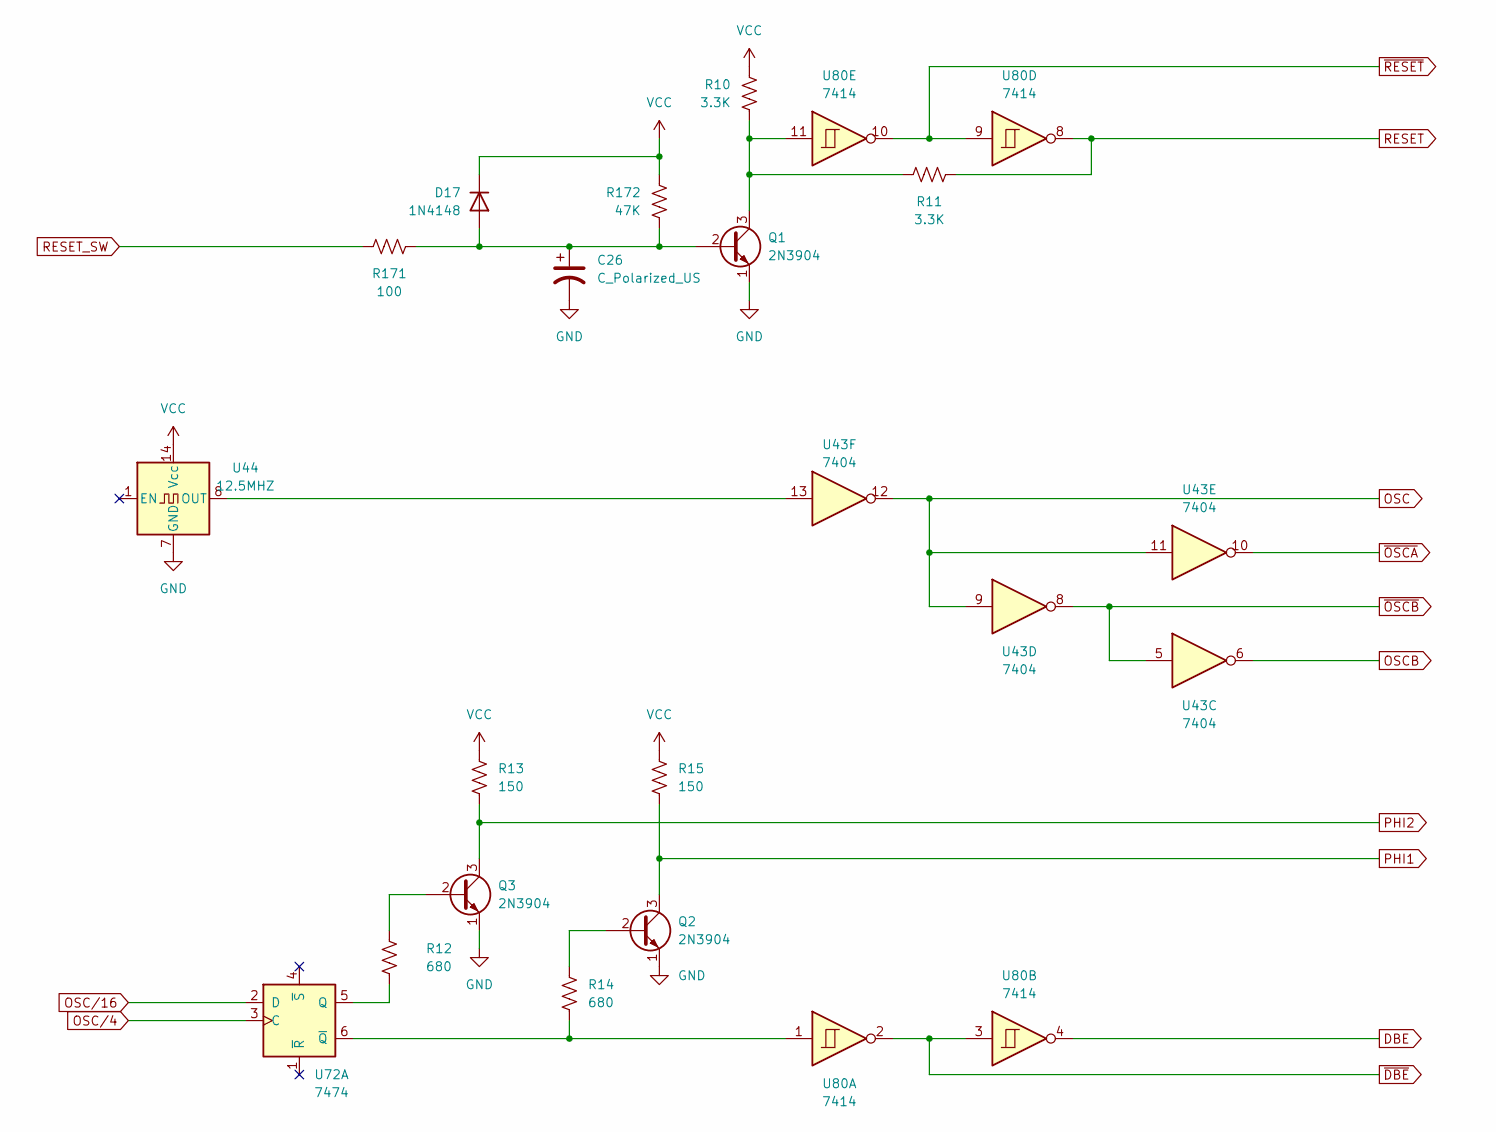
[picture p44: schematic reset.kicad_sch]

Parts:
C26: C_Polarized_US; CP_Axial_L18.0mm_D10.0mm_P25.00mm_Horizontal
D17: 1N4148; D_DO-35_SOD27_P7.62mm_Horizontal
Q1, Q2, Q3: 2N3904; TO-92_Inline
R10, R11: 3.3K; R_Axial_DIN0309_L9.0mm_D3.2mm_P12.70mm_Horizontal
R12, R14: 680; R_Axial_DIN0309_L9.0mm_D3.2mm_P12.70mm_Horizontal
R13, R15: 150; R_Axial_DIN0309_L9.0mm_D3.2mm_P12.70mm_Horizontal
R171: 100; R_Axial_DIN0309_L9.0mm_D3.2mm_P12.70mm_Horizontal
R172: 47K; R_Axial_DIN0309_L9.0mm_D3.2mm_P12.70mm_Horizontal
U43: 7404; DIP-14_W7.62mm
U44: 12.5MHZ; Oscillator_DIP-14
U72: 7474; DIP-14_W7.62mm
U80: 7414; DIP-14_W7.62mm

Connections:
DBE: U80.4; also elsewhere on the board
GND: C26.2, Q1.1 (E), Q2.1 (E), Q3.1 (E), U44.7 (GND); also elsewhere on the board
unnamed: C26.1, D17.2 (A), Q1.2 (B), R171.1, R172.1
unnamed: Q1.3 (C), R10.2, R11.2, U80.11
unnamed: Q2.2 (B), R14.1
unnamed: Q3.2 (B), R12.1
unnamed: U43.13, U44.8 (OUT)
unnamed: R12.2, U72.5 (Q)
unnamed: R14.2, U72.6 (~Q), U80.1
OSC: U43.9, U43.11, U43.12; also elsewhere on the board
OSCB: U43.6; also elsewhere on the board
OSC/4: U72.3 (C); also elsewhere on the board
OSC/16: U72.2 (D); also elsewhere on the board
PHI1: Q2.3 (C), R15.2; also elsewhere on the board
PHI2: Q3.3 (C), R13.2; also elsewhere on the board
RESET: R11.1, U80.8; also elsewhere on the board
RESET_SW: R171.2; also elsewhere on the board
VCC: D17.1 (K), R10.1, R13.1, R15.1, R172.2, U44.14 (Vcc); also elsewhere on the board
~DBE: U80.2, U80.3; also elsewhere on the board
~OSCA: U43.10; also elsewhere on the board
~OSCB: U43.5, U43.8; also elsewhere on the board
~RESET: U80.9, U80.10; also elsewhere on the board

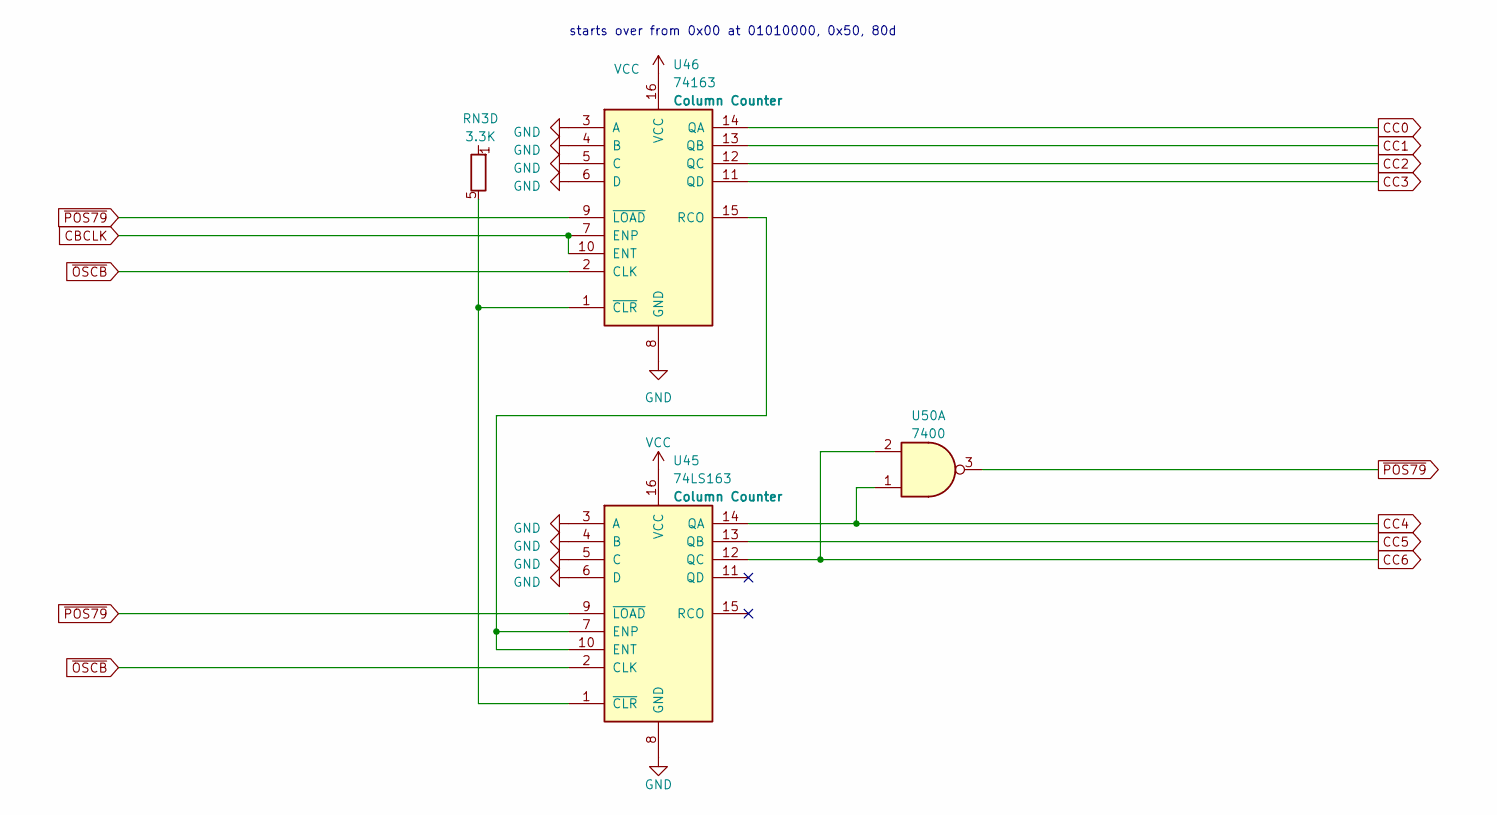
[picture p45: schematic column.kicad_sch]

Parts:
RN3: 3.3K; R_Array_SIP10
U45: 74LS163; DIP-16_W7.62mm
U46: 74163; DIP-16_W7.62mm
U50: 7400; DIP-14_W7.62mm

Connections:
CBCLK: U46.7 (ENP), U46.10 (ENT); also elsewhere on the board
CC0: U46.14 (QA); also elsewhere on the board
CC1: U46.13 (QB); also elsewhere on the board
CC2: U46.12 (QC); also elsewhere on the board
CC3: U46.11 (QD); also elsewhere on the board
CC4: U45.14 (QA), U50.1; also elsewhere on the board
CC5: U45.13 (QB); also elsewhere on the board
CC6: U45.12 (QC), U50.2; also elsewhere on the board
GND: U45.3 (A), U45.4 (B), U45.5 (C), U45.6 (D), U45.8 (GND), U46.3 (A), U46.4 (B), U46.5 (C), U46.6 (D), U46.8 (GND); also elsewhere on the board
unnamed: RN3.5 (R4.2), U45.1 (~CLR), U46.1 (~CLR)
unnamed: U45.7 (ENP), U45.10 (ENT), U46.15 (RCO)
VCC: U45.16 (VCC), U46.16 (VCC); also elsewhere on the board
~OSCB: U45.2 (CLK), U46.2 (CLK); also elsewhere on the board
~POS79: U45.9 (~LOAD), U46.9 (~LOAD), U50.3; also elsewhere on the board

Notes on the sheet:
starts over from 0x00 at 01010000, 0x50, 80d

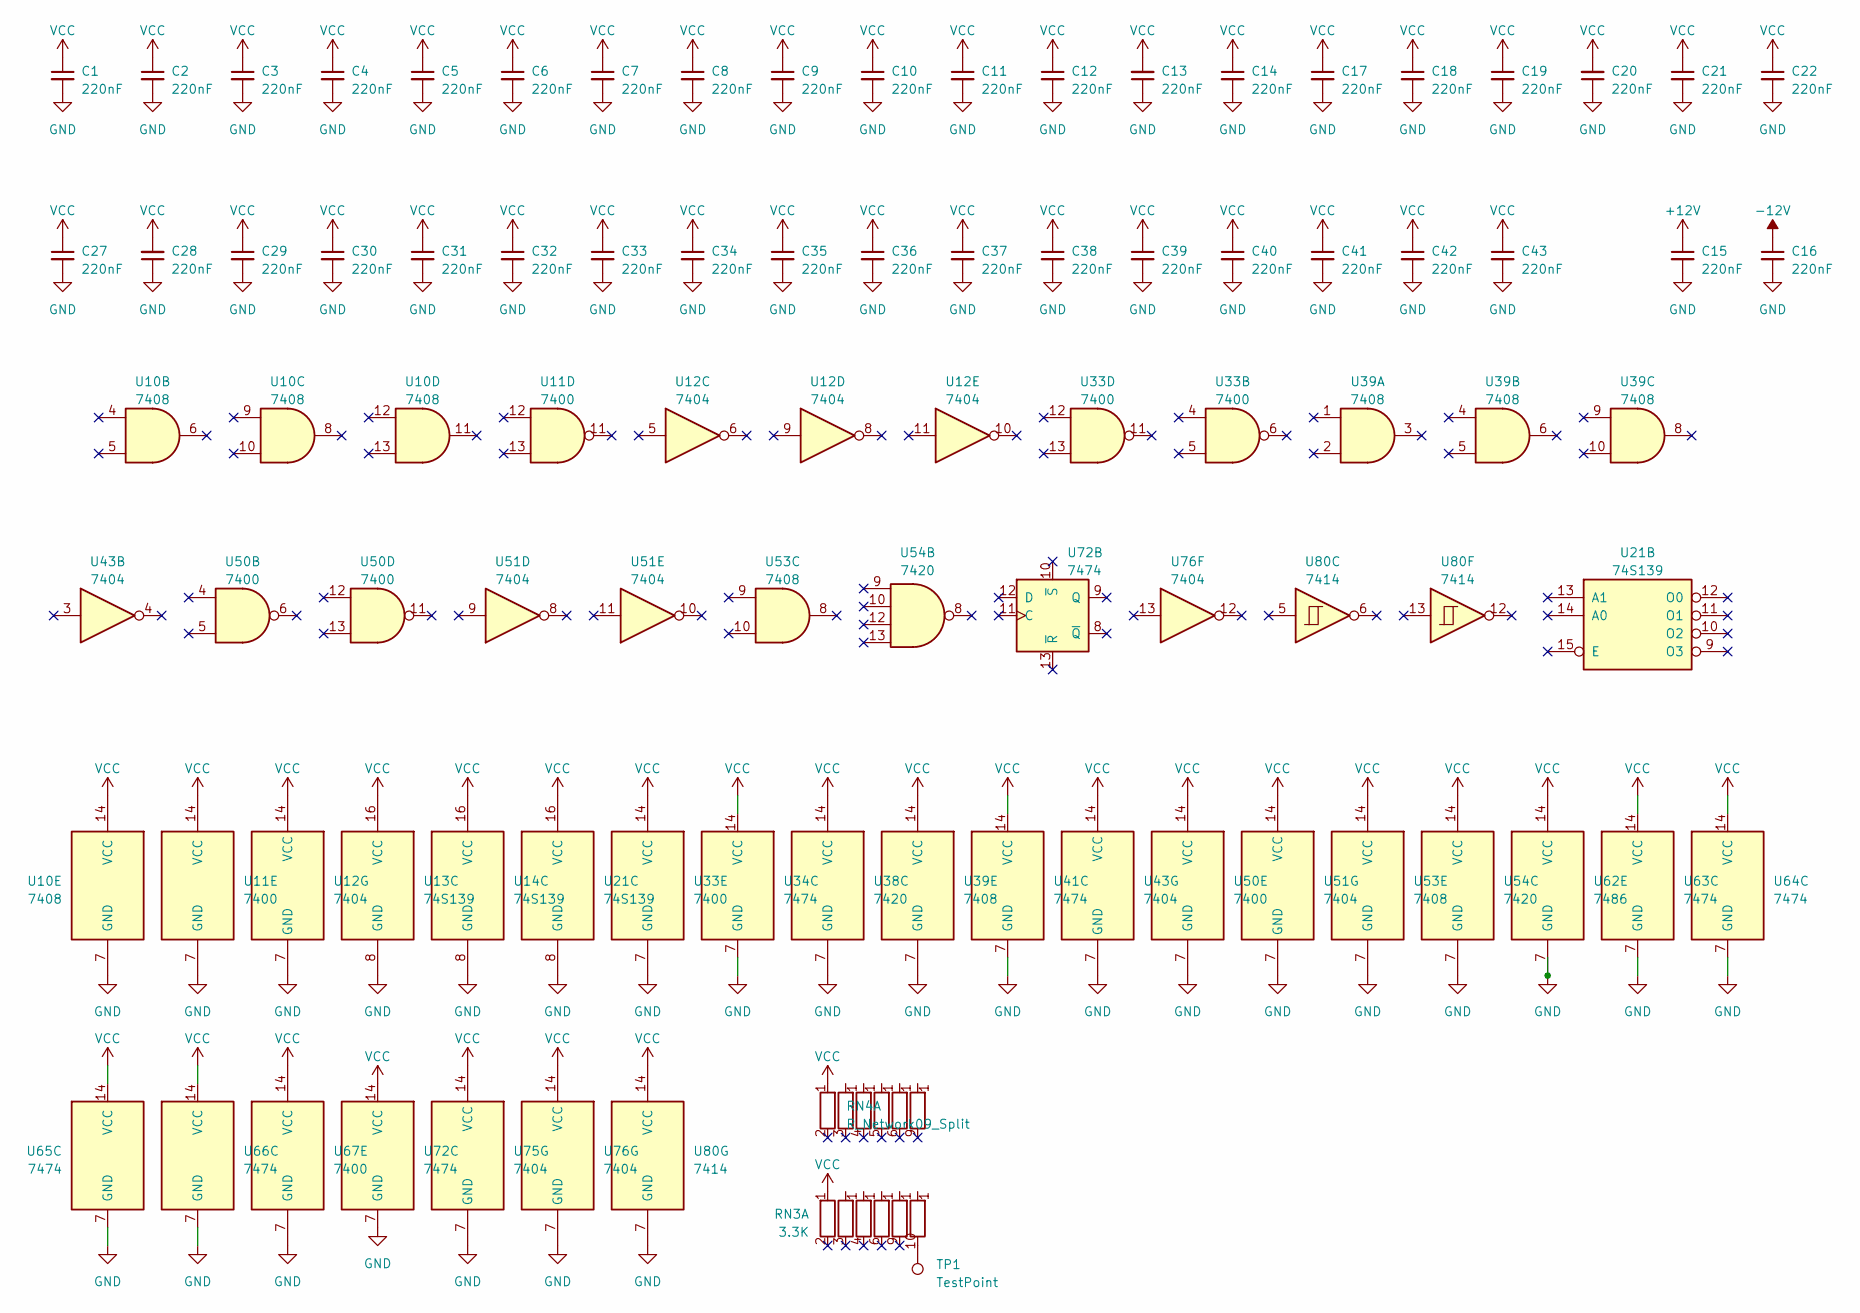
[picture p46: schematic unused.kicad_sch]

Parts:
C1, C2, C3, C4, C5, C6, C7, C8, C9, C10, C11, C12, C13, C14, C15, C16, C17, C18, C19, C20, C21, C22, C27, C28, C29, C30, C31, C32, C33, C34, C35, C36, C37, C38, C39, C40, C41, C42, C43: 220nF; C_Disc_D4.3mm_W1.9mm_P6.35mm
RN3: 3.3K; R_Array_SIP10
RN4: R_Network09_Split; R_Array_SIP10
TP1: TestPoint; TestPoint_THTPad_1.0x1.0mm_Drill0.5mm
U10, U39, U53: 7408; DIP-14_W7.62mm
U11, U33, U50, U67: 7400; DIP-14_W7.62mm
U12, U43, U51, U75, U76: 7404; DIP-14_W7.62mm
U13, U14, U21: 74S139; DIP-16_W7.62mm
U34, U41, U63, U64, U65, U66, U72: 7474; DIP-14_W7.62mm
U38, U54: 7420; DIP-14_W7.62mm
U62: 7486; DIP-14_W7.62mm
U80: 7414; DIP-14_W7.62mm

Connections:
+12V: C15.1; also elsewhere on the board
-12V: C16.1; also elsewhere on the board
GND: C1.2, C2.2, C3.2, C4.2, C5.2, C6.2, C7.2, C8.2, C9.2, C10.2, C11.2, C12.2, C13.1, C14.2, C15.2, C16.2, C17.2, C18.2, C19.2, C20.1, C21.2, C22.2, C27.2, C28.1, C29.2, C30.2, C31.2, C32.2, C33.2, C34.2, C35.2, C36.2, C37.2, C38.2, C39.2, C40.2, C41.2, C42.2, C43.2, U10.7 (GND), U11.7 (GND), U12.7 (GND), U13.8 (GND), U14.8 (GND), U21.8 (GND), U33.7 (GND), U34.7 (GND), U38.7 (GND), U39.7 (GND), U41.7 (GND), U43.7 (GND), U50.7 (GND), U51.7 (GND), U53.7 (GND), U54.7 (GND), U62.7 (GND), U63.7 (GND), U64.7 (GND), U65.7 (GND), U66.7 (GND), U67.7 (GND), U72.7 (GND), U75.7 (GND), U76.7 (GND), U80.7 (GND); also elsewhere on the board
unnamed: RN3.10 (R9.2), TP1.1
VCC: C1.1, C2.1, C3.1, C4.1, C5.1, C6.1, C7.1, C8.1, C9.1, C10.1, C11.1, C12.1, C13.2, C14.1, C17.1, C18.1, C19.1, C20.2, C21.1, C22.1, C27.1, C28.2, C29.1, C30.1, C31.1, C32.1, C33.1, C34.1, C35.1, C36.1, C37.1, C38.1, C39.1, C40.1, C41.1, C42.1, C43.1, RN3.1 (R1.1), RN4.1 (R1.1), U10.14 (VCC), U11.14 (VCC), U12.14 (VCC), U13.16 (VCC), U14.16 (VCC), U21.16 (VCC), U33.14 (VCC), U34.14 (VCC), U38.14 (VCC), U39.14 (VCC), U41.14 (VCC), U43.14 (VCC), U50.14 (VCC), U51.14 (VCC), U53.14 (VCC), U54.14 (VCC), U62.14 (VCC), U63.14 (VCC), U64.14 (VCC), U65.14 (VCC), U66.14 (VCC), U67.14 (VCC), U72.14 (VCC), U75.14 (VCC), U76.14 (VCC), U80.14 (VCC); also elsewhere on the board

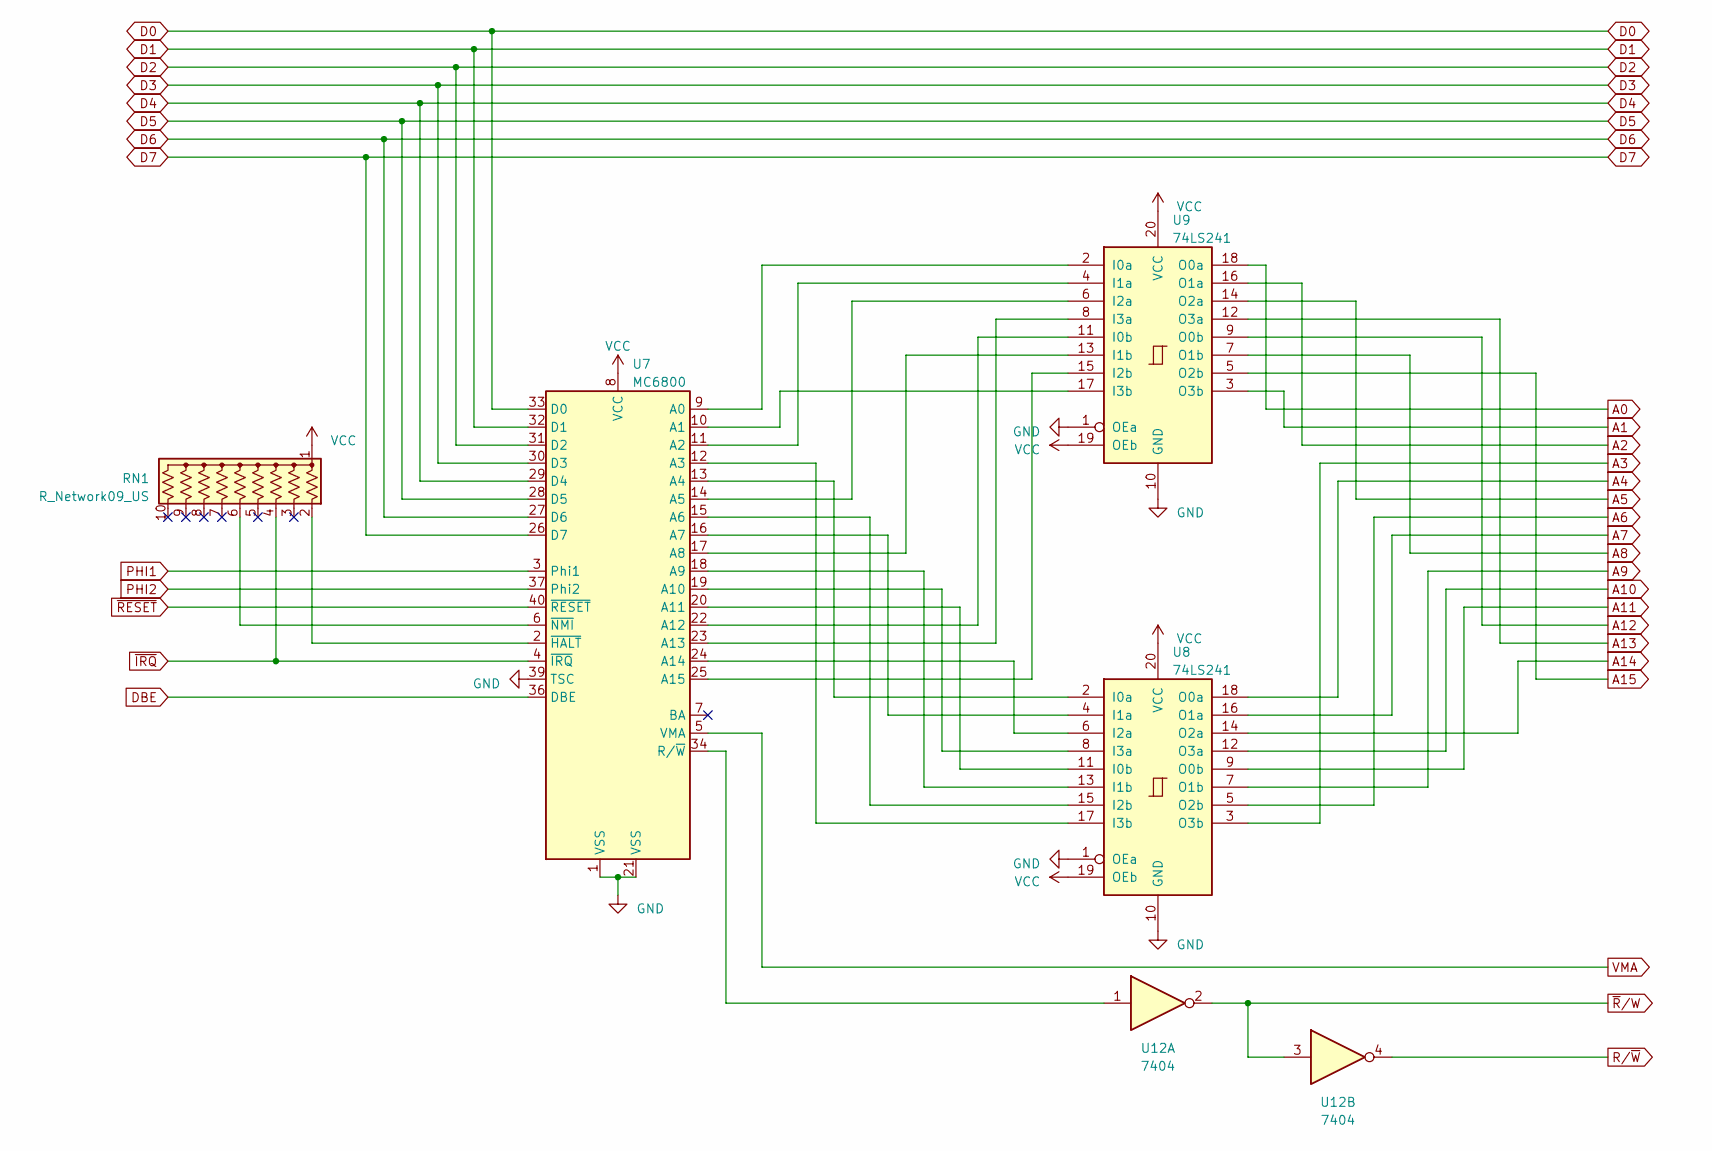
[picture p47: schematic d.kicad_sch]

Parts:
RN1: R_Network09_US; R_Array_SIP10
U7: MC6800; DIP-40_W15.24mm
U8, U9: 74LS241; DIP-20_W7.62mm
U12: 7404; DIP-14_W7.62mm

Connections:
A0: U9.18 (O0a); also elsewhere on the board
A1: U9.3 (O3b); also elsewhere on the board
A2: U9.16 (O1a); also elsewhere on the board
A3: U8.3 (O3b); also elsewhere on the board
A4: U8.18 (O0a); also elsewhere on the board
A5: U9.14 (O2a); also elsewhere on the board
A6: U8.5 (O2b); also elsewhere on the board
A7: U8.16 (O1a); also elsewhere on the board
A8: U9.7 (O1b); also elsewhere on the board
A9: U8.7 (O1b); also elsewhere on the board
A10: U8.12 (O3a); also elsewhere on the board
A11: U8.9 (O0b); also elsewhere on the board
A12: U9.9 (O0b); also elsewhere on the board
A13: U9.12 (O3a); also elsewhere on the board
A14: U8.14 (O2a); also elsewhere on the board
A15: U9.5 (O2b); also elsewhere on the board
D0: U7.33 (D0); also elsewhere on the board
D1: U7.32 (D1); also elsewhere on the board
D2: U7.31 (D2); also elsewhere on the board
D3: U7.30 (D3); also elsewhere on the board
D4: U7.29 (D4); also elsewhere on the board
D5: U7.28 (D5); also elsewhere on the board
D6: U7.27 (D6); also elsewhere on the board
D7: U7.26 (D7); also elsewhere on the board
DBE: U7.36 (DBE); also elsewhere on the board
GND: U7.1 (VSS), U7.21 (VSS), U7.39 (TSC), U8.1 (OEa), U8.10 (GND), U9.1 (OEa), U9.10 (GND); also elsewhere on the board
unnamed: RN1.2 (R1), U7.2 (~HALT)
unnamed: RN1.6 (R5), U7.6 (~NMI)
unnamed: U7.9 (A0), U9.2 (I0a)
unnamed: U7.10 (A1), U9.17 (I3b)
unnamed: U7.11 (A2), U9.4 (I1a)
unnamed: U7.12 (A3), U8.17 (I3b)
unnamed: U7.13 (A4), U8.2 (I0a)
unnamed: U7.14 (A5), U9.6 (I2a)
unnamed: U7.15 (A6), U8.15 (I2b)
unnamed: U7.16 (A7), U8.4 (I1a)
unnamed: U7.17 (A8), U9.13 (I1b)
unnamed: U7.18 (A9), U8.13 (I1b)
unnamed: U7.19 (A10), U8.8 (I3a)
unnamed: U7.20 (A11), U8.11 (I0b)
unnamed: U7.22 (A12), U9.11 (I0b)
unnamed: U7.23 (A13), U9.8 (I3a)
unnamed: U7.24 (A14), U8.6 (I2a)
unnamed: U7.25 (A15), U9.15 (I2b)
unnamed: U7.34 (R/~W), U12.1
PHI1: U7.3 (Phi1); also elsewhere on the board
PHI2: U7.37 (Phi2); also elsewhere on the board
R/~W: U12.4; also elsewhere on the board
VCC: RN1.1 (common), U7.8 (VCC), U8.19 (OEb), U8.20 (VCC), U9.19 (OEb), U9.20 (VCC); also elsewhere on the board
VMA: U7.5 (VMA); also elsewhere on the board
~IRQ: RN1.4 (R3), U7.4 (~IRQ); also elsewhere on the board
~RESET: U7.40 (~RESET); also elsewhere on the board
~R/W: U12.2, U12.3; also elsewhere on the board

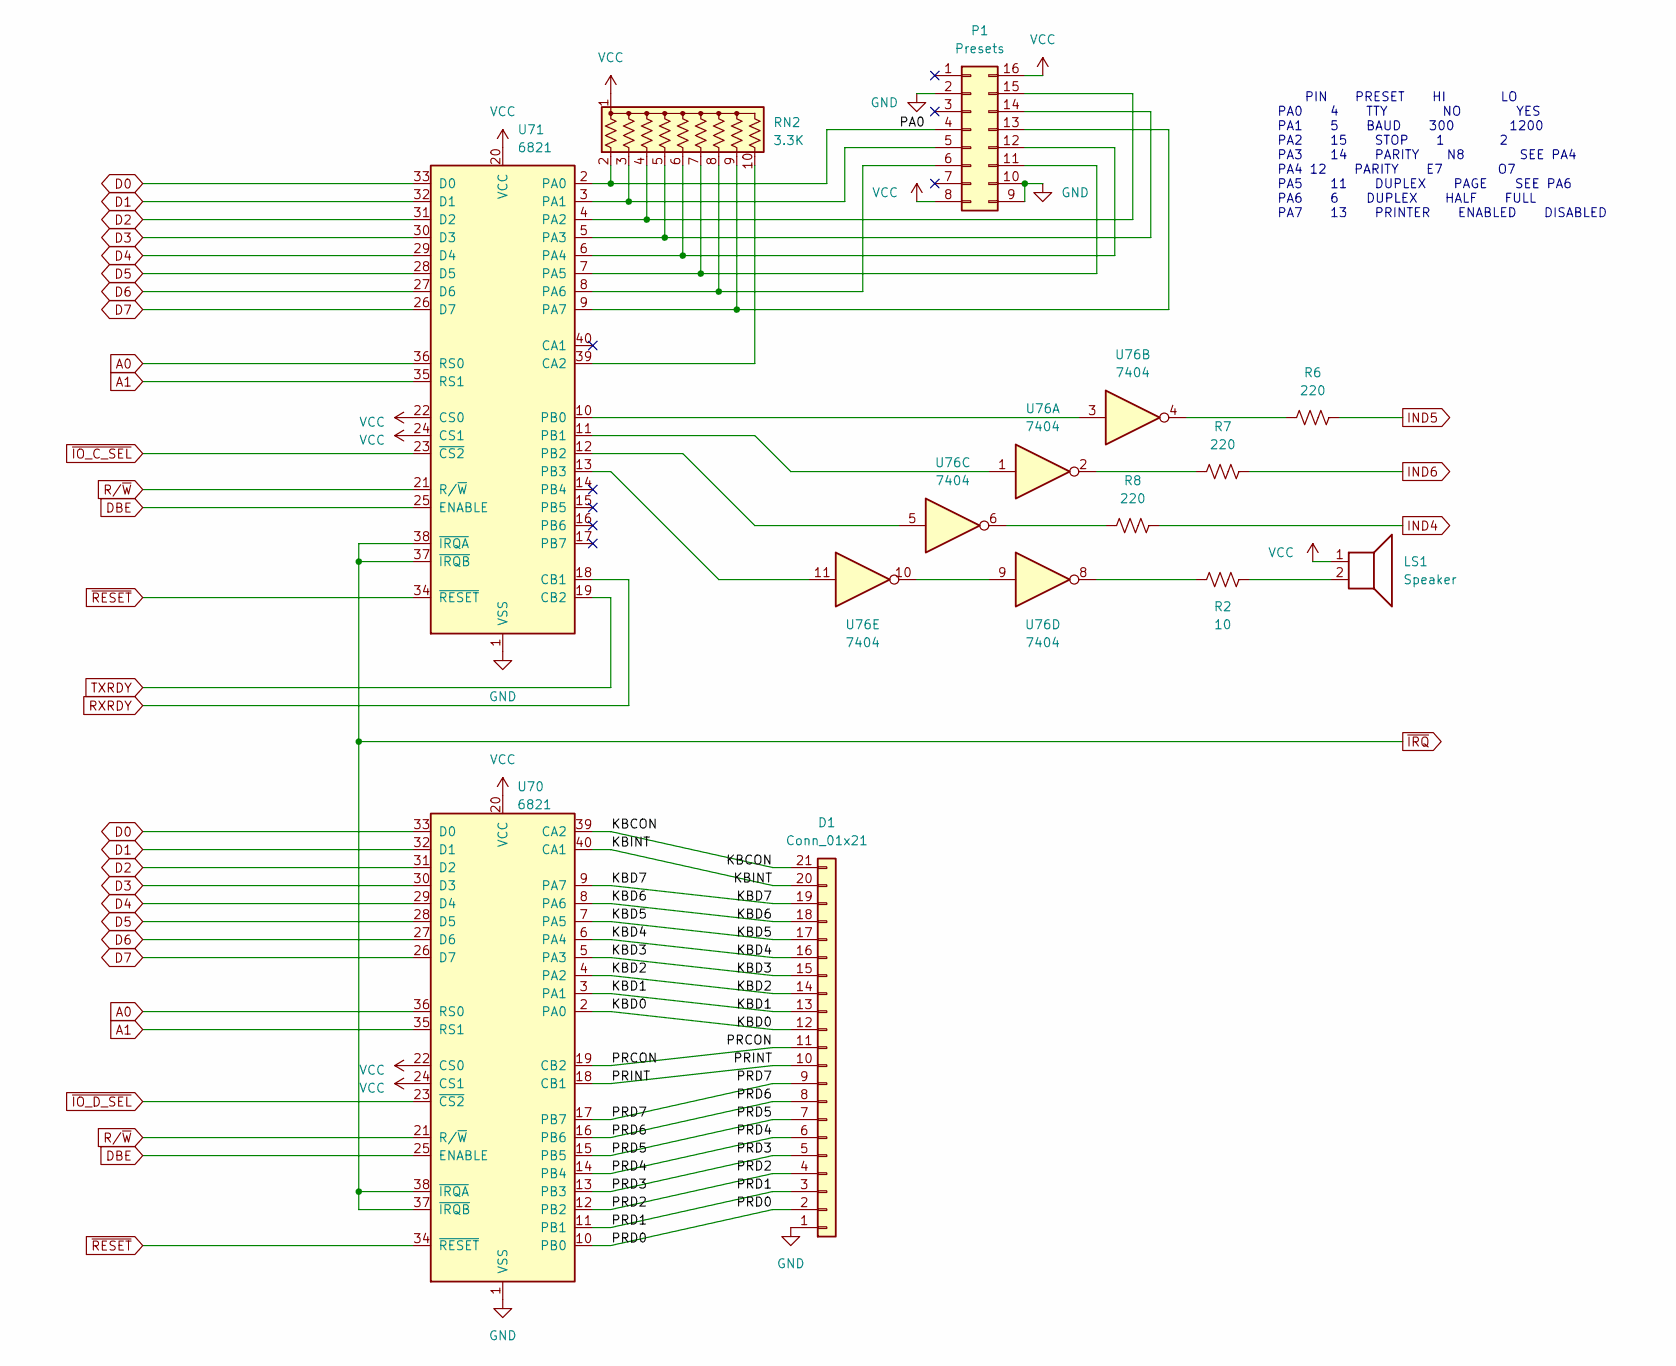
[picture p48: schematic ioc.kicad_sch]

Parts:
D1: Conn_01x21; SolderWire-0.75sqmm_1x021_P3.96mm_D1.25mm_OD2.3mm
LS1: Speaker; Buzzer_15x7.5RM7.6
P1: Presets; DIP-16_W7.62mm
R2: 10; R_Axial_DIN0309_L9.0mm_D3.2mm_P12.70mm_Horizontal
R6, R7, R8: 220; R_Axial_DIN0309_L9.0mm_D3.2mm_P12.70mm_Horizontal
RN2: 3.3K; R_Array_SIP10
U70, U71: 6821; DIP-40_W15.24mm
U76: 7404; DIP-14_W7.62mm

Connections:
/IO/KBCON: D1.21, U70.39 (CA2)
/IO/KBD0: D1.12, U70.2 (PA0)
/IO/KBD1: D1.13, U70.3 (PA1)
/IO/KBD2: D1.14, U70.4 (PA2)
/IO/KBD3: D1.15, U70.5 (PA3)
/IO/KBD4: D1.16, U70.6 (PA4)
/IO/KBD5: D1.17, U70.7 (PA5)
/IO/KBD6: D1.18, U70.8 (PA6)
/IO/KBD7: D1.19, U70.9 (PA7)
/IO/KBINT: D1.20, U70.40 (CA1)
/IO/PA0: P1.4, RN2.2 (R1), U71.2 (PA0)
/IO/PRCON: D1.11, U70.19 (CB2)
/IO/PRD0: D1.2, U70.10 (PB0)
/IO/PRD1: D1.3, U70.11 (PB1)
/IO/PRD2: D1.4, U70.12 (PB2)
/IO/PRD3: D1.5, U70.13 (PB3)
/IO/PRD4: D1.6, U70.14 (PB4)
/IO/PRD5: D1.7, U70.15 (PB5)
/IO/PRD6: D1.8, U70.16 (PB6)
/IO/PRD7: D1.9, U70.17 (PB7)
/IO/PRINT: D1.10, U70.18 (CB1)
A0: U70.36 (RS0), U71.36 (RS0); also elsewhere on the board
A1: U70.35 (RS1), U71.35 (RS1); also elsewhere on the board
D0: U70.33 (D0), U71.33 (D0); also elsewhere on the board
D1: U70.32 (D1), U71.32 (D1); also elsewhere on the board
D2: U70.31 (D2), U71.31 (D2); also elsewhere on the board
D3: U70.30 (D3), U71.30 (D3); also elsewhere on the board
D4: U70.29 (D4), U71.29 (D4); also elsewhere on the board
D5: U70.28 (D5), U71.28 (D5); also elsewhere on the board
D6: U70.27 (D6), U71.27 (D6); also elsewhere on the board
D7: U70.26 (D7), U71.26 (D7); also elsewhere on the board
DBE: U70.25 (ENABLE), U71.25 (ENABLE); also elsewhere on the board
GND: D1.1, P1.2, P1.9, P1.10, U70.1 (VSS), U71.1 (VSS); also elsewhere on the board
IND4: R8.2; also elsewhere on the board
IND5: R6.2; also elsewhere on the board
IND6: R7.2; also elsewhere on the board
unnamed: LS1.2, R2.2
unnamed: P1.5, RN2.3 (R2), U71.3 (PA1)
unnamed: P1.6, RN2.8 (R7), U71.8 (PA6)
unnamed: P1.11, RN2.7 (R6), U71.7 (PA5)
unnamed: P1.12, RN2.6 (R5), U71.6 (PA4)
unnamed: P1.13, RN2.9 (R8), U71.9 (PA7)
unnamed: P1.14, RN2.5 (R4), U71.5 (PA3)
unnamed: P1.15, RN2.4 (R3), U71.4 (PA2)
unnamed: R2.1, U76.8
unnamed: R6.1, U76.4
unnamed: R7.1, U76.2
unnamed: R8.1, U76.6
unnamed: RN2.10 (R9), U71.39 (CA2)
unnamed: U71.10 (PB0), U76.3
unnamed: U71.11 (PB1), U76.1
unnamed: U71.12 (PB2), U76.5
unnamed: U71.13 (PB3), U76.11
unnamed: U76.9, U76.10
RXRDY: U71.18 (CB1); also elsewhere on the board
R/~W: U70.21 (R/~W), U71.21 (R/~W); also elsewhere on the board
TXRDY: U71.19 (CB2); also elsewhere on the board
VCC: LS1.1, P1.8, P1.16, RN2.1 (common), U70.20 (VCC), U70.22 (CS0), U70.24 (CS1), U71.20 (VCC), U71.22 (CS0), U71.24 (CS1); also elsewhere on the board
~IO_C_SEL: U71.23 (~CS2); also elsewhere on the board
~IO_D_SEL: U70.23 (~CS2); also elsewhere on the board
~IRQ: U70.37 (~IRQB), U70.38 (~IRQA), U71.37 (~IRQB), U71.38 (~IRQA); also elsewhere on the board
~RESET: U70.34 (~RESET), U71.34 (~RESET); also elsewhere on the board

Notes on the sheet:
PIN PRESET HI LO PA0 4 TTY NO YES PA1 5 BAUD 300 1200 PA2 15 STOP 1 2 PA3 14 PARITY N8 SEE PA4 PA4 12 PARITY E7 O7 PA5 11 DUPLEX PAGE SEE PA6 PA6 6 DUPLEX HALF FULL PA7 13 PRINTER ENABLED DISABLED

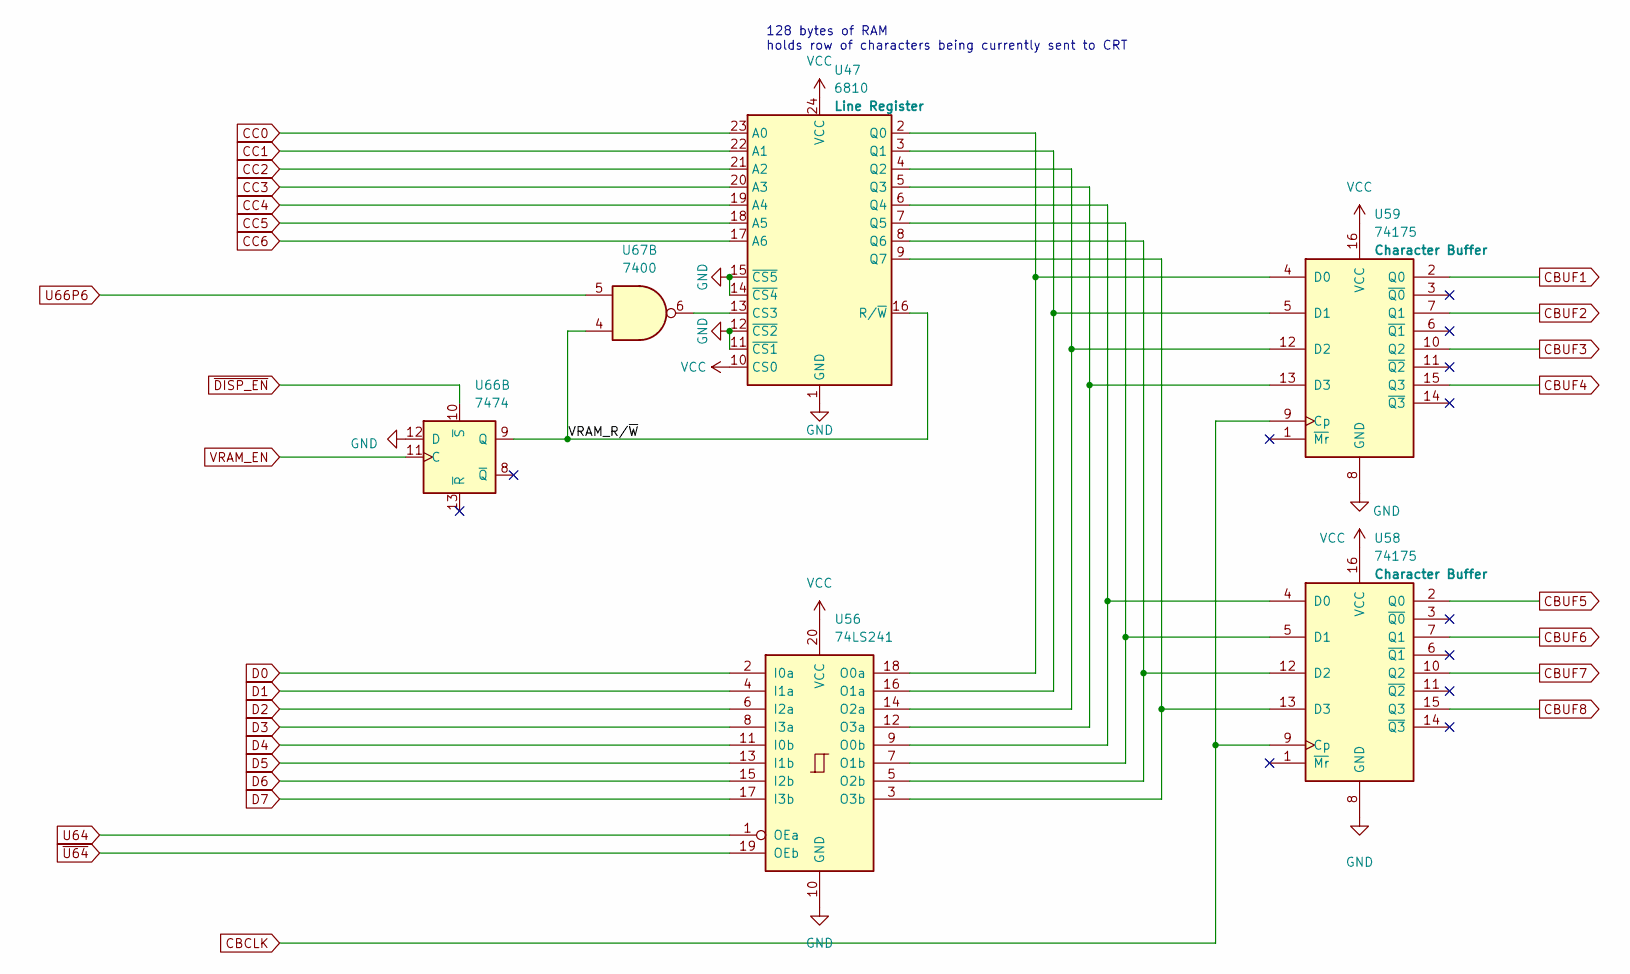
[picture p49: schematic memcbuf.kicad_sch]

Parts:
U47: 6810; DIP-24_W15.24mm
U56: 74LS241; DIP-20_W7.62mm
U58, U59: 74175; DIP-16_W7.62mm
U66: 7474; DIP-14_W7.62mm
U67: 7400; DIP-14_W7.62mm

Connections:
/From Memory to Character Buffer/VRAM_R/~W: U47.16 (R/~W), U66.9 (Q), U67.4
CBCLK: U58.9 (Cp), U59.9 (Cp); also elsewhere on the board
CBUF1: U59.2 (Q0); also elsewhere on the board
CBUF2: U59.7 (Q1); also elsewhere on the board
CBUF3: U59.10 (Q2); also elsewhere on the board
CBUF4: U59.15 (Q3); also elsewhere on the board
CBUF5: U58.2 (Q0); also elsewhere on the board
CBUF6: U58.7 (Q1); also elsewhere on the board
CBUF7: U58.10 (Q2); also elsewhere on the board
CBUF8: U58.15 (Q3); also elsewhere on the board
CC0: U47.23 (A0); also elsewhere on the board
CC1: U47.22 (A1); also elsewhere on the board
CC2: U47.21 (A2); also elsewhere on the board
CC3: U47.20 (A3); also elsewhere on the board
CC4: U47.19 (A4); also elsewhere on the board
CC5: U47.18 (A5); also elsewhere on the board
CC6: U47.17 (A6); also elsewhere on the board
D0: U56.2 (I0a); also elsewhere on the board
D1: U56.4 (I1a); also elsewhere on the board
D2: U56.6 (I2a); also elsewhere on the board
D3: U56.8 (I3a); also elsewhere on the board
D4: U56.11 (I0b); also elsewhere on the board
D5: U56.13 (I1b); also elsewhere on the board
D6: U56.15 (I2b); also elsewhere on the board
D7: U56.17 (I3b); also elsewhere on the board
GND: U47.1 (GND), U47.11 (~CS1), U47.12 (~CS2), U47.14 (~CS4), U47.15 (~CS5), U56.10 (GND), U58.8 (GND), U59.8 (GND), U66.12 (D); also elsewhere on the board
unnamed: U47.13 (CS3), U67.6
unnamed: U47.2 (Q0), U56.18 (O0a), U59.4 (D0)
unnamed: U47.3 (Q1), U56.16 (O1a), U59.5 (D1)
unnamed: U47.4 (Q2), U56.14 (O2a), U59.12 (D2)
unnamed: U47.5 (Q3), U56.12 (O3a), U59.13 (D3)
unnamed: U47.6 (Q4), U56.9 (O0b), U58.4 (D0)
unnamed: U47.7 (Q5), U56.7 (O1b), U58.5 (D1)
unnamed: U47.8 (Q6), U56.5 (O2b), U58.12 (D2)
unnamed: U47.9 (Q7), U56.3 (O3b), U58.13 (D3)
U64: U56.1 (OEa); also elsewhere on the board
U66P6: U67.5; also elsewhere on the board
VCC: U47.10 (CS0), U47.24 (VCC), U56.20 (VCC), U58.16 (VCC), U59.16 (VCC); also elsewhere on the board
VRAM_EN: U66.11 (C); also elsewhere on the board
~DISP_EN: U66.10 (~S); also elsewhere on the board
~U64: U56.19 (OEb); also elsewhere on the board

Notes on the sheet:
128 bytes of RAM holds row of characters being currently sent to CRT
