btb/Telcon-Ambassador/boards/mainboard/mainboard.kicad_pcb

## KiCad design boards/mainboard/mainboard.kicad_pcb (continued)

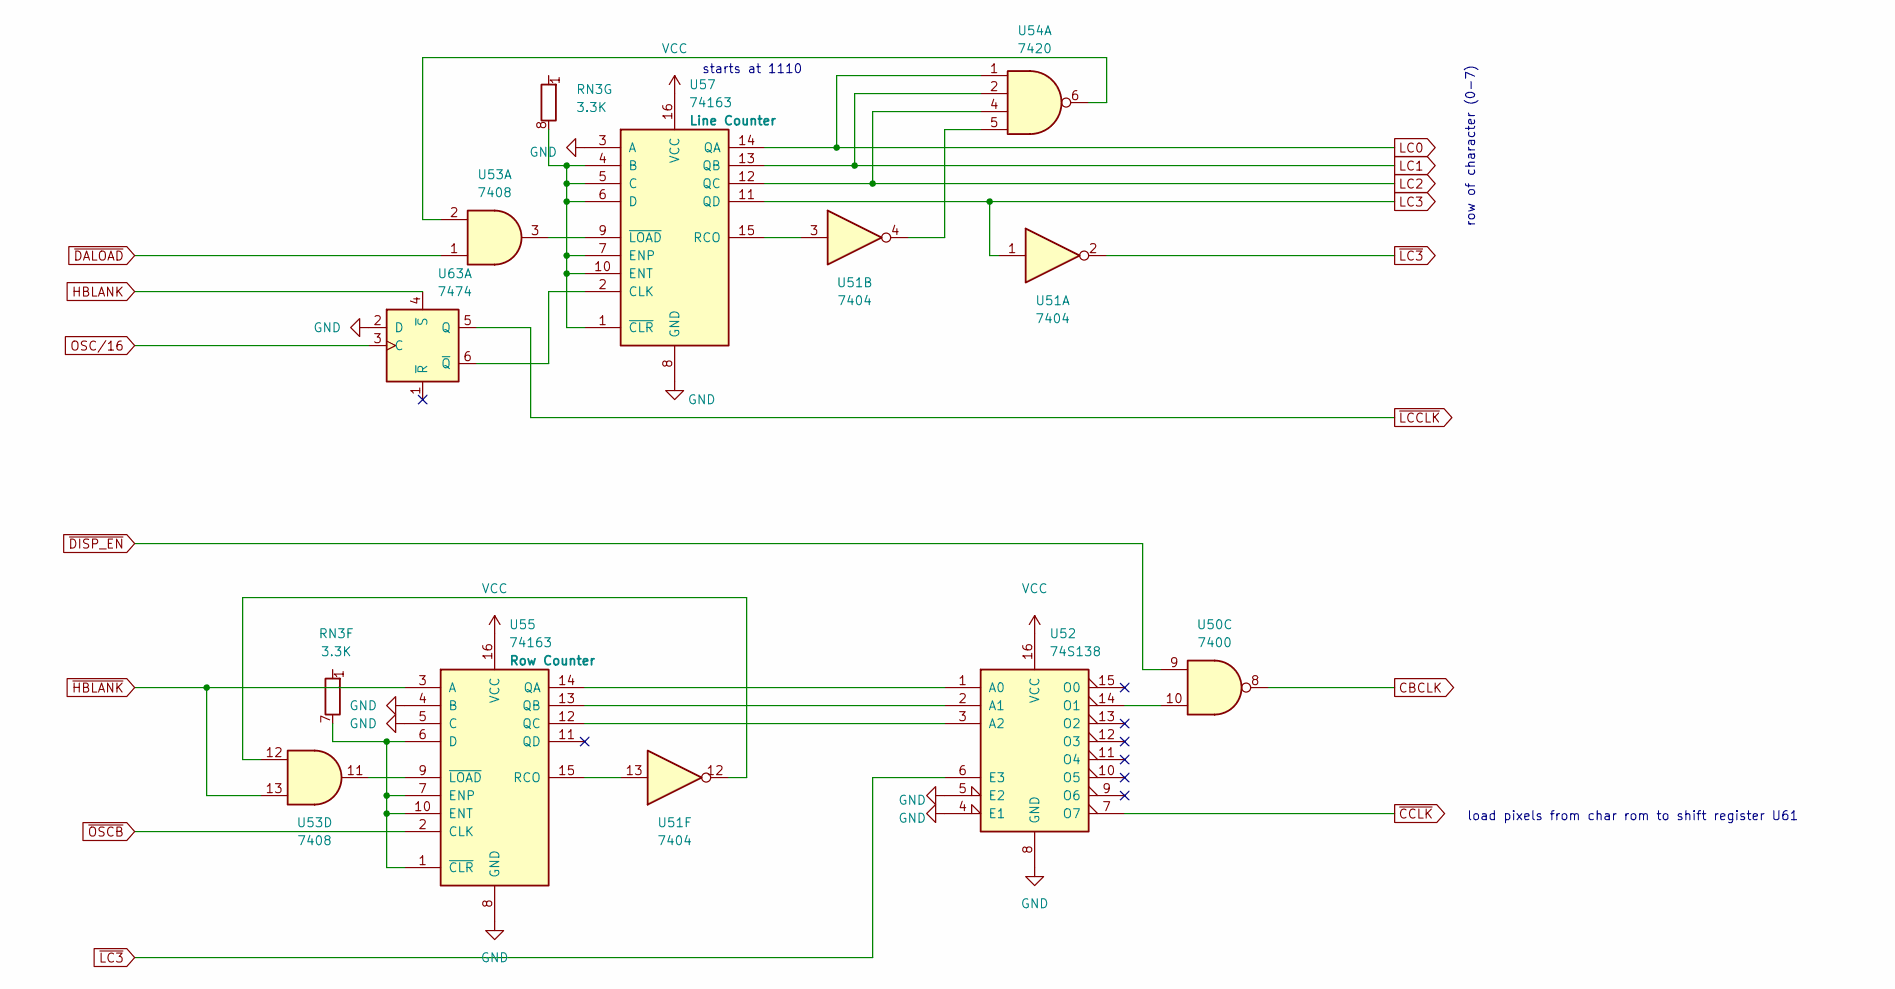
[picture p50: schematic line.kicad_sch]

Parts:
RN3: 3.3K; R_Array_SIP10
U50: 7400; DIP-14_W7.62mm
U51: 7404; DIP-14_W7.62mm
U52: 74S138; DIP-16_W7.62mm
U53: 7408; DIP-14_W7.62mm
U54: 7420; DIP-14_W7.62mm
U55, U57: 74163; DIP-16_W7.62mm
U63: 7474; DIP-14_W7.62mm

Connections:
CBCLK: U50.8; also elsewhere on the board
GND: U52.4 (E1), U52.5 (E2), U52.8 (GND), U55.4 (B), U55.5 (C), U55.8 (GND), U57.3 (A), U57.8 (GND), U63.2 (D); also elsewhere on the board
HBLANK: U63.4 (~S); also elsewhere on the board
LC0: U54.1, U57.14 (QA); also elsewhere on the board
LC1: U54.2, U57.13 (QB); also elsewhere on the board
LC2: U54.4, U57.12 (QC); also elsewhere on the board
LC3: U51.1, U57.11 (QD); also elsewhere on the board
unnamed: RN3.7 (R6.2), U55.1 (~CLR), U55.6 (D), U55.7 (ENP), U55.10 (ENT)
unnamed: RN3.8 (R7.2), U57.1 (~CLR), U57.4 (B), U57.5 (C), U57.6 (D), U57.7 (ENP), U57.10 (ENT)
unnamed: U51.4, U54.5
unnamed: U51.12, U53.12
unnamed: U52.1 (A0), U55.14 (QA)
unnamed: U52.2 (A1), U55.13 (QB)
unnamed: U52.3 (A2), U55.12 (QC)
unnamed: U50.10, U52.14 (O1)
unnamed: U53.2, U54.6
unnamed: U51.13, U55.15 (RCO)
unnamed: U53.11, U55.9 (~LOAD)
unnamed: U57.2 (CLK), U63.6 (~Q)
unnamed: U51.3, U57.15 (RCO)
unnamed: U53.3, U57.9 (~LOAD)
OSC/16: U63.3 (C); also elsewhere on the board
VCC: U52.16 (VCC), U55.16 (VCC), U57.16 (VCC); also elsewhere on the board
~CCLK: U52.7 (O7); also elsewhere on the board
~DALOAD: U53.1; also elsewhere on the board
~DISP_EN: U50.9; also elsewhere on the board
~HBLANK: U53.13, U55.3 (A); also elsewhere on the board
~LC3: U51.2, U52.6 (E3); also elsewhere on the board
~LCCLK: U63.5 (Q); also elsewhere on the board
~OSCB: U55.2 (CLK); also elsewhere on the board

Notes on the sheet:
starts at 1110
load pixels from char rom to shift register U61
row of character (0-7)

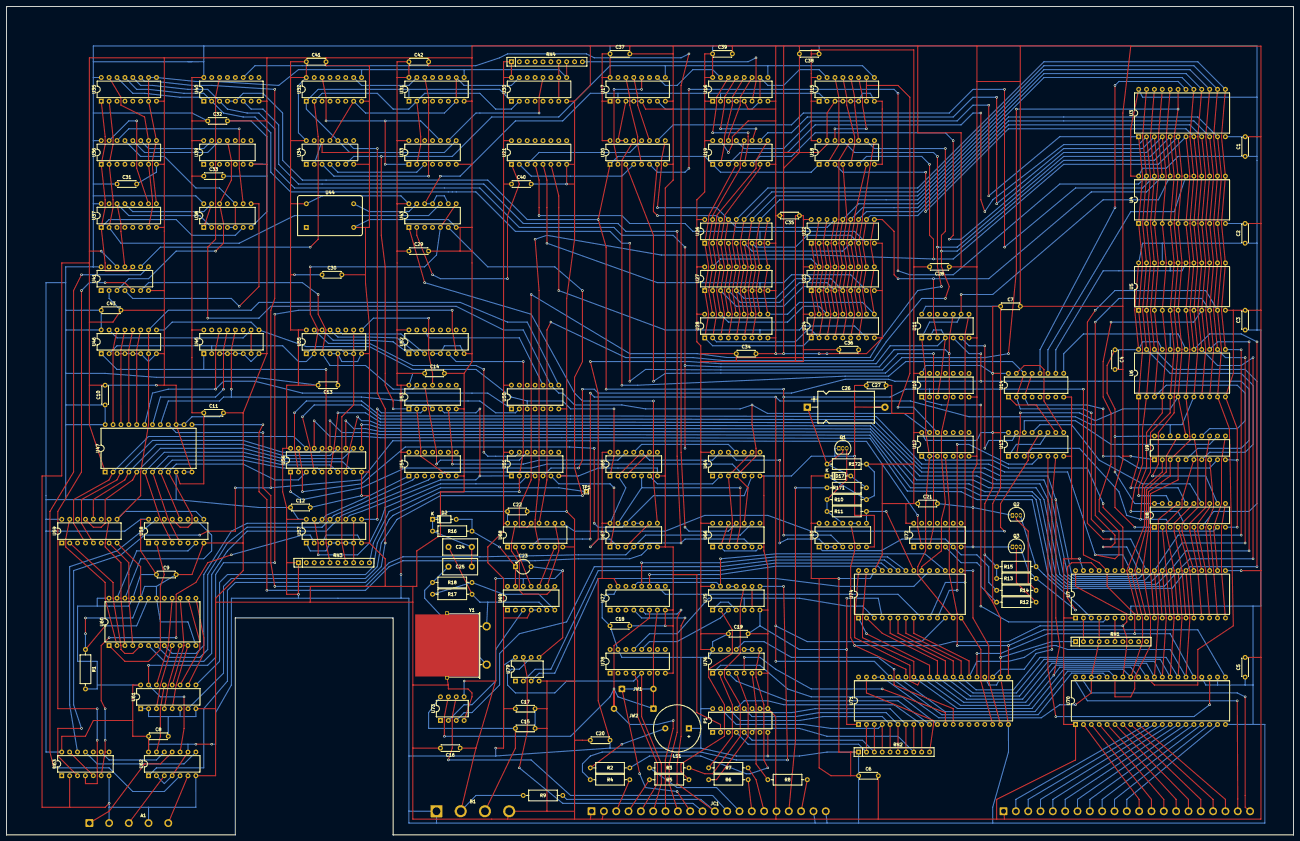
[picture p51: board mainboard.kicad_pcb from above]

Board: 2 copper layers, 414.3 x 266.7 mm, 155 parts (0 on the bottom side), 301 nets.
