btb/Telcon-Ambassador/(commit log)

2023-04-23 Add keyboard PCB project
    [key_matrix.kicad_sch, keyboard.kicad_pcb, keyboard.kicad_sch]
2023-04-24 simplify/correct keyboard schematics
    [key_matrix.kicad_sch, keyboard.kicad_pcb, keyboard.kicad_sch]
2023-04-24 keyboard schematic rev 1
    [key_matrix.kicad_sch, keyboard.kicad_pcb, keyboard.kicad_sch]
2023-04-24 schematic pdf
2023-04-25 compress schematic
    [keyboard.kicad_sch]
2023-04-25 add Makefile for printer ROM
2023-05-10 add printer schematic
    [printer.kicad_sch]
2023-05-13 add mainboard schematic
    [30.kicad_sch, a.kicad_sch, clock.kicad_sch, control.kicad_sch, counter.kicad_sch, d.kicad_sch, ioc.kicad_sch, mainboard.kicad_sch]
2023-05-27 organize mainboard schematic
    [30.kicad_sch, a.kicad_sch, clock.kicad_sch, column.kicad_sch, control.kicad_sch, counter.kicad_sch, d.kicad_sch, ioc.kicad_sch]
2024-08-21 add missing bracket
2024-08-22 Update to KiCad 8
    [30.kicad_sch, clock.kicad_sch, column.kicad_sch, control.kicad_sch, counter.kicad_sch, d.kicad_sch, ioc.kicad_sch, key_matrix.kicad_sch]
2024-08-22 add printer specifications
2024-08-22 add schematic pdfs
